cyuxSz/Argos-equipo/5_expo/README.md

# 5 · ExpoIngenierías y entregables

Encargados: todo el equipo. Plan del frente: [PLAN.md, Frente 5](../PLAN.md#frente-5--expoingenierías-entregables-y-coordinación).

Fuente: convocatoria de la 28.ª edición y página oficial https://expoingenierias-mty.github.io/pagina-inicio/ (resumen propio; ante cualquier duda manda la convocatoria).

## Fechas

| Fecha | Qué |
|---|---|
| lun 9 nov | Aviso de proyectos preseleccionados (por correo) |
| mar 10 nov | Arranque del equipo |
| mar 17 nov | Grabación del video |
| jue 19 nov | Video, reporte y perfil listos; meta: subirlos esa noche |
| **vie 20 nov, 23:59** | Límite para subir **video**, **reporte técnico** y **perfil del proyecto** |
| **mar 24 nov** | Subir la **foto de cada integrante**; aviso de seleccionados y stand |
| mié 25 – lun 30 nov | Muestra y concurso virtual |
| mar 1 dic, 12:00–17:00 | Concurso presencial en Arena Borregos; premiación a las 19:00 en Aulas 6 |

Categoría: **Desarrollo de prototipo físico** `[POR CONFIRMAR con el registro]`. El jurado pregunta qué se desarrolló, qué tan creativo es, si el prototipo funciona de forma robusta y consistente, qué técnicas de ingeniería se aplicaron y qué impacto tiene.

## Checklist del video (Anexo 4)

- [ ] MP4, entre **3 y 5 minutos**, nombre del archivo de **30 caracteres o menos**.
- [ ] Explicación con voz del equipo (no generado todo con IA); mostrar el proyecto **y** explicarlo.
- [ ] Presentación: nombre del proyecto, integrantes, profesor(es) tutor(es), nivel (profesional) y materia.
- [ ] Problema o necesidad.
- [ ] Qué es el proyecto, qué resuelve y cómo.
- [ ] Por qué es innovador.
- [ ] Alcance.
- [ ] Técnicas y herramientas de ingeniería, con diagramas o gráficas.
- [ ] Resultados más relevantes y conclusión.
- [ ] Impacto en la industria o la sociedad.
- [ ] Descripción del prototipo: características físicas, técnicas y de diseño.
- [ ] Demostración de que funciona igual siempre, de preferencia sobre fondo blanco.
- [ ] Imágenes o fragmentos de las pruebas.

## Checklist del reporte técnico (Anexo 5)

PDF, nombre de 30 caracteres o menos. Puede ser el reporte de la materia. Rubros recomendados: resumen, introducción, contexto, delimitación, planteamiento del problema, justificación, marco teórico, objetivos (general y específicos), hipótesis, metodología, técnicas y herramientas, infraestructura, recursos, resultados, conclusiones, bibliografía (APA 7) y anexos.

## Checklist del perfil (Anexo 6)

- [ ] **3 imágenes del proyecto** (la 1, de preferencia un GIF animado). Sin video y sin PDF.
- [ ] **Ninguna foto de integrantes** en estas imágenes (es motivo de descalificación).
- [ ] Imagen de fondo para la muestra virtual (PNG o JPG).
- [ ] Logo del equipo (opcional).

Material disponible: renders en `2_carcasas_3d/renders/`, diagramas en `diagramas/`, protoboard y esquemáticos en `1_electronica/`, modelo del cuarto en `2_carcasas_3d/modelo_cuarto/`.

## Fotos de integrantes

- [ ] Una por integrante, antes del 24 de nov (van aparte del perfil).

## Stand (1 dic)

Demo que no dependa del WiFi del lugar: laptop con el servidor, router propio, las 3 cajas y algo para provocar alertas (aire caliente o hielo para el DHT22, un imán para el MC-38, un golpe suave al anaquel de prueba). Si el hardware no está listo, demo con el simulador y el dashboard.

## Archivos

- [guion.md](guion.md): plantilla del guion del video.
- [preguntas_pendientes.md](preguntas_pendientes.md): preguntas para profesores y encargados del invernadero.
