cyuxSz/Argos-equipo/5_expo/guion.md

# Guion del video (plantilla, 4:30 min)

Llenar cada bloque con quién habla, qué se dice y qué se ve. Tiempos aproximados; total entre 3 y 5 min.

| # | Tiempo | Bloque | Qué se ve | Quién | Texto (borrador) |
|---|---|---|---|---|---|
| 1 | 0:00–0:20 | Presentación | Logo, nombre, integrantes, tutor(es), materia | | |
| 2 | 0:20–0:50 | Problema | Fotos del cuarto de incubación, frascos, temporizador mecánico | | |
| 3 | 0:50–1:20 | Solución | Diagrama de arquitectura | | |
| 4 | 1:20–1:40 | Innovación y alcance | | | |
| 5 | 1:40–2:40 | Técnicas de ingeniería | Esquemáticos, protoboard, CAD, BD, MQTT | | |
| 6 | 2:40–3:40 | Prototipo y demostración | Cajas (reales o renders), simulador, dashboard, alerta en el celular, fondo blanco | | |
| 7 | 3:40–4:10 | Resultados | Pruebas: tablas, capturas, gráficas | | |
| 8 | 4:10–4:30 | Impacto y cierre | | | |

Tomas que hay que grabar o capturar:

- [ ] Dashboard con datos en vivo (simulador o nodos reales).
- [ ] Alerta llegando al celular (WhatsApp o Telegram).
- [ ] Monitor serie o MQTT Explorer mostrando mensajes.
- [ ] Giro del modelo 3D en el visor.
- [ ] Cajas reales funcionando sobre fondo blanco (si llega el hardware).
