cyuxSz/Argos-equipo/1_electronica/esquematicos/nodo_luz_rele.png

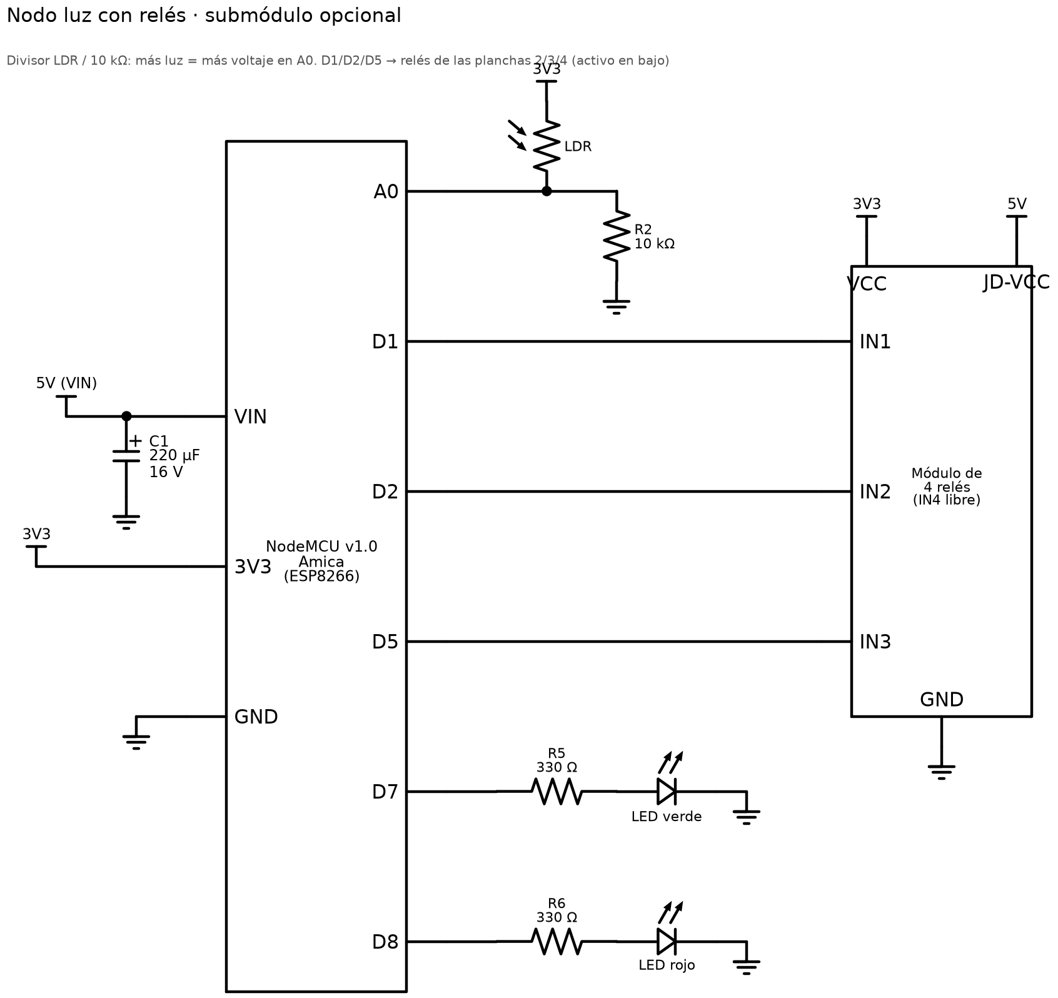
1_electronica/esquematicos/nodo_luz_rele.png
