cyuxSz/Argos-equipo/1_electronica/fritzing/nodo_acel_breadboard.png

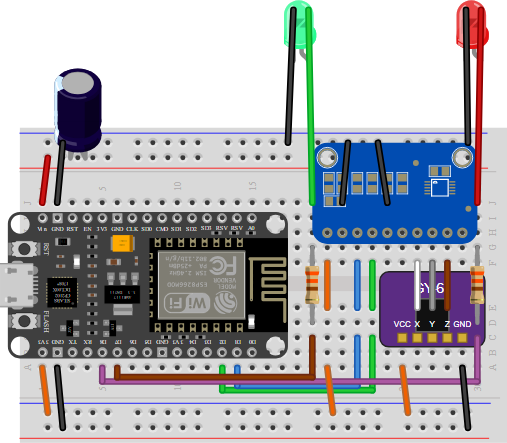
1_electronica/fritzing/nodo_acel_breadboard.png
