cyuxSz/Argos-equipo/1_electronica/fritzing/nodo_acel_schematic.png

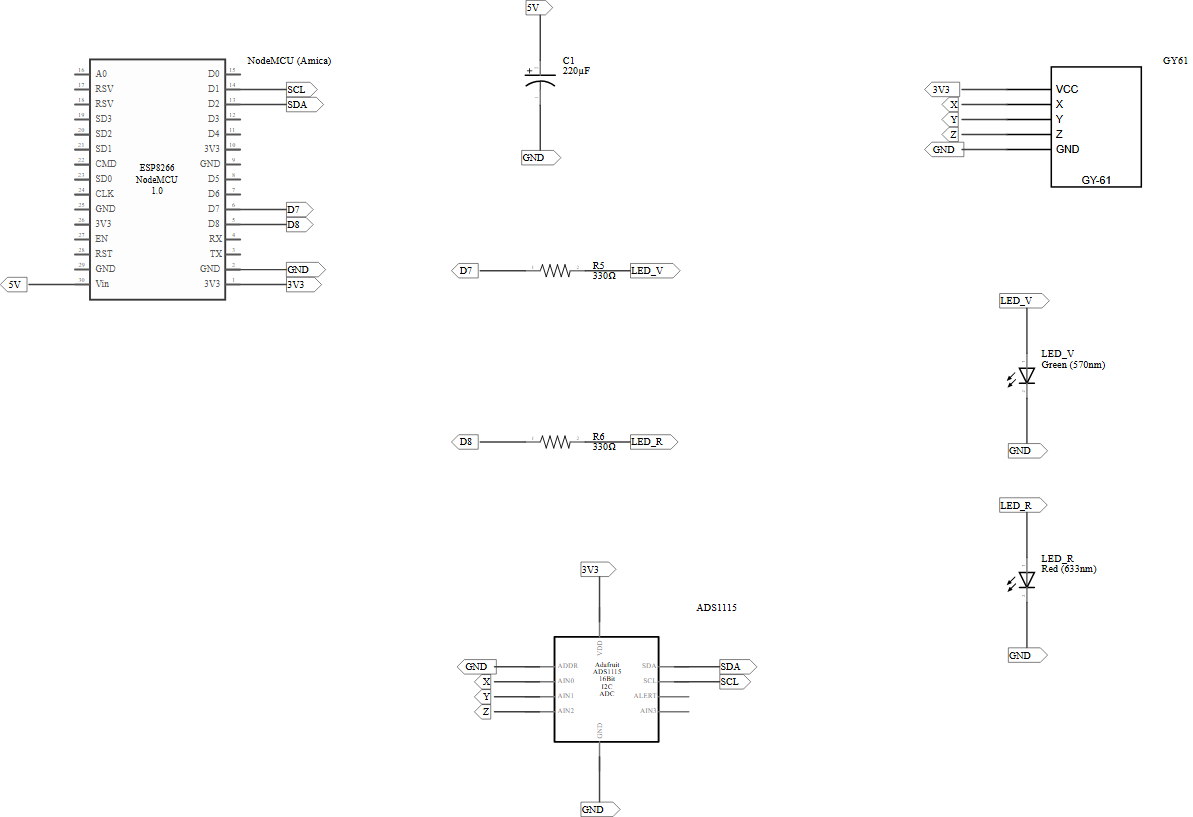
1_electronica/fritzing/nodo_acel_schematic.png
