cyuxSz/Argos-equipo/1_electronica/fritzing/nodo_dht_breadboard.png

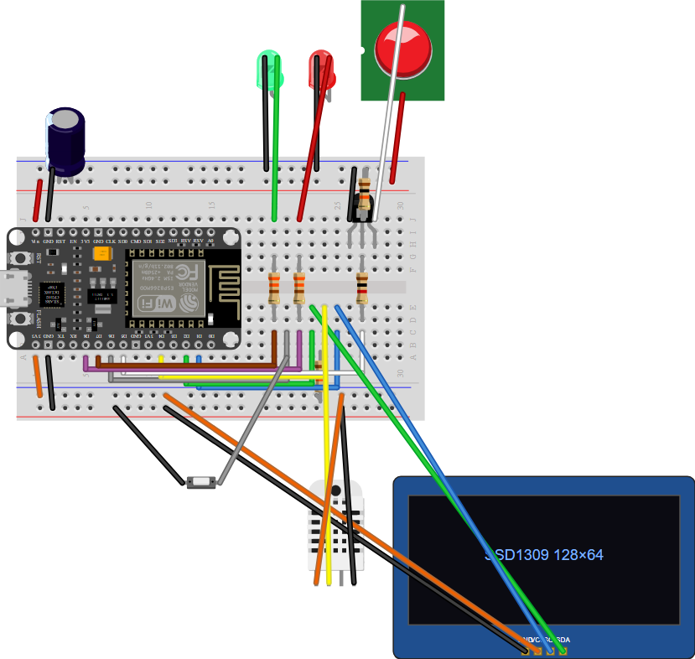
1_electronica/fritzing/nodo_dht_breadboard.png
