cyuxSz/Argos-equipo/1_electronica/fritzing/nodo_dht_schematic.png

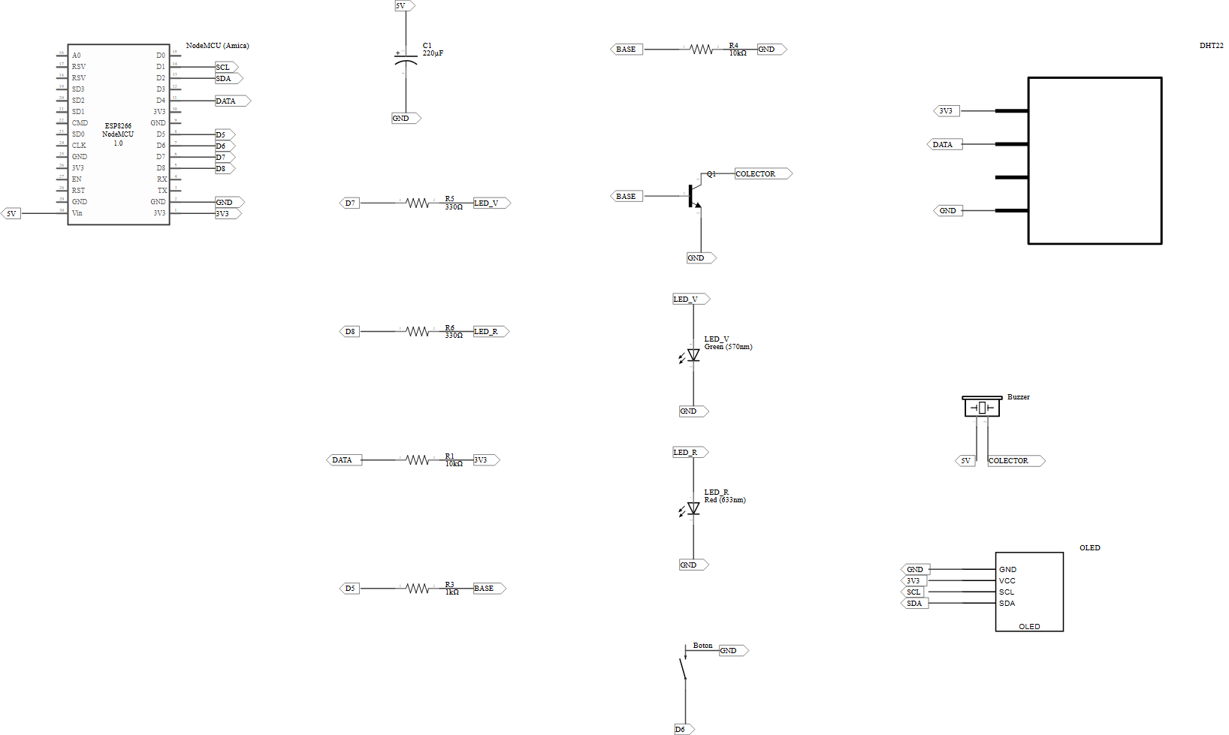
1_electronica/fritzing/nodo_dht_schematic.png
