cyuxSz/Argos-equipo/1_electronica/fritzing/nodo_luz_breadboard.png

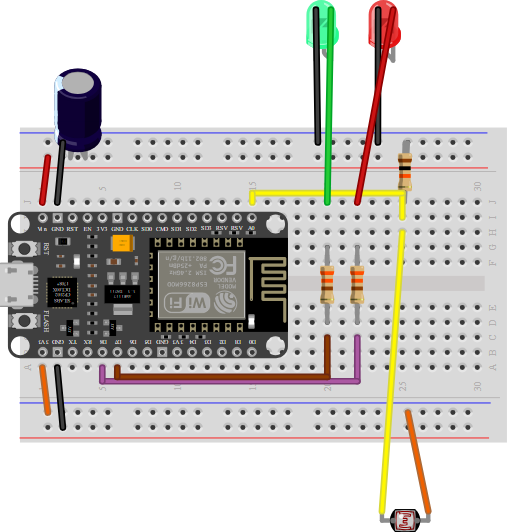
1_electronica/fritzing/nodo_luz_breadboard.png
