cyuxSz/Argos-equipo/1_electronica/fritzing/nodo_luz_schematic.png

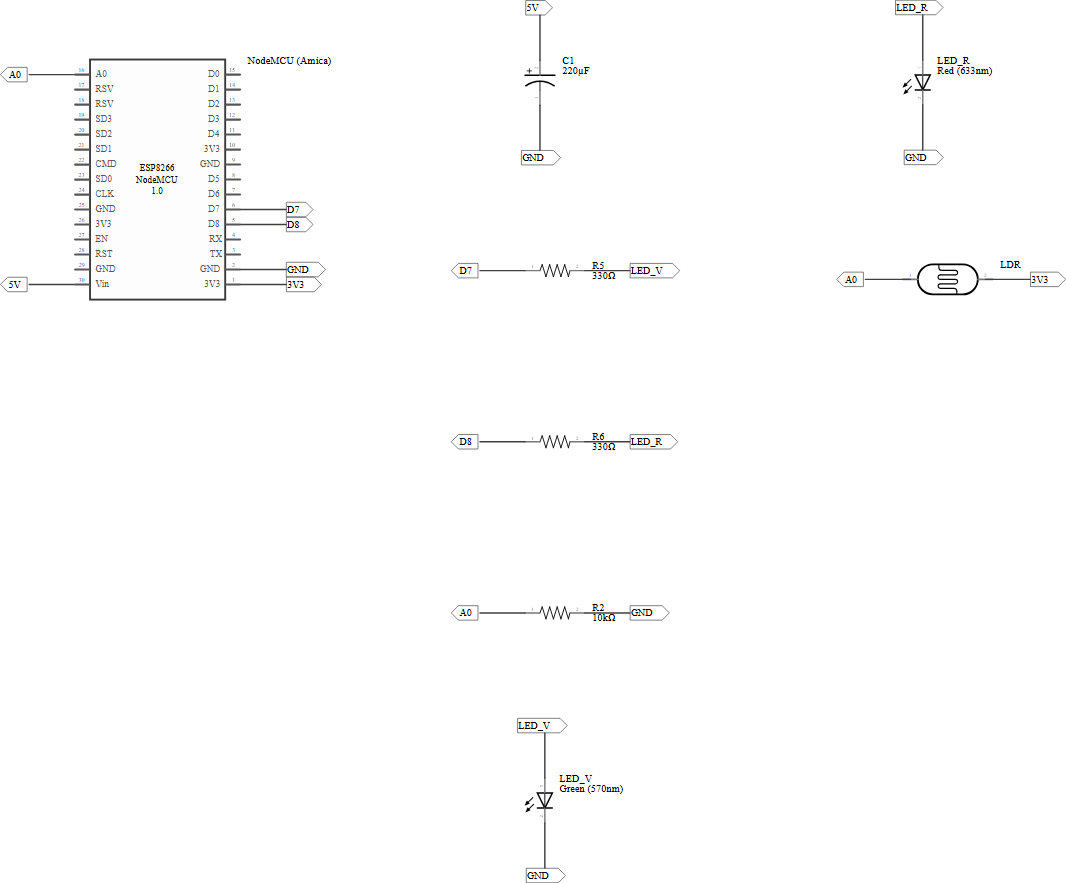
1_electronica/fritzing/nodo_luz_schematic.png
