cyuxSz/Argos-equipo/1_electronica/fritzing/nodo_pir_breadboard.png

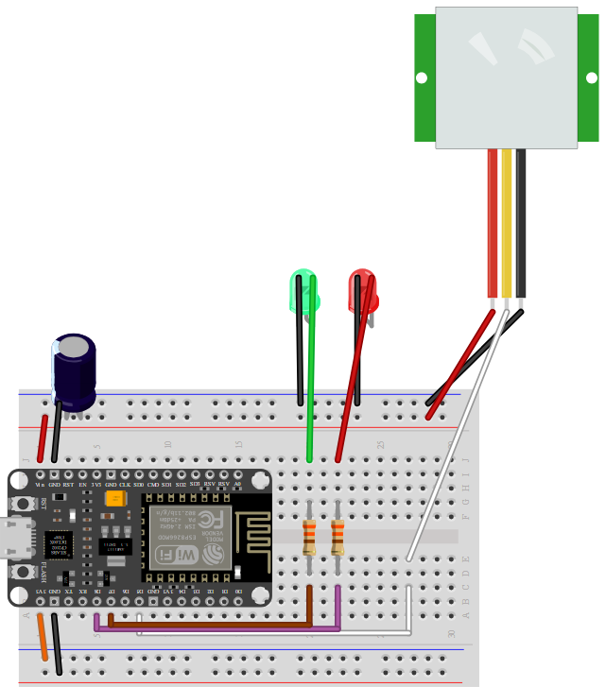
1_electronica/fritzing/nodo_pir_breadboard.png
