cyuxSz/Argos-equipo/1_electronica/fritzing/nodo_pir_schematic.png

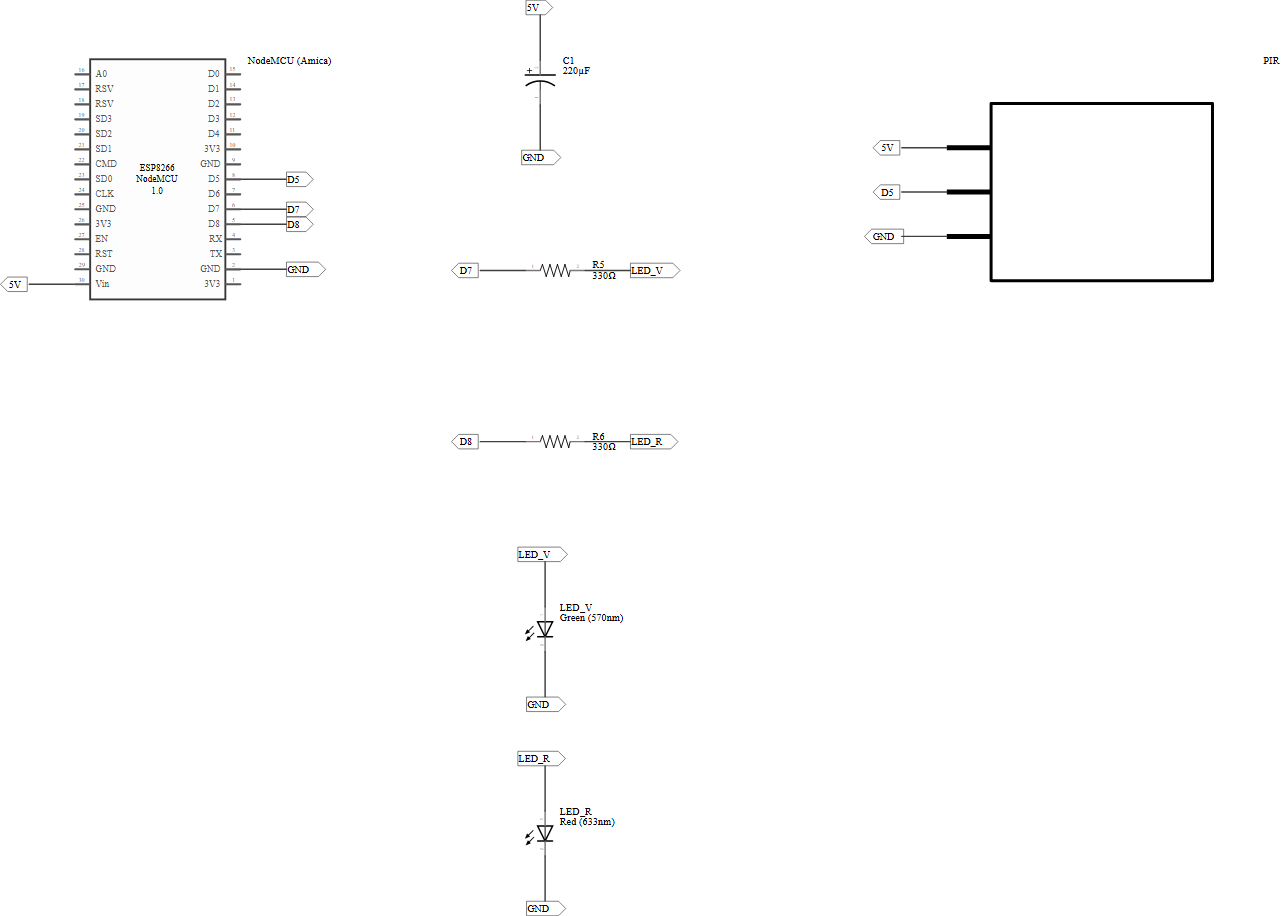
1_electronica/fritzing/nodo_pir_schematic.png
