cyuxSz/Argos-equipo/1_electronica/fritzing/nodo_puerta_schematic.png

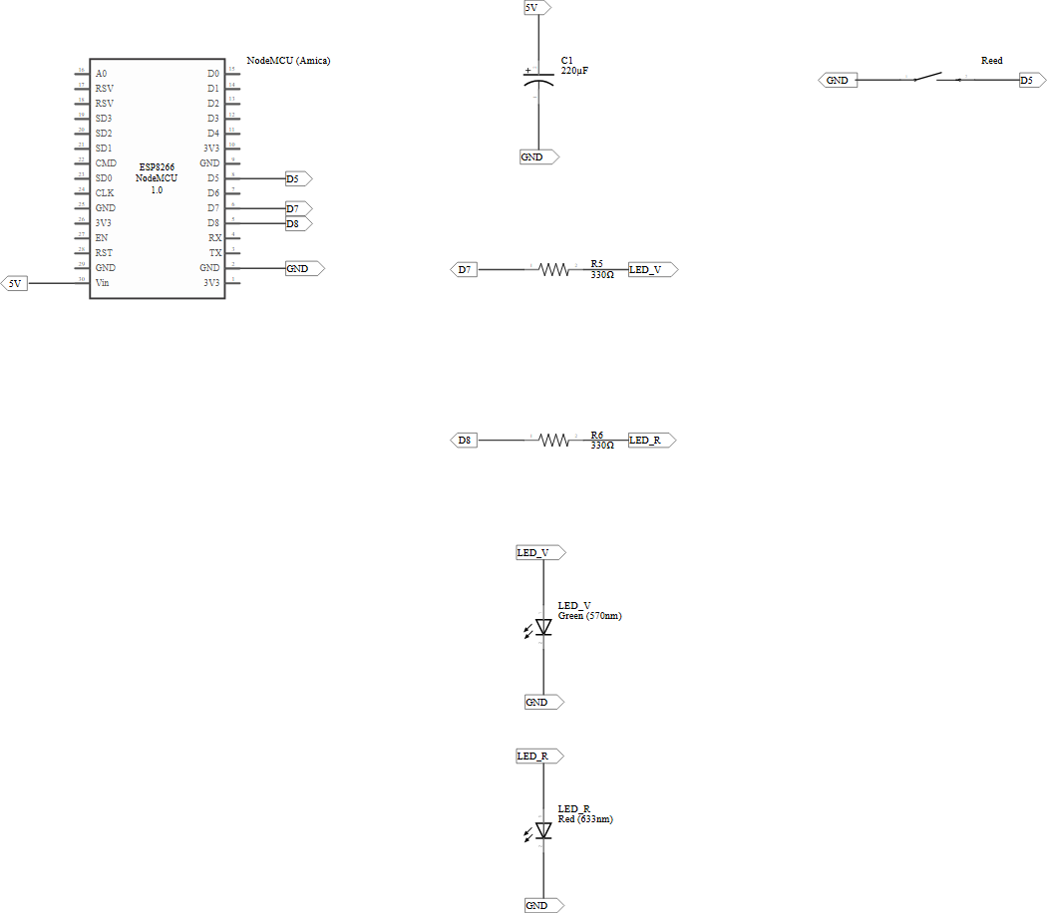
1_electronica/fritzing/nodo_puerta_schematic.png
