cyuxSz/Argos-equipo/1_electronica/protoboard/estacion_anaquel_rele_protoboard.png

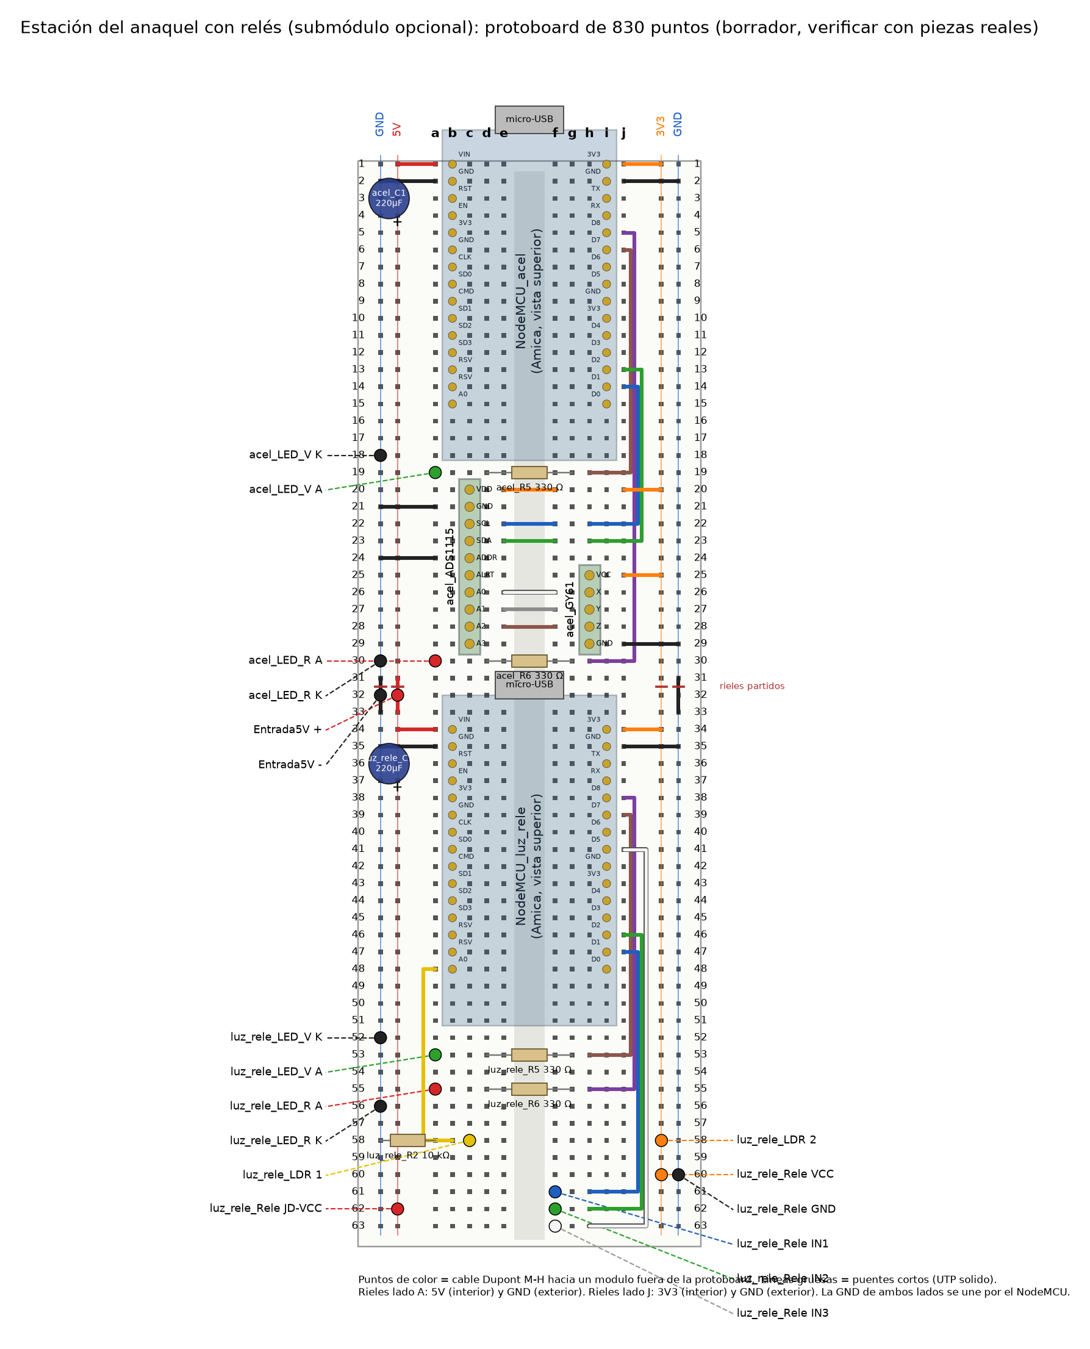
1_electronica/protoboard/estacion_anaquel_rele_protoboard.png
