cyuxSz/Argos-equipo/1_electronica/protoboard/nodo_acel_protoboard.png

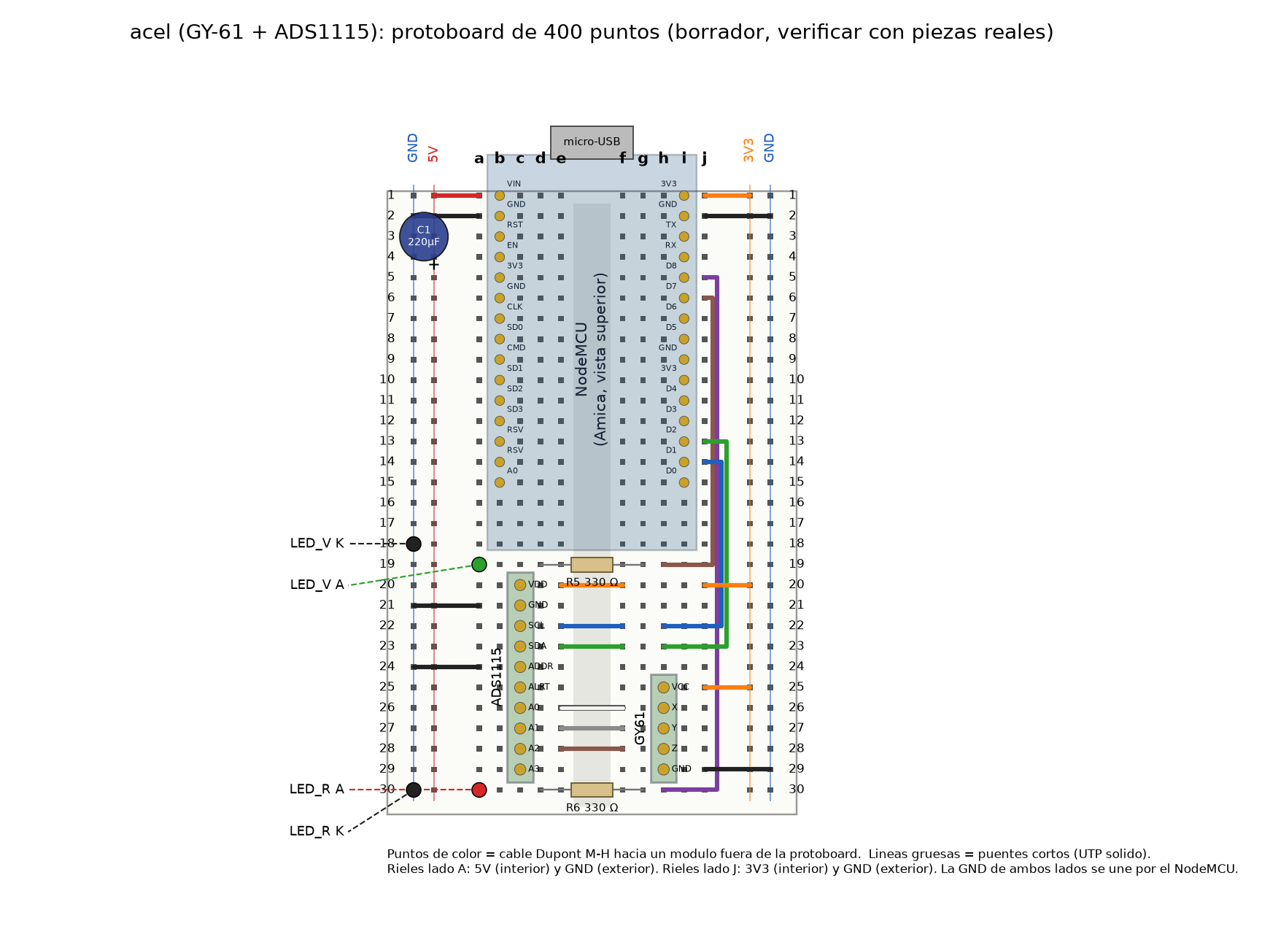
1_electronica/protoboard/nodo_acel_protoboard.png
