cyuxSz/Argos-equipo/1_electronica/protoboard/nodo_dht_sin_oled_protoboard.png

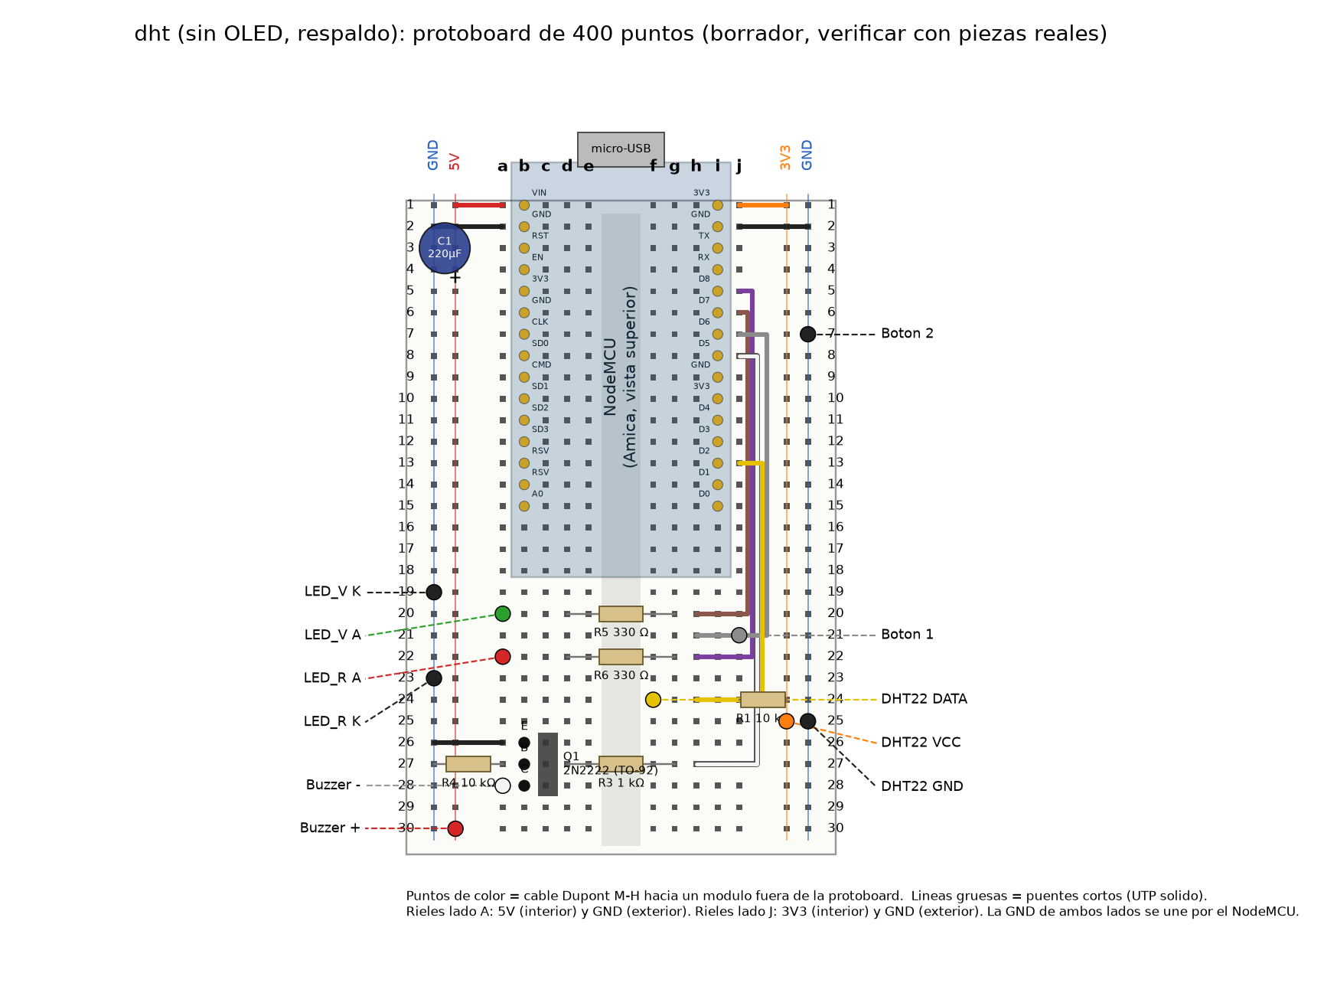
1_electronica/protoboard/nodo_dht_sin_oled_protoboard.png
