cyuxSz/Argos-equipo/1_electronica/protoboard/nodo_luz_rele_protoboard.png

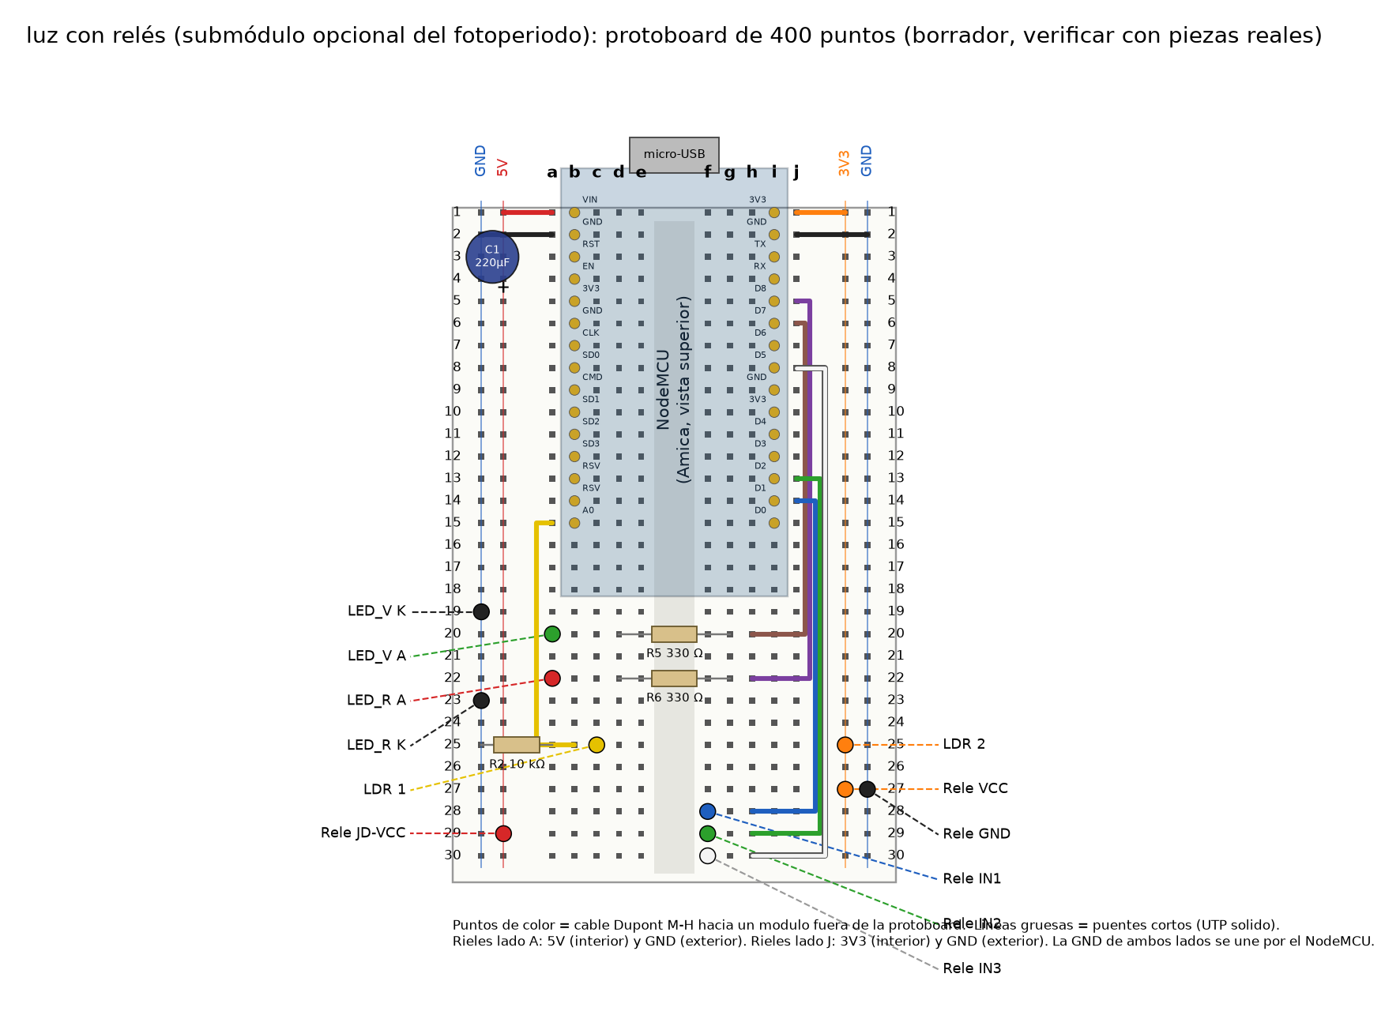
1_electronica/protoboard/nodo_luz_rele_protoboard.png
