cyuxSz/Argos-equipo/1_electronica/protoboard/nodo_pir_protoboard.png

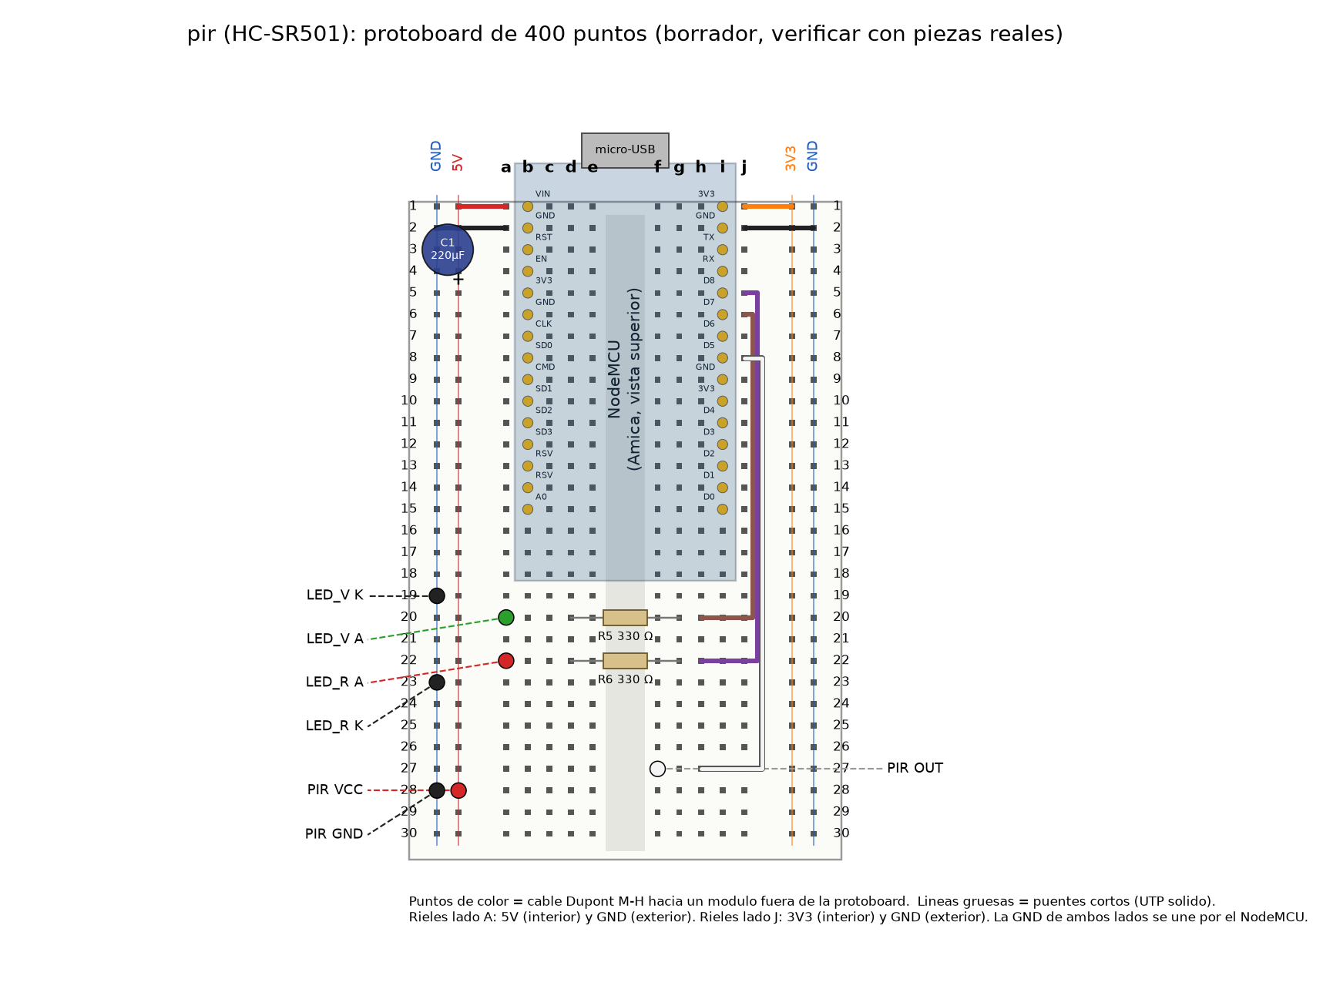
1_electronica/protoboard/nodo_pir_protoboard.png
