cyuxSz/Argos-equipo/2_carcasas_3d/renders/accesorios_conexion.png

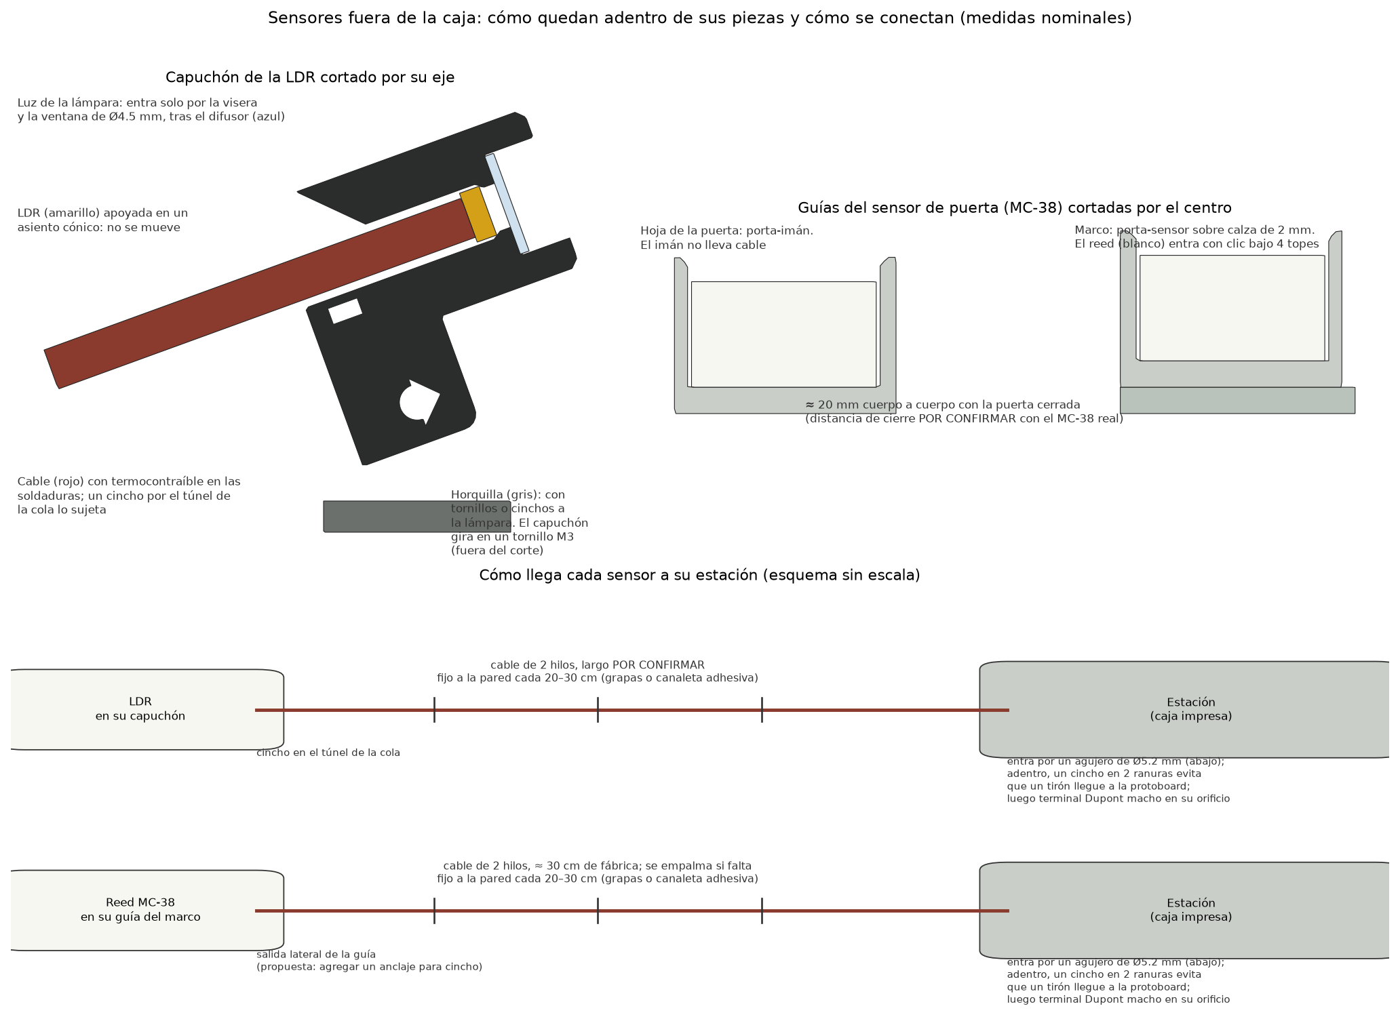
2_carcasas_3d/renders/accesorios_conexion.png
