cyuxSz/Argos-equipo/2_carcasas_3d/renders/caja_potencia_interior.png

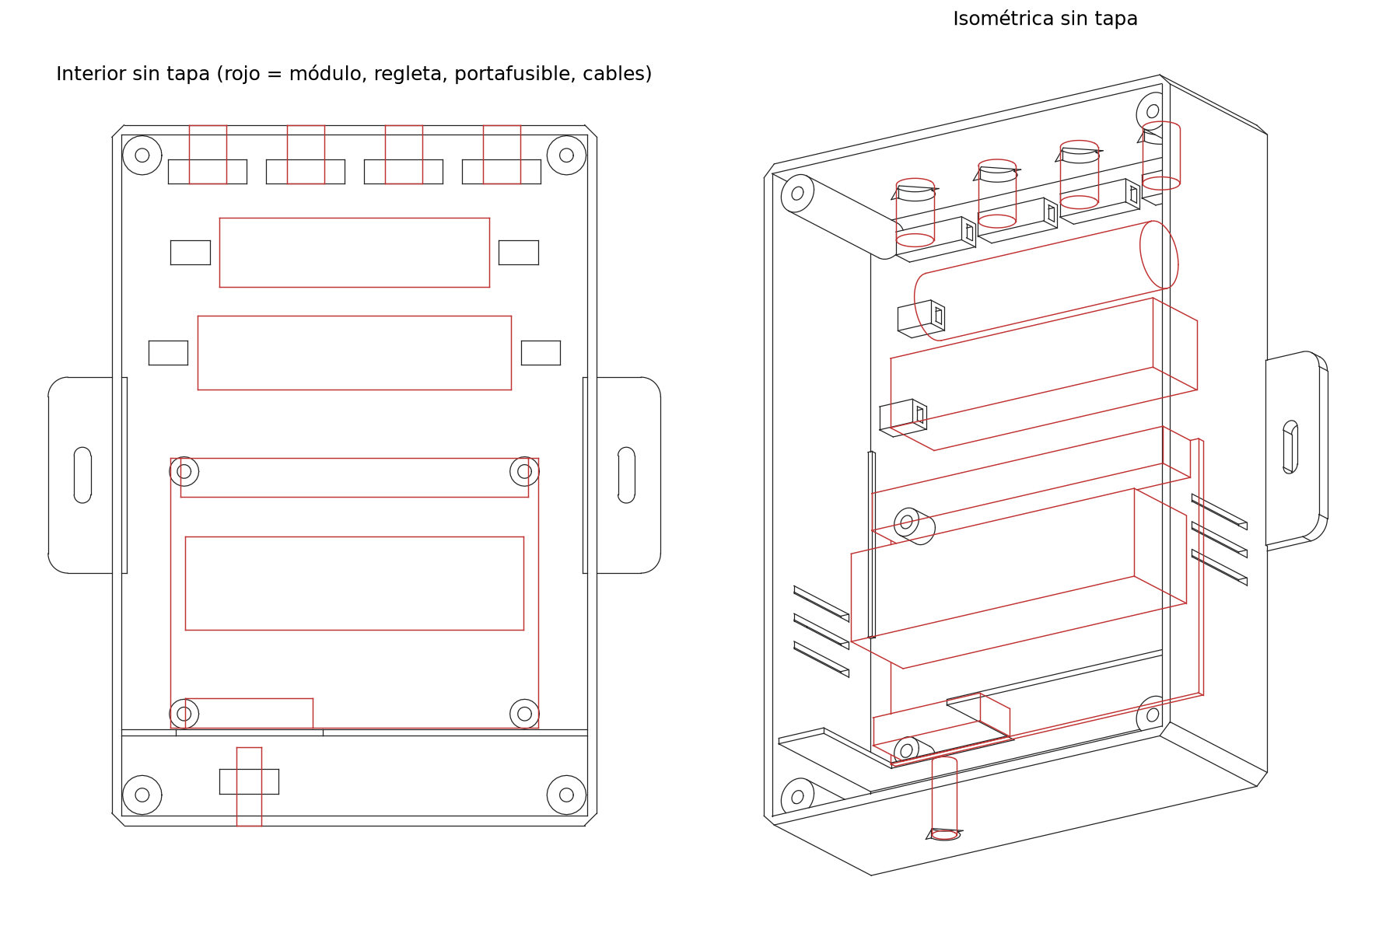
2_carcasas_3d/renders/caja_potencia_interior.png
