cyuxSz/Argos-equipo/2_carcasas_3d/renders/capuchon_ldr_corte.png

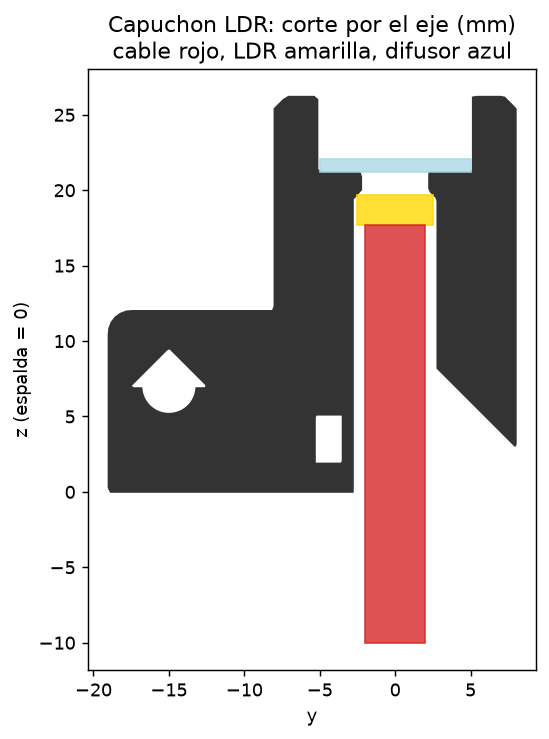
2_carcasas_3d/renders/capuchon_ldr_corte.png
