cyuxSz/Argos-equipo/2_carcasas_3d/renders/cuarto_desde_puerta.png

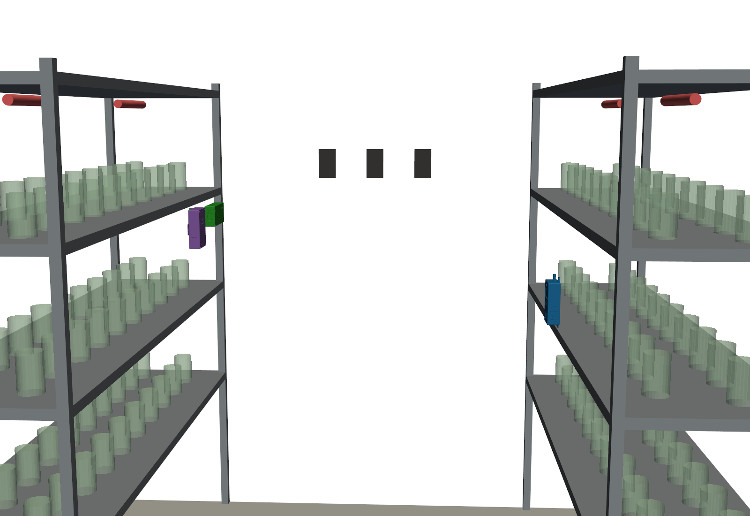
2_carcasas_3d/renders/cuarto_desde_puerta.png
