cyuxSz/Argos-equipo/2_carcasas_3d/renders/cuarto_zoom_anaquel.png

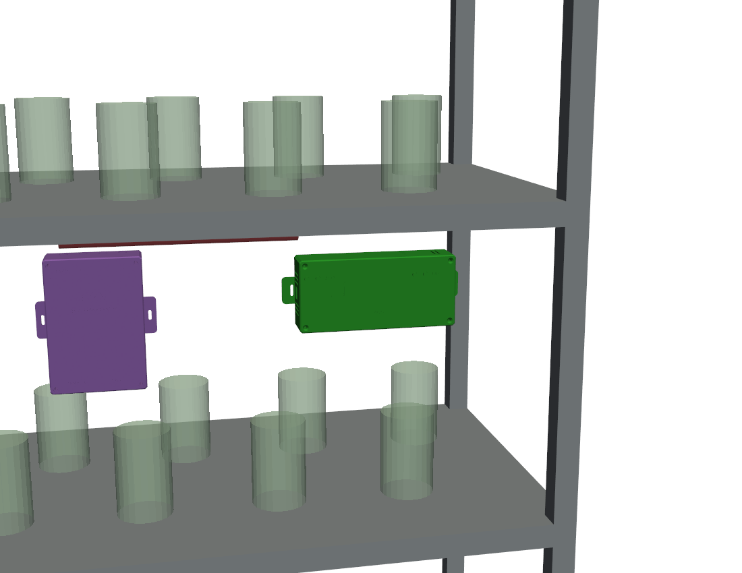
2_carcasas_3d/renders/cuarto_zoom_anaquel.png
