cyuxSz/Argos-equipo/2_carcasas_3d/renders/cuarto_zoom_dht.png

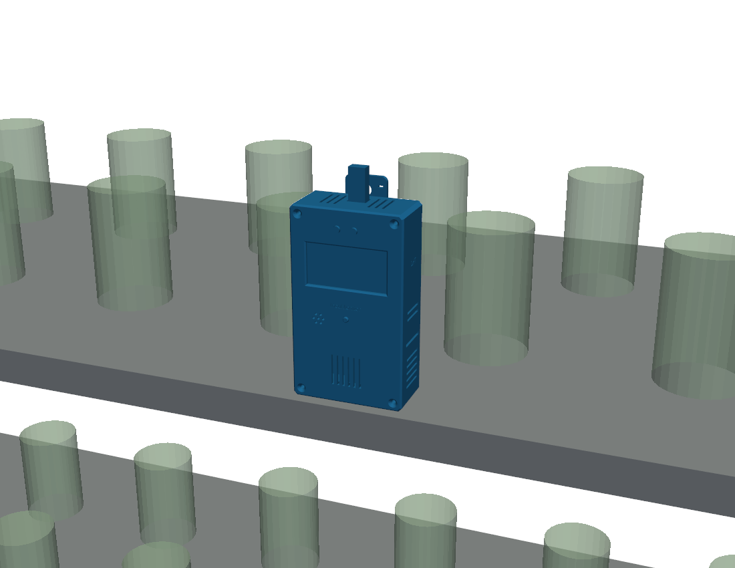
2_carcasas_3d/renders/cuarto_zoom_dht.png
