cyuxSz/Argos-equipo/2_carcasas_3d/renders/modular/modular_dht_detalle_clip.png

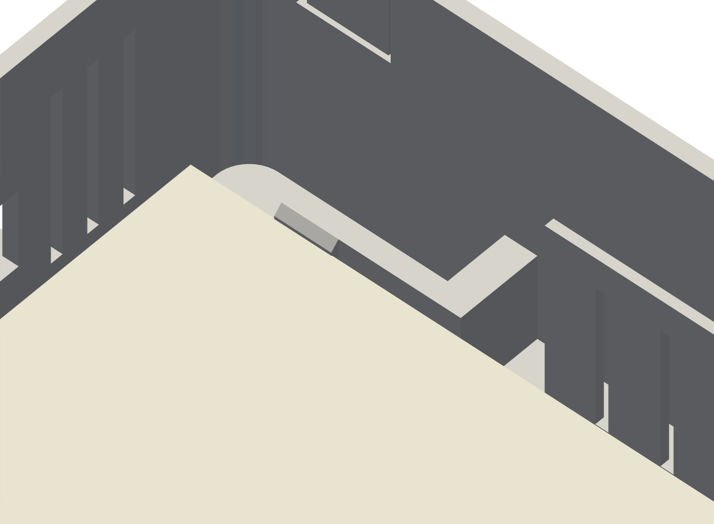
2_carcasas_3d/renders/modular/modular_dht_detalle_clip.png
