cyuxSz/Argos-equipo/2_carcasas_3d/renders/modular/nodo_anaquel_rele_vistas.png

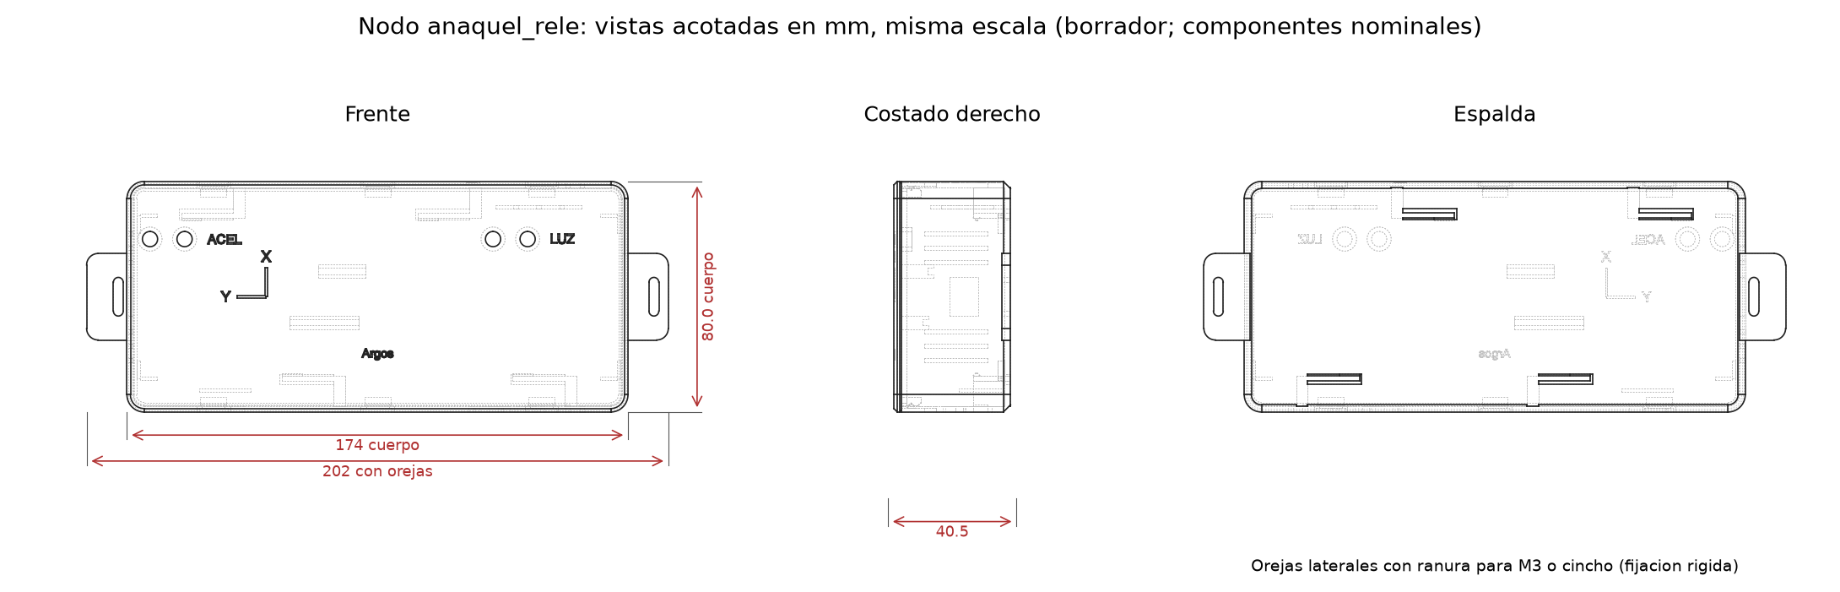
2_carcasas_3d/renders/modular/nodo_anaquel_rele_vistas.png
