cyuxSz/Argos-equipo/2_carcasas_3d/renders/modular/nodo_dht_vistas.png

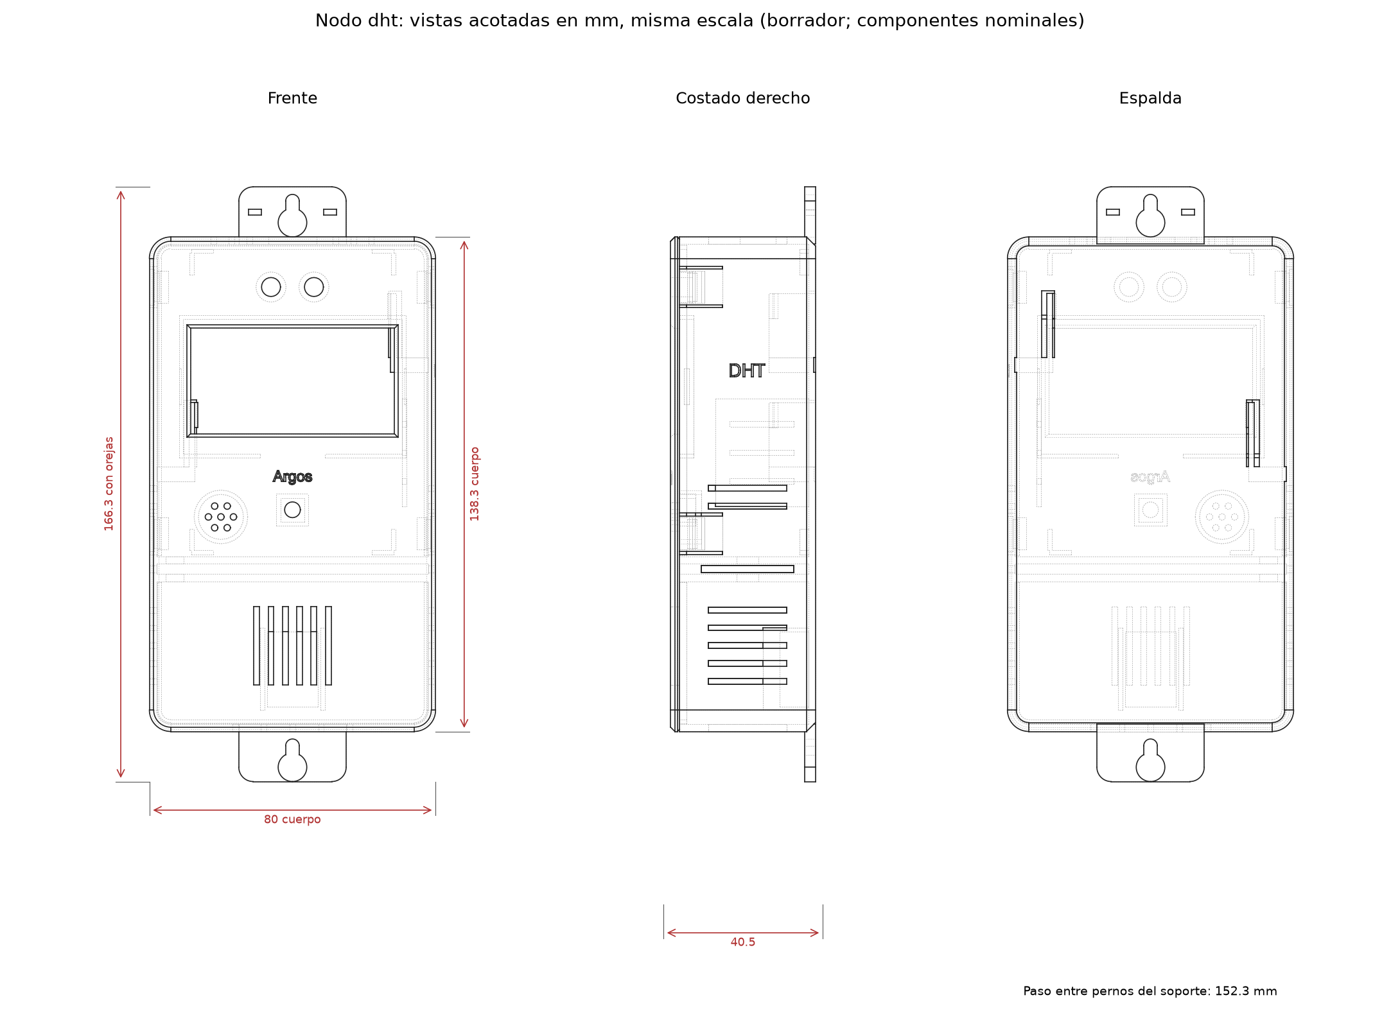
2_carcasas_3d/renders/modular/nodo_dht_vistas.png
