cyuxSz/Argos-equipo/2_carcasas_3d/renders/niveles_anaquel.png

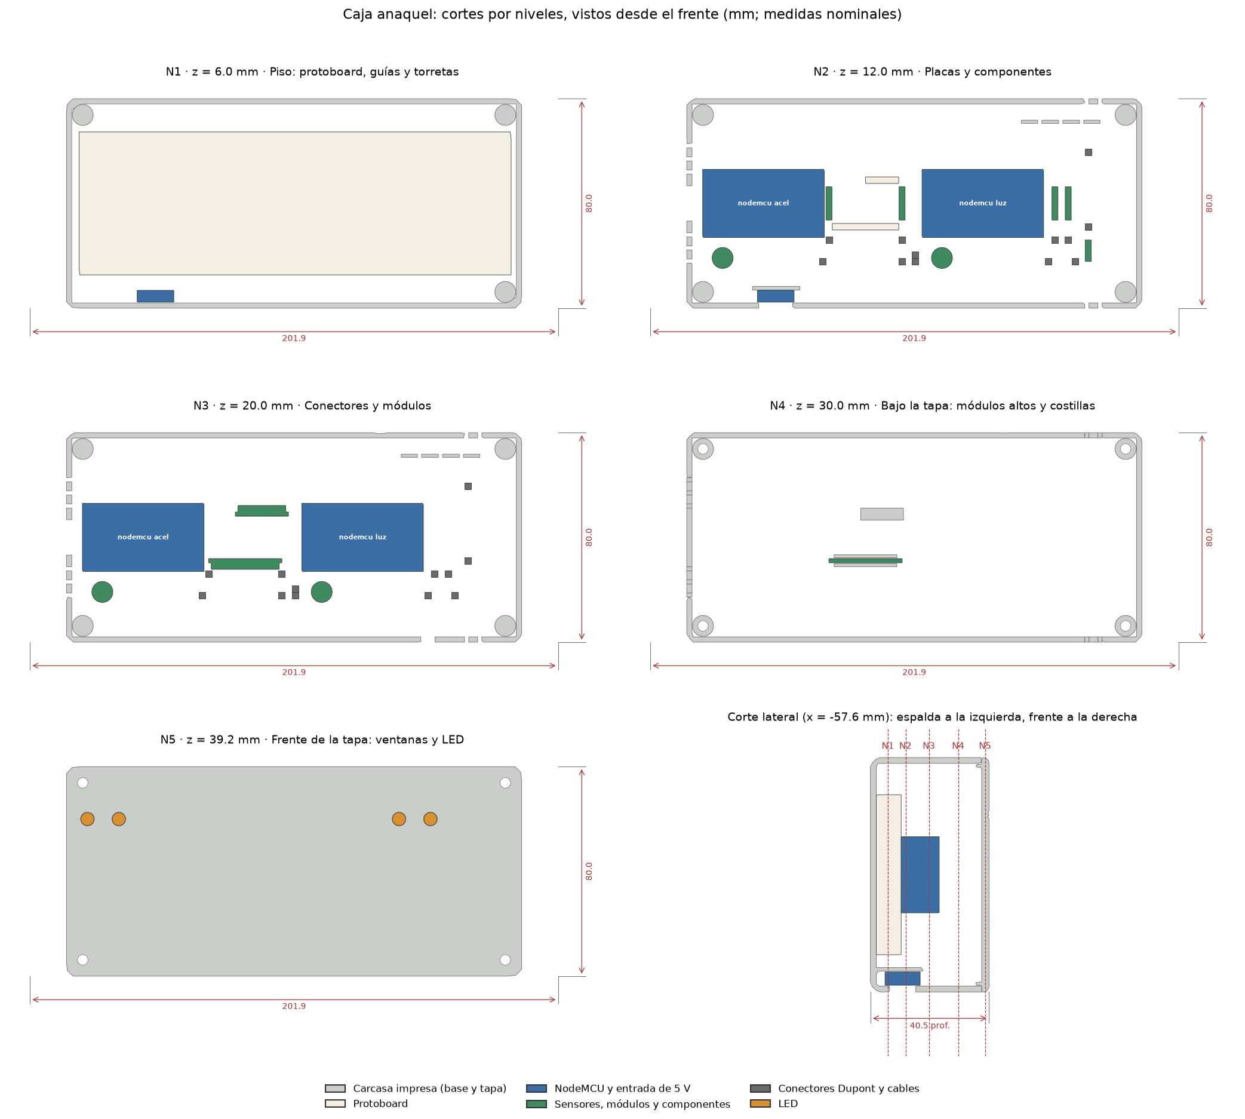
2_carcasas_3d/renders/niveles_anaquel.png
