cyuxSz/Argos-equipo/2_carcasas_3d/renders/niveles_dht.png

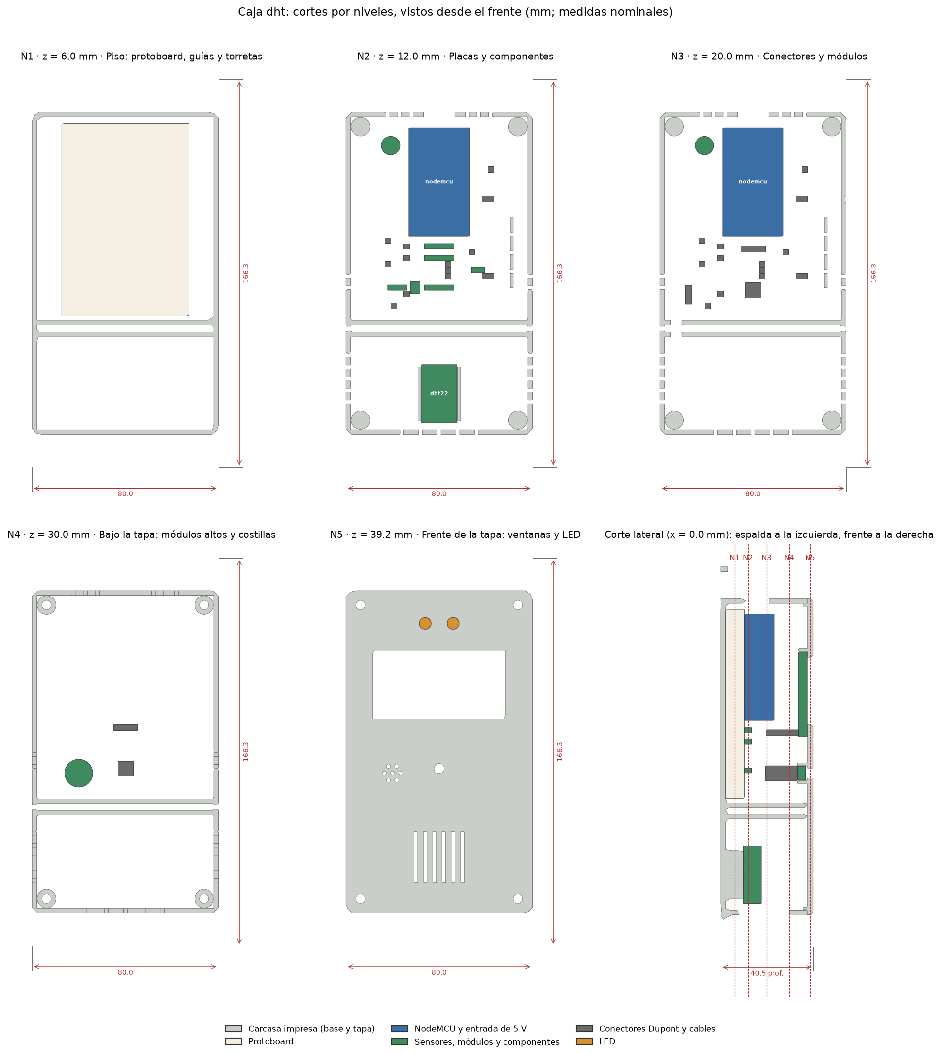
2_carcasas_3d/renders/niveles_dht.png
