cyuxSz/Argos-equipo/2_carcasas_3d/renders/nodo_dht_vistas.png

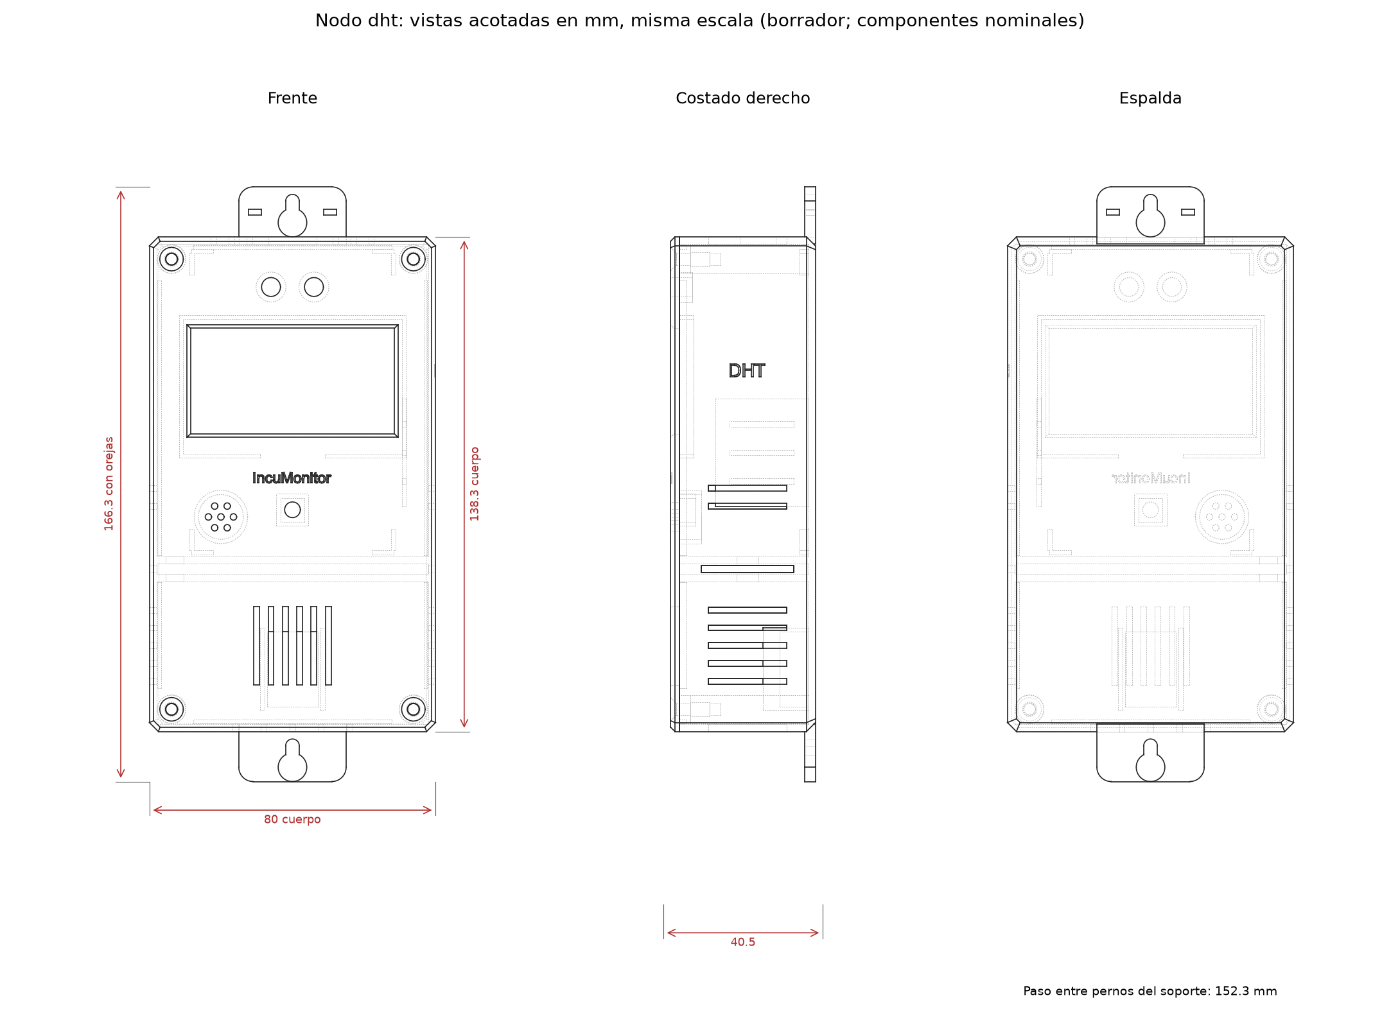
2_carcasas_3d/renders/nodo_dht_vistas.png
