cyuxSz/Argos-equipo/2_carcasas_3d/renders/nodo_entrada_vistas.png

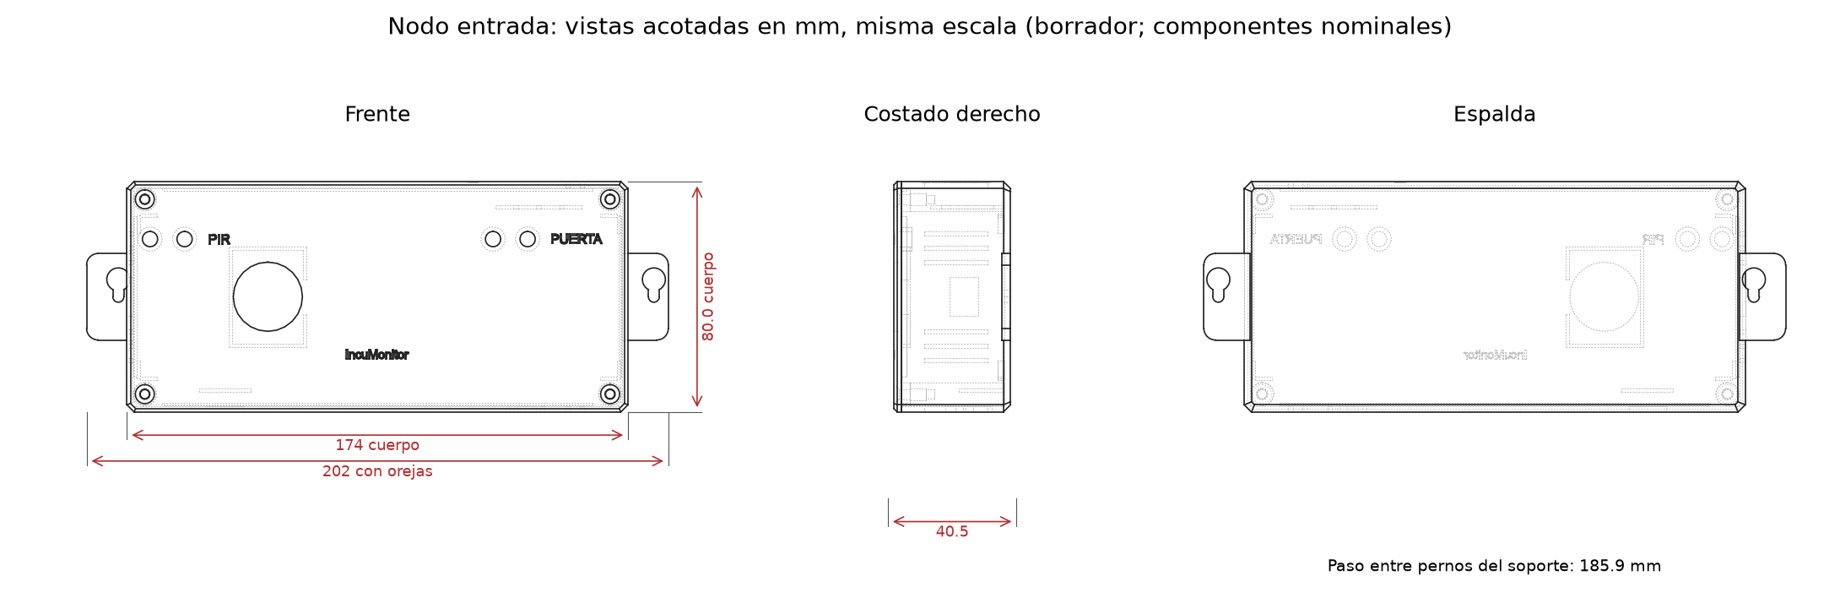
2_carcasas_3d/renders/nodo_entrada_vistas.png
