cyuxSz/Argos-equipo/2_carcasas_3d/renders/nodo_potencia_vistas.png

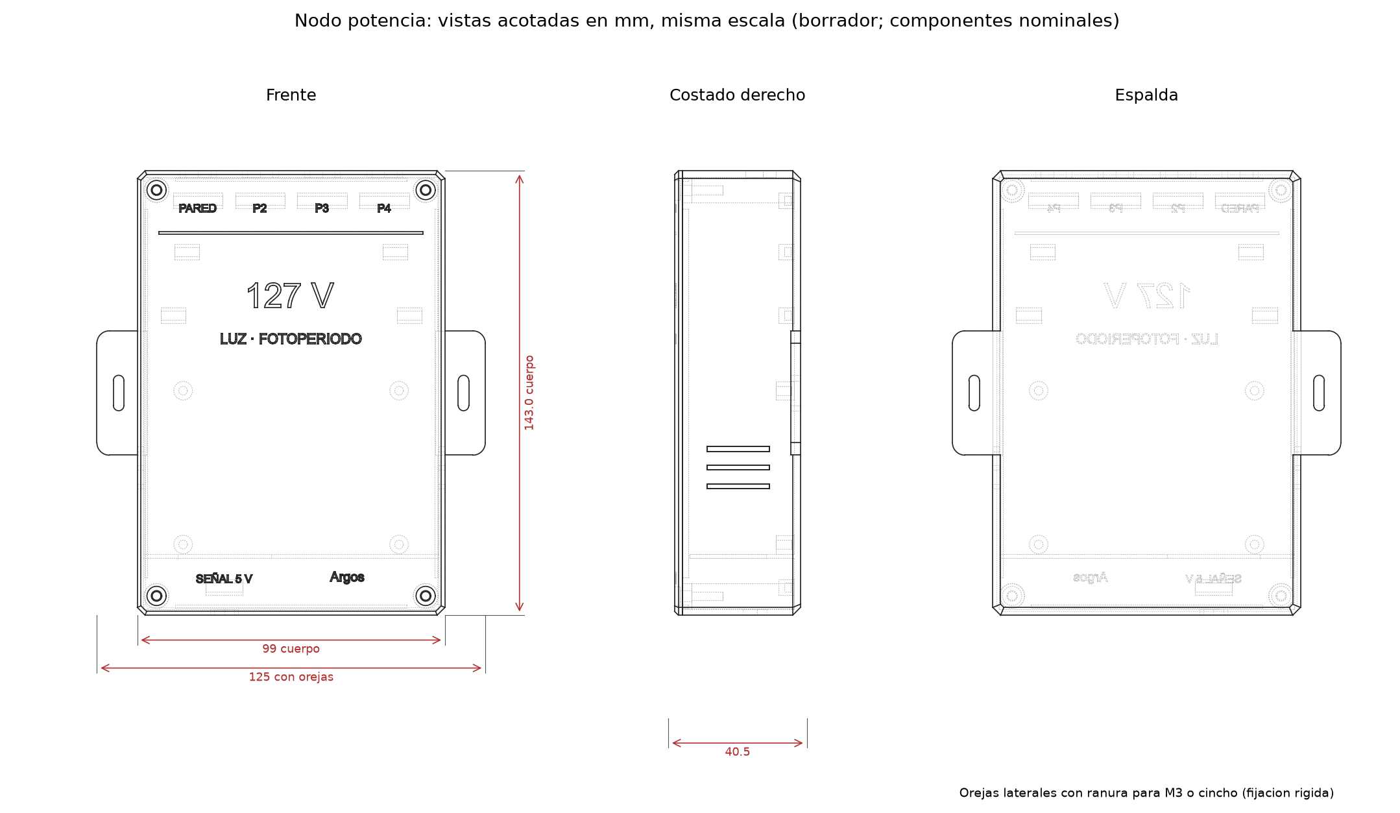
2_carcasas_3d/renders/nodo_potencia_vistas.png
