cyuxSz/Argos-equipo/2_carcasas_3d/renders/soporte_ldr_iso.png

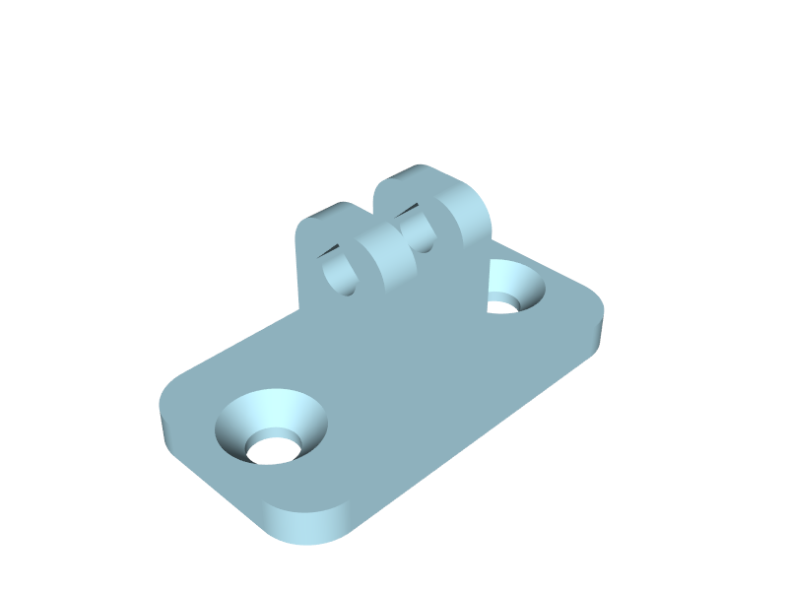
2_carcasas_3d/renders/soporte_ldr_iso.png
