cyuxSz/Argos-equipo/2_carcasas_3d/imprimir/3mf/nodo_anaquel_difusor_ldr.3mf

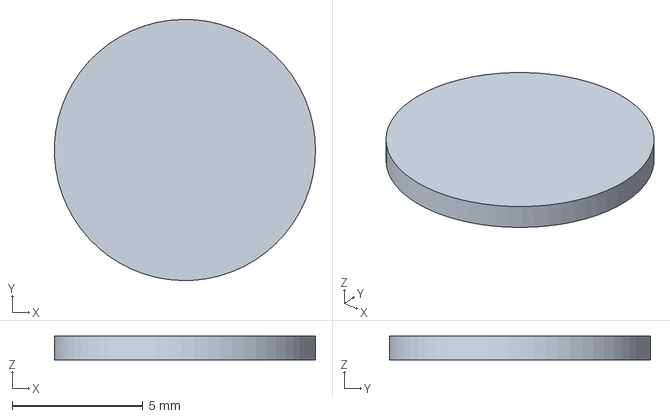
[picture p66: CAD file, 2026-11-09]
2_carcasas_3d/imprimir/3mf/nodo_anaquel_difusor_ldr.3mf
9.99 x 10.00 x 0.9 mm
