cyuxSz/Argos-equipo/2_carcasas_3d/imprimir/modular_stl/nodo_anaquel_base.stl

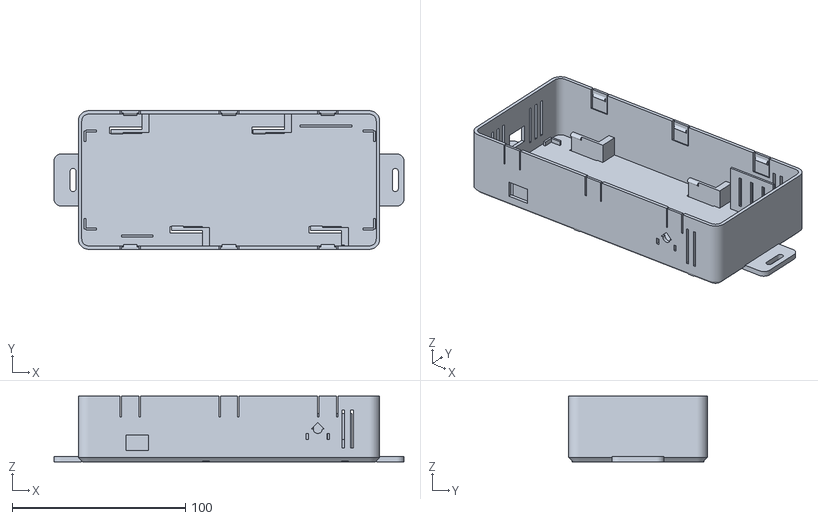
[picture p67: CAD file, 2026-11-10]
2_carcasas_3d/imprimir/modular_stl/nodo_anaquel_base.stl
201.9 x 80.0 x 38.0
