cyuxSz/Argos-equipo/2_carcasas_3d/imprimir/pruebas_ajuste/prueba_clips_tira.stl

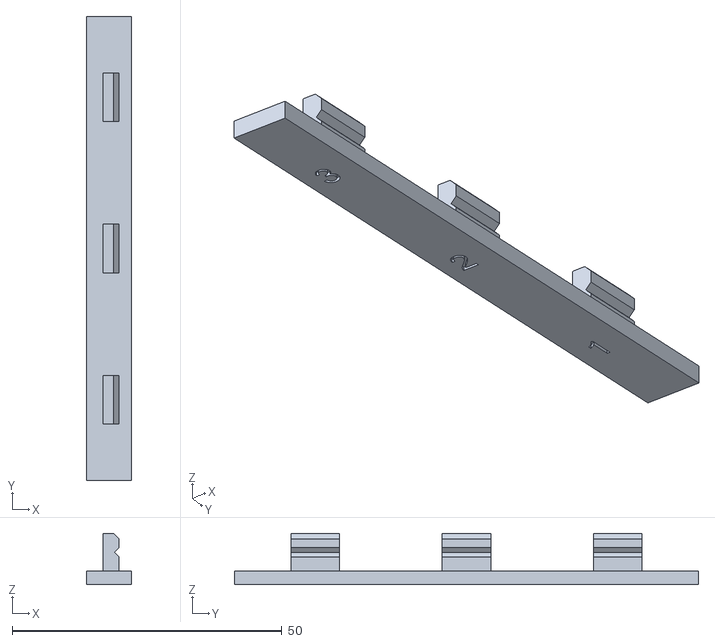
[picture p68: CAD file, 2026-11-10]
2_carcasas_3d/imprimir/pruebas_ajuste/prueba_clips_tira.stl
8.30 x 86.0 x 9.50
