cyuxSz/Argos-equipo/2_carcasas_3d/imprimir/stl/nodo_potencia_tapa.stl

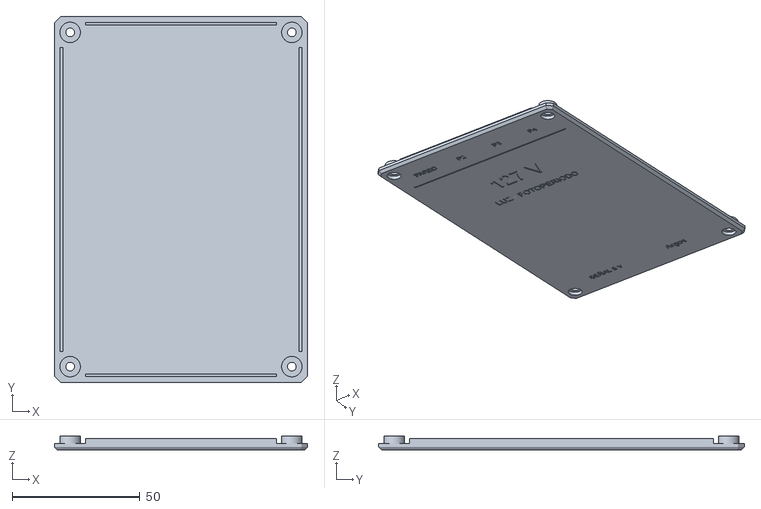
[picture p69: CAD file, 2026-11-09]
2_carcasas_3d/imprimir/stl/nodo_potencia_tapa.stl
99.0 x 143.0 x 5.50
