cyuxSz/Argos-equipo/2_carcasas_3d/visor/modelos/anaquel_led_r.stl

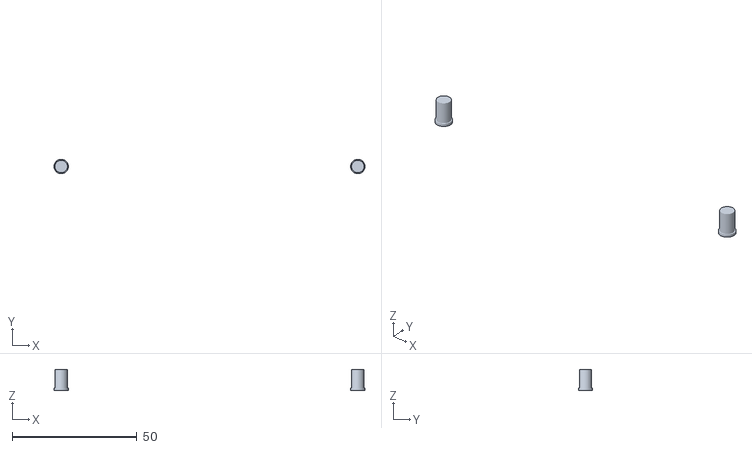
[picture p70: CAD file, 2026-11-09]
2_carcasas_3d/visor/modelos/anaquel_led_r.stl
124.9 x 5.80 x 8.60
