cyuxSz/Argos-equipo/2_carcasas_3d/imprimir/3mf/nodo_entrada_soporte_pared.3mf

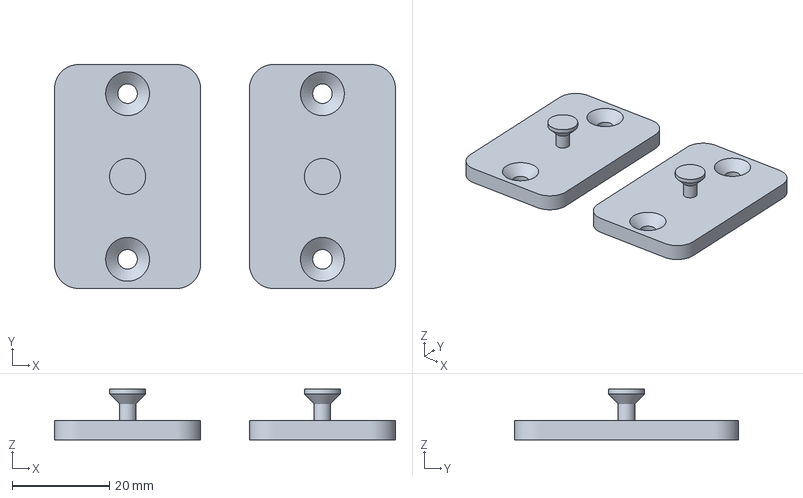
[picture p71: CAD file, 2026-11-09]
2_carcasas_3d/imprimir/3mf/nodo_entrada_soporte_pared.3mf
70.0 x 46.0 x 10.4 mm
