cyuxSz/Argos-equipo/2_carcasas_3d/imprimir/pruebas_ajuste/prueba_clips_base.stl

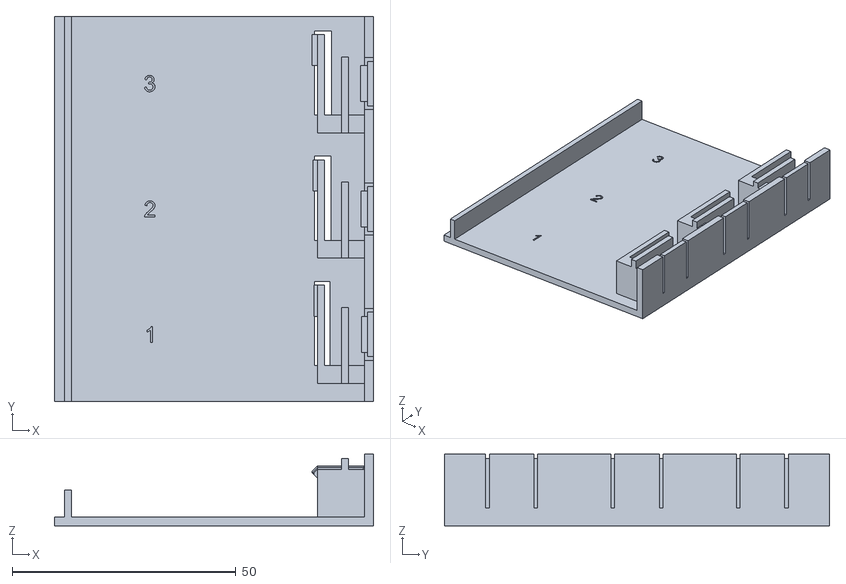
[picture p72: CAD file, 2026-11-10]
2_carcasas_3d/imprimir/pruebas_ajuste/prueba_clips_base.stl
71.3 x 86.0 x 16.0
