cyuxSz/Argos-equipo/2_carcasas_3d/imprimir/stl/nodo_potencia_base.stl

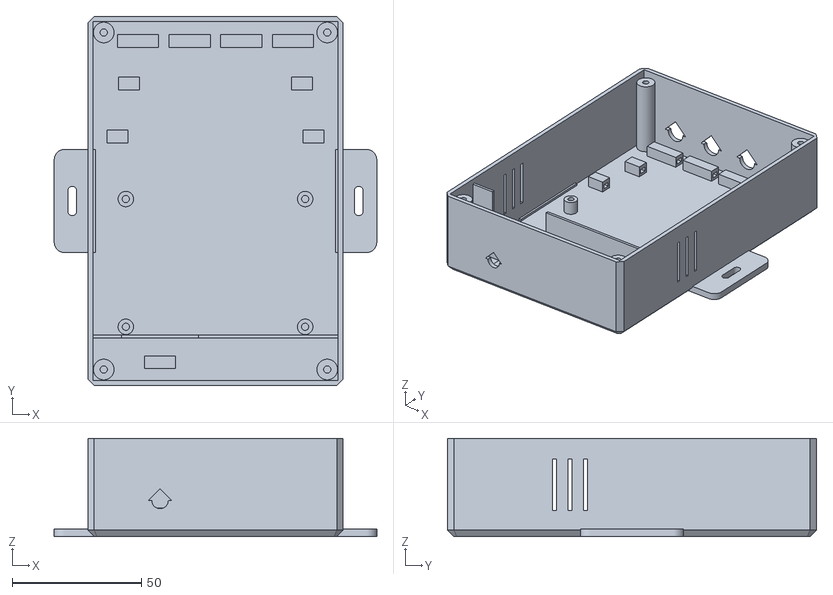
[picture p73: CAD file, 2026-11-09]
2_carcasas_3d/imprimir/stl/nodo_potencia_base.stl
125.0 x 143.0 x 38.0
