cyuxSz/Argos-equipo/2_carcasas_3d/visor/modelos/entrada_modulos.stl

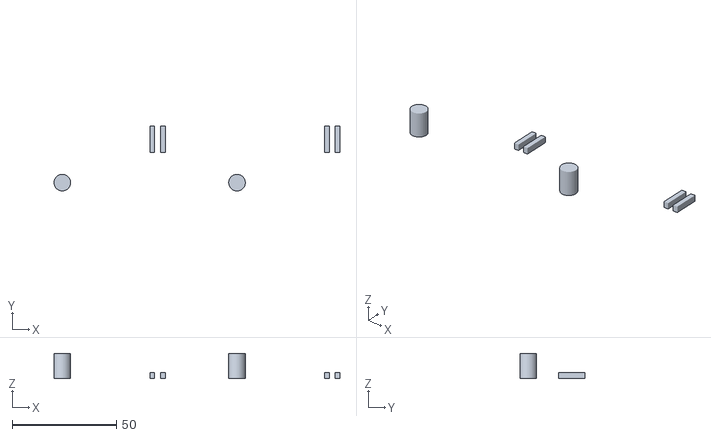
[picture p74: CAD file, 2026-11-09]
2_carcasas_3d/visor/modelos/entrada_modulos.stl
137.2 x 31.2 x 12.0
