cyuxSz/Argos-equipo/2_carcasas_3d/imprimir/3mf/nodo_dht_soporte_anaquel.3mf

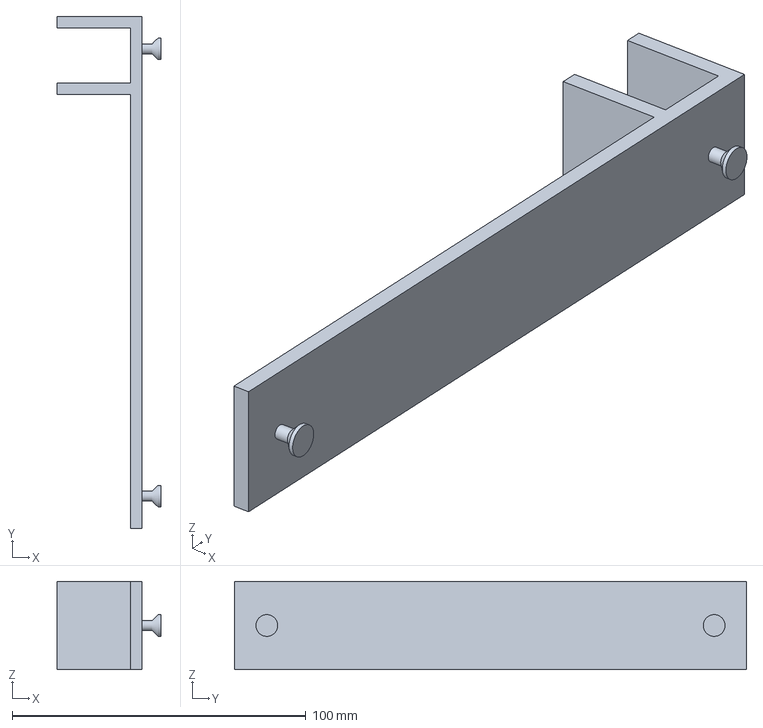
[picture p75: CAD file, 2026-11-09]
2_carcasas_3d/imprimir/3mf/nodo_dht_soporte_anaquel.3mf
35.4 x 174.3 x 30.0 mm
