cyuxSz/Argos-equipo/2_carcasas_3d/imprimir/modular_stl/nodo_anaquel_tapa.stl

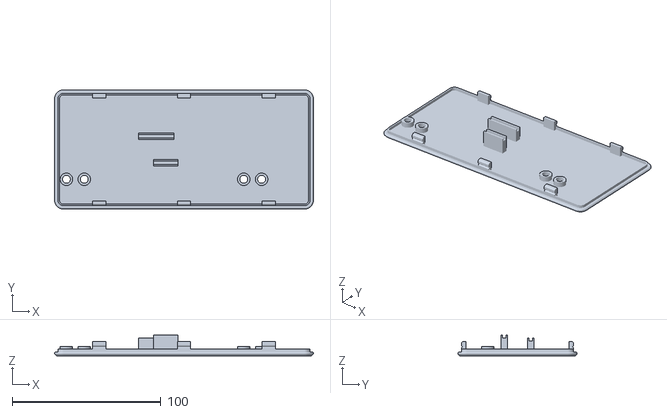
[picture p76: CAD file, 2026-11-10]
2_carcasas_3d/imprimir/modular_stl/nodo_anaquel_tapa.stl
173.9 x 80.0 x 13.8
