cyuxSz/Argos-equipo/2_carcasas_3d/imprimir/pruebas_ajuste/prueba_tapa_oled_led_boton.stl

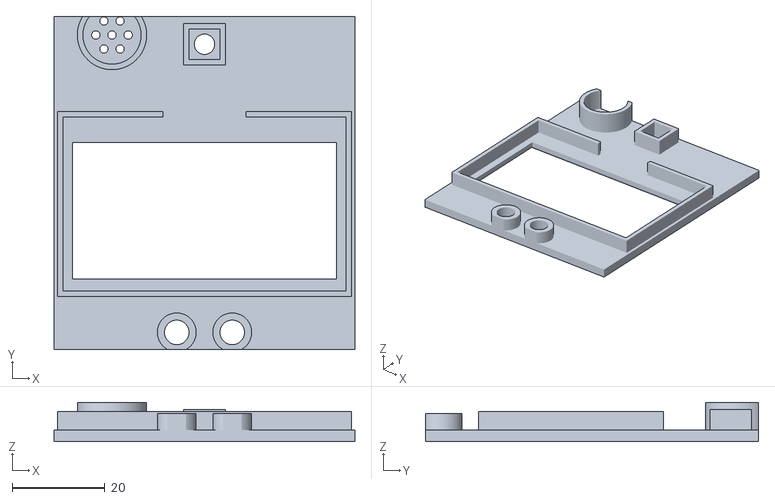
[picture p77: CAD file, 2026-11-09]
2_carcasas_3d/imprimir/pruebas_ajuste/prueba_tapa_oled_led_boton.stl
65.0 x 72.0 x 8.50
