cyuxSz/Argos-equipo/2_carcasas_3d/imprimir/3mf/nodo_anaquel_base.3mf

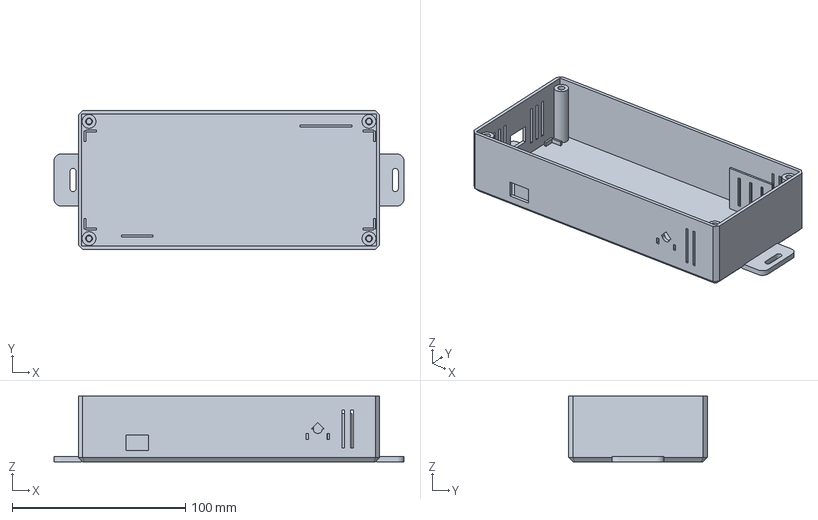
[picture p78: CAD file, 2026-11-09]
2_carcasas_3d/imprimir/3mf/nodo_anaquel_base.3mf
201.9 x 80.0 x 38.0 mm
