cyuxSz/Argos-equipo/2_carcasas_3d/imprimir/pruebas_ajuste/prueba_peine_holguras.stl

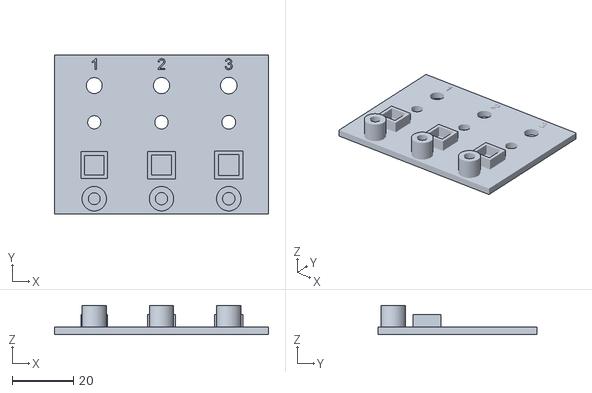
[picture p79: CAD file, 2026-11-09]
2_carcasas_3d/imprimir/pruebas_ajuste/prueba_peine_holguras.stl
70.0 x 52.0 x 9.50
