cyuxSz/Argos-equipo/2_carcasas_3d/visor/modelos/dht_led_v.stl

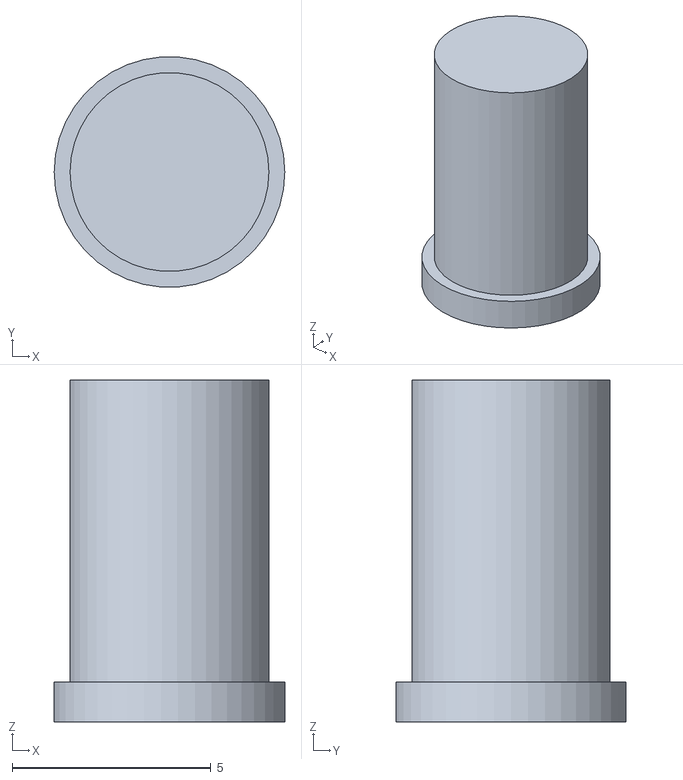
[picture p80: CAD file, 2026-11-09]
2_carcasas_3d/visor/modelos/dht_led_v.stl
5.80 x 5.78 x 8.60
