cyuxSz/Argos-equipo/2_carcasas_3d/imprimir/3mf/nodo_dht_embolo_boton.3mf

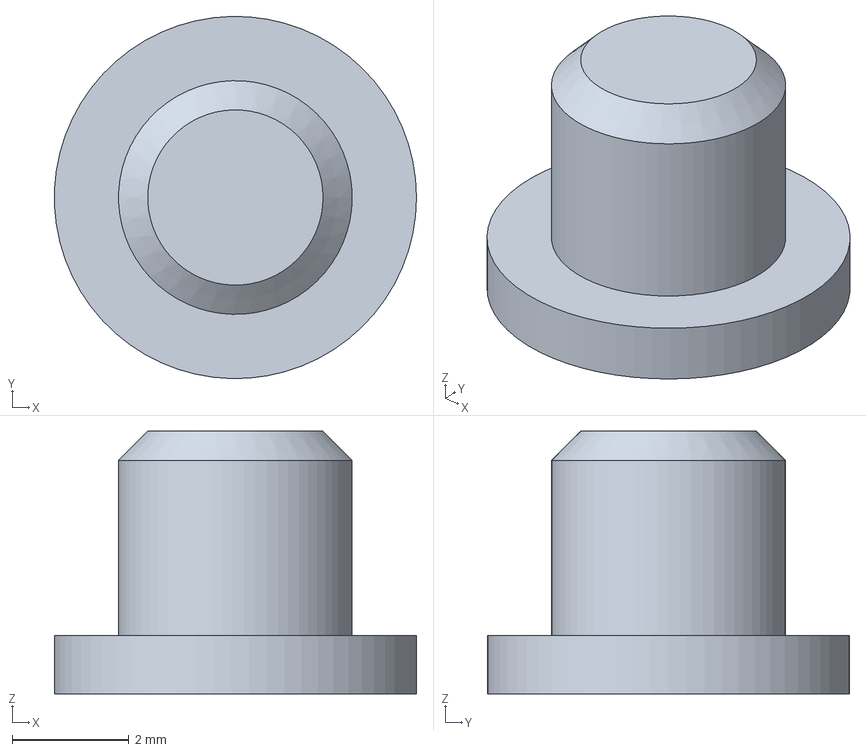
[picture p81: CAD file, 2026-11-09]
2_carcasas_3d/imprimir/3mf/nodo_dht_embolo_boton.3mf
6.20 x 6.20 x 4.50 mm
