cyuxSz/Argos-equipo/2_carcasas_3d/imprimir/modular_stl/nodo_entrada_tapa.stl

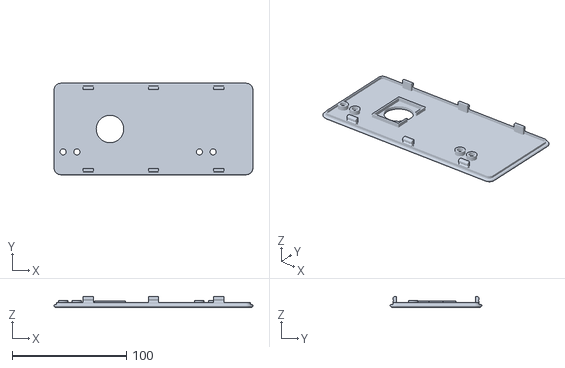
[picture p82: CAD file, 2026-11-10]
2_carcasas_3d/imprimir/modular_stl/nodo_entrada_tapa.stl
173.9 x 80.0 x 9.50
