cyuxSz/Argos-equipo/2_carcasas_3d/imprimir/pruebas_ajuste/prueba_bahia_protoboard.stl

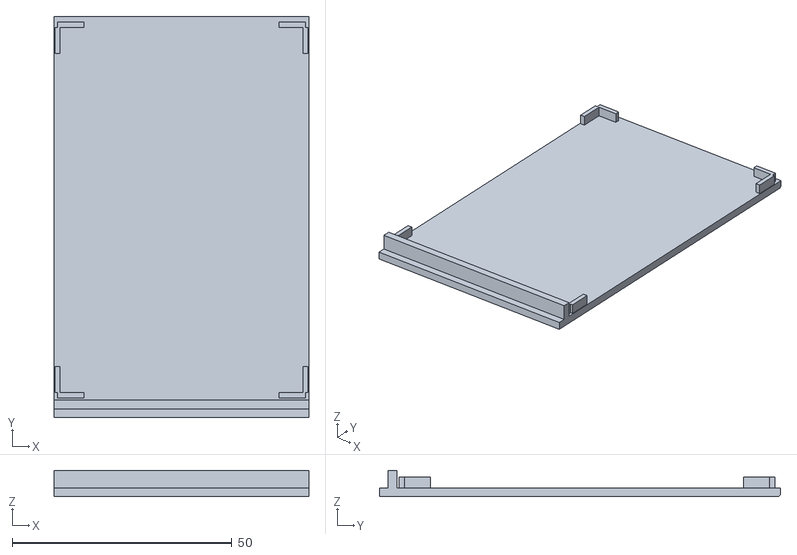
[picture p83: CAD file, 2026-11-09]
2_carcasas_3d/imprimir/pruebas_ajuste/prueba_bahia_protoboard.stl
58.0 x 91.3 x 6.00
