cyuxSz/Argos-equipo/2_carcasas_3d/visor/modelos/acc_mc38_calza.stl

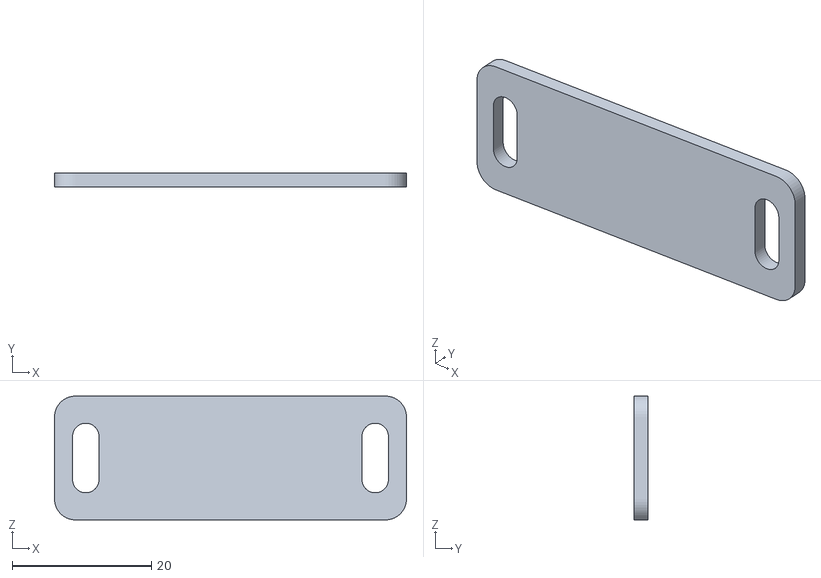
[picture p84: CAD file, 2026-11-09]
2_carcasas_3d/visor/modelos/acc_mc38_calza.stl
50.6 x 2.00 x 17.8
