cyuxSz/Argos-equipo/2_carcasas_3d/imprimir/3mf/nodo_entrada_porta_iman.3mf

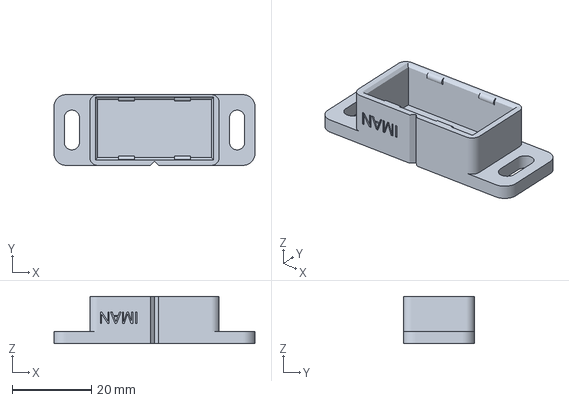
[picture p85: CAD file, 2026-11-09]
2_carcasas_3d/imprimir/3mf/nodo_entrada_porta_iman.3mf
50.6 x 17.8 x 11.8 mm
