cyuxSz/Argos-equipo/2_carcasas_3d/imprimir/modular_stl/nodo_dht_tapa.stl

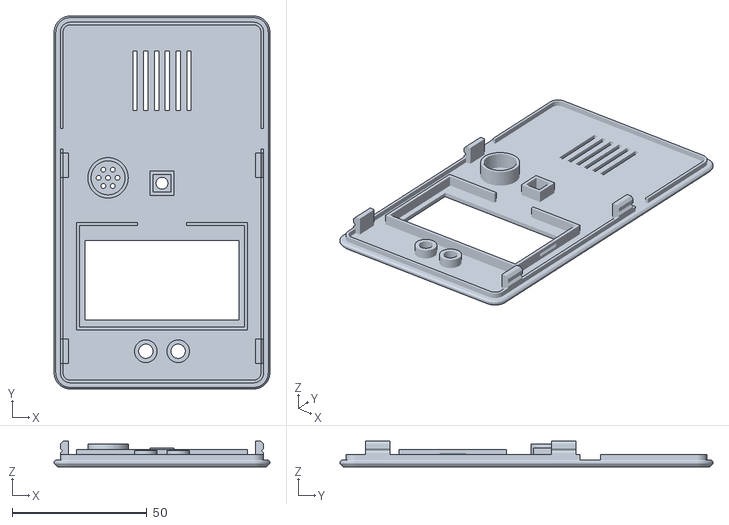
[picture p86: CAD file, 2026-11-10]
2_carcasas_3d/imprimir/modular_stl/nodo_dht_tapa.stl
80.0 x 138.3 x 9.50
