cyuxSz/Argos-equipo/2_carcasas_3d/imprimir/pruebas_ajuste/prueba_camara_dht22.stl

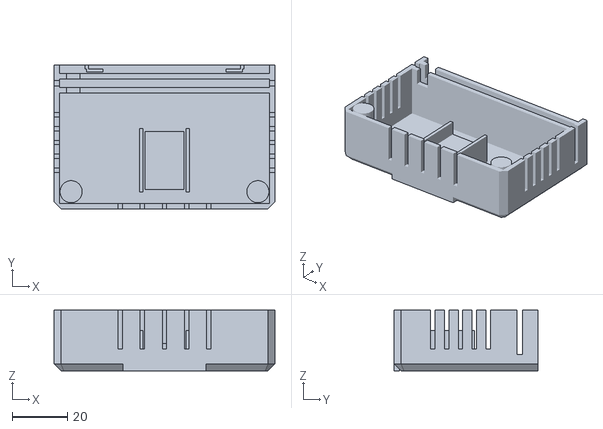
[picture p87: CAD file, 2026-11-09]
2_carcasas_3d/imprimir/pruebas_ajuste/prueba_camara_dht22.stl
80.0 x 52.0 x 22.0
