cyuxSz/Argos-equipo/2_carcasas_3d/visor/modelos/entrada_cables.stl

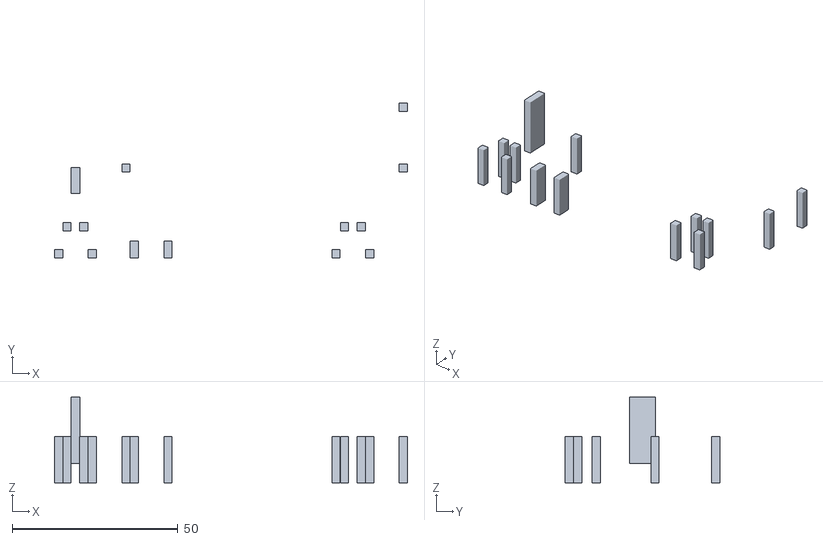
[picture p88: CAD file, 2026-11-09]
2_carcasas_3d/visor/modelos/entrada_cables.stl
106.6 x 46.7 x 25.9
