cyuxSz/Argos-equipo/2_carcasas_3d/imprimir/3mf/nodo_dht_soporte_pared.3mf

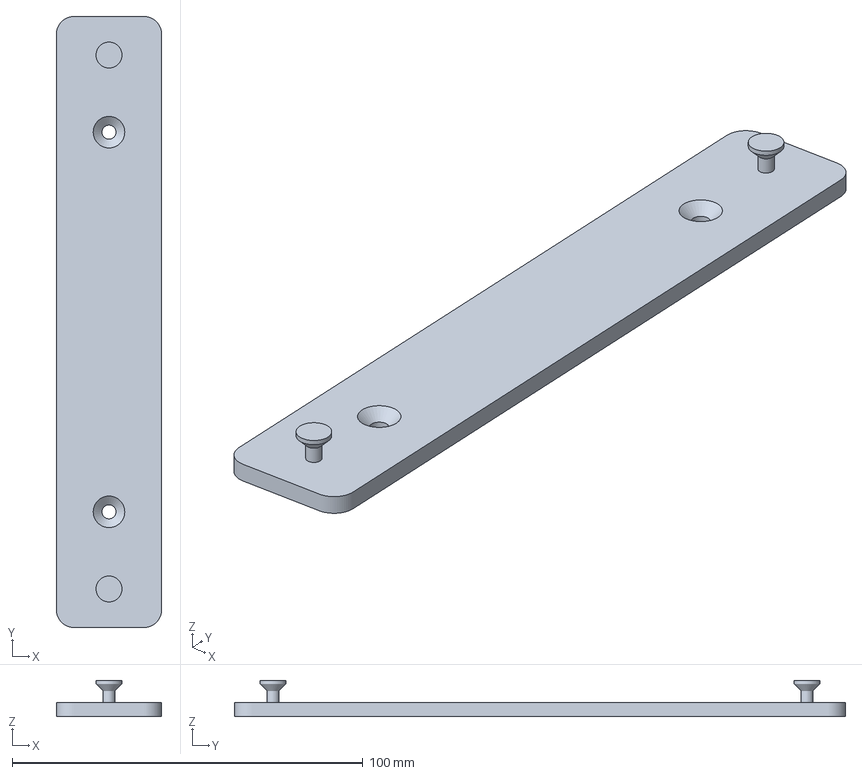
[picture p89: CAD file, 2026-11-09]
2_carcasas_3d/imprimir/3mf/nodo_dht_soporte_pared.3mf
30.0 x 174.3 x 10.4 mm
