cyuxSz/Argos-equipo/2_carcasas_3d/imprimir/modular_stl/nodo_dht_base.stl

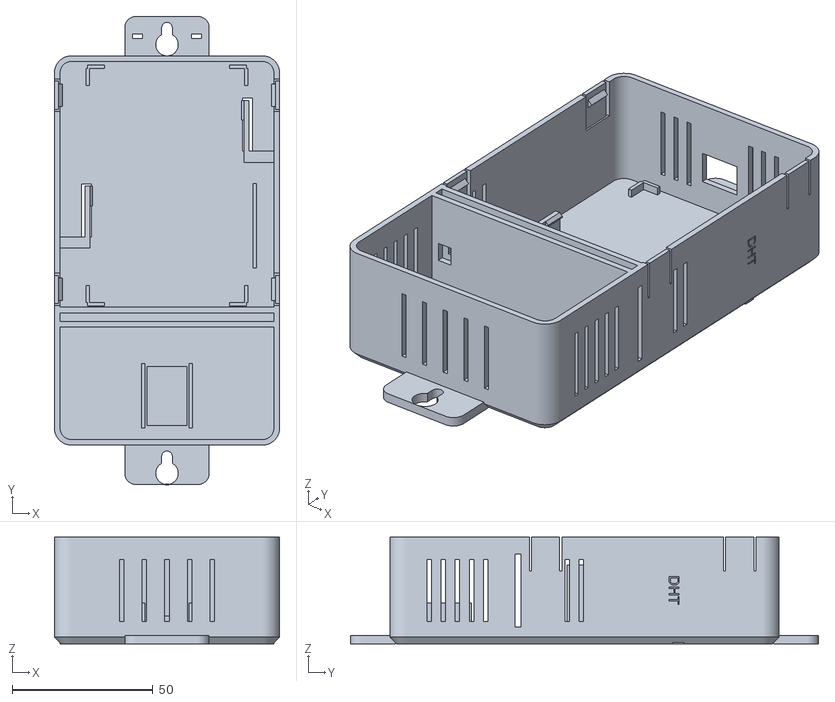
[picture p90: CAD file, 2026-11-10]
2_carcasas_3d/imprimir/modular_stl/nodo_dht_base.stl
80.0 x 166.3 x 38.0
