cyuxSz/Argos-equipo/2_carcasas_3d/visor/modelos/anaquel_modulos.stl

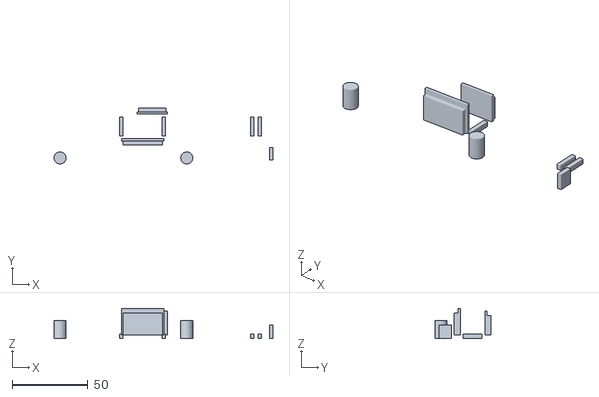
[picture p91: CAD file, 2026-11-09]
2_carcasas_3d/visor/modelos/anaquel_modulos.stl
144.8 x 37.0 x 20.0
