cyuxSz/Argos-equipo/2_carcasas_3d/imprimir/3mf/nodo_dht_tapa.3mf

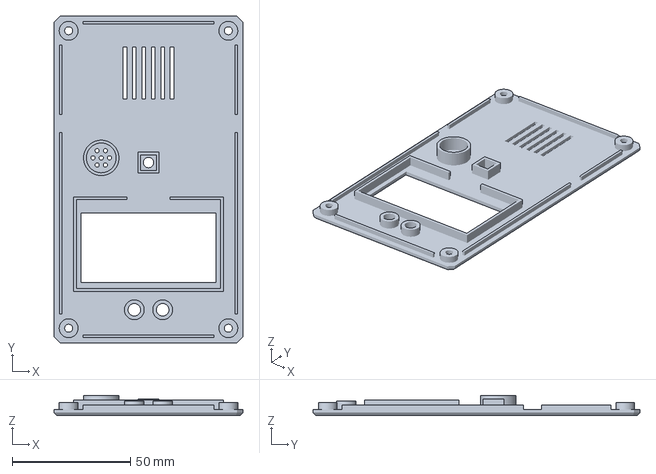
[picture p92: CAD file, 2026-11-09]
2_carcasas_3d/imprimir/3mf/nodo_dht_tapa.3mf
80.0 x 138.3 x 8.50 mm
