cyuxSz/Argos-equipo/2_carcasas_3d/imprimir/modular_stl/nodo_dht_grapa_oled.stl

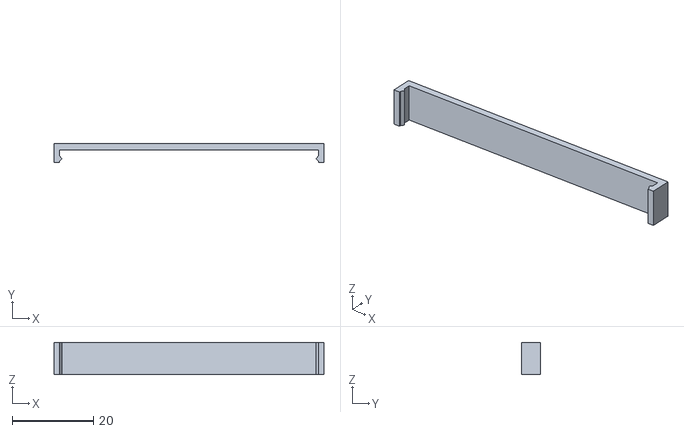
[picture p93: CAD file, 2026-11-10]
2_carcasas_3d/imprimir/modular_stl/nodo_dht_grapa_oled.stl
66.6 x 4.80 x 8.00
