cyuxSz/Argos-equipo/2_carcasas_3d/imprimir/3mf/nodo_entrada_calza_4mm.3mf

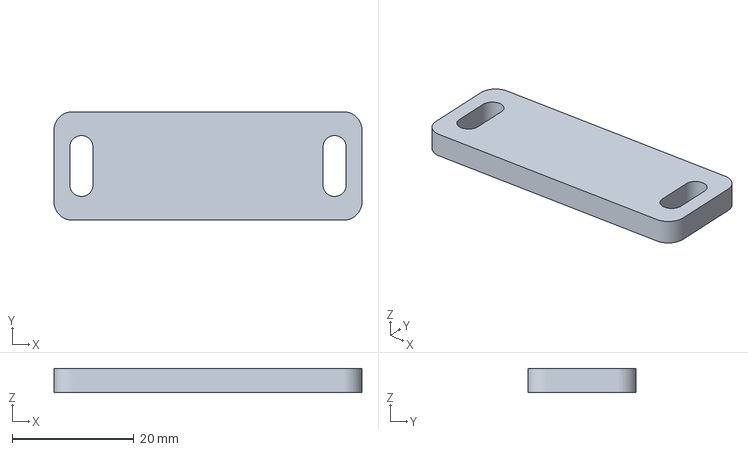
[picture p94: CAD file, 2026-11-09]
2_carcasas_3d/imprimir/3mf/nodo_entrada_calza_4mm.3mf
50.6 x 17.8 x 4.00 mm
