cyuxSz/Argos-equipo/2_carcasas_3d/visor/modelos/dht_protoboard.stl

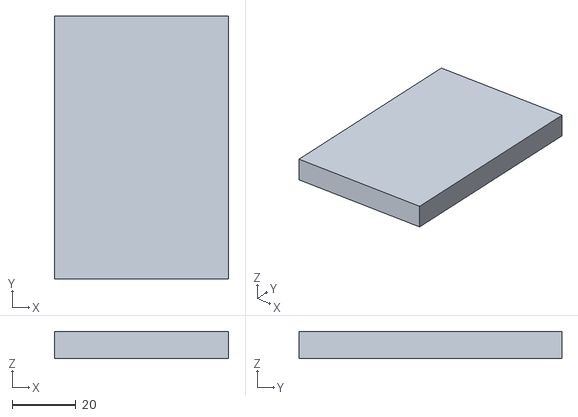
[picture p95: CAD file, 2026-11-09]
2_carcasas_3d/visor/modelos/dht_protoboard.stl
54.6 x 82.5 x 8.50
