cyuxSz/Argos-equipo/2_carcasas_3d/visor/modelos/acc_ldr_soporte.stl

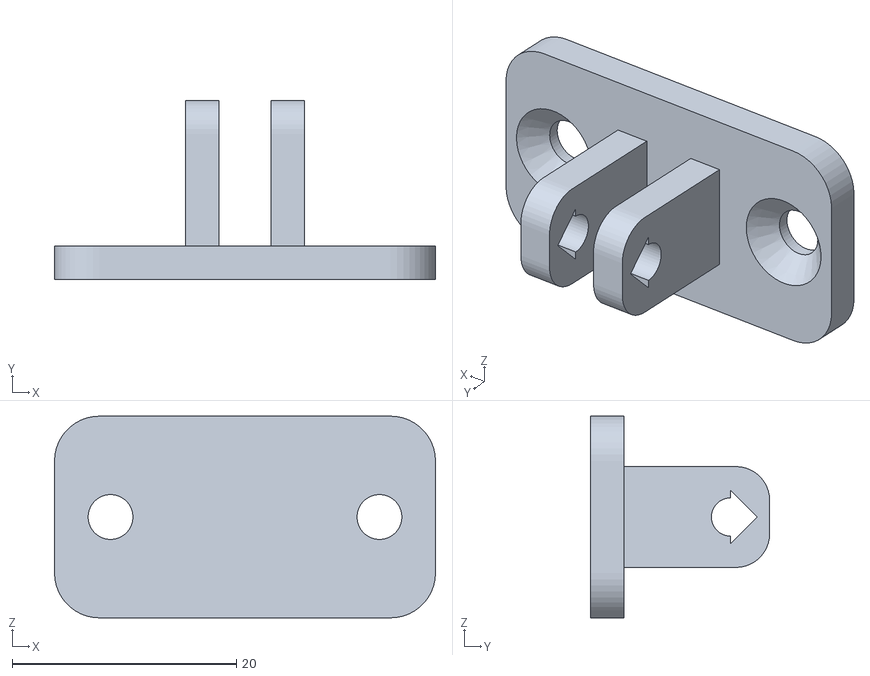
[picture p96: CAD file, 2026-11-09]
2_carcasas_3d/visor/modelos/acc_ldr_soporte.stl
34.0 x 16.0 x 18.0
