cyuxSz/Argos-equipo/2_carcasas_3d/imprimir/3mf/nodo_entrada_tapa.3mf

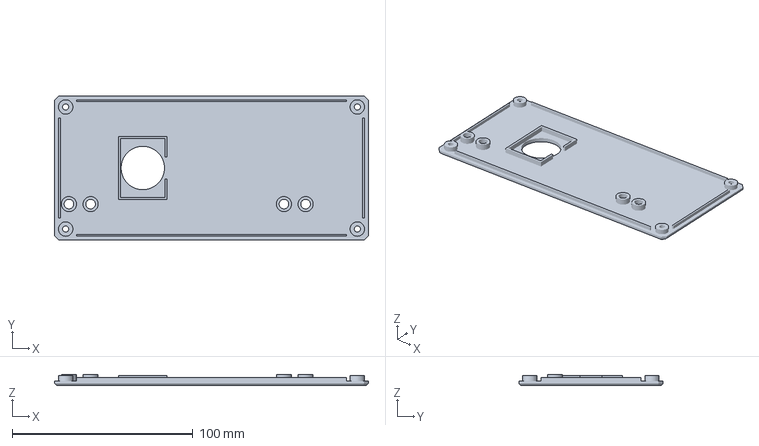
[picture p97: CAD file, 2026-11-09]
2_carcasas_3d/imprimir/3mf/nodo_entrada_tapa.3mf
173.9 x 80.0 x 6.10 mm
