cyuxSz/Argos-equipo/2_carcasas_3d/imprimir/3mf/nodo_anaquel_capuchon_ldr.3mf

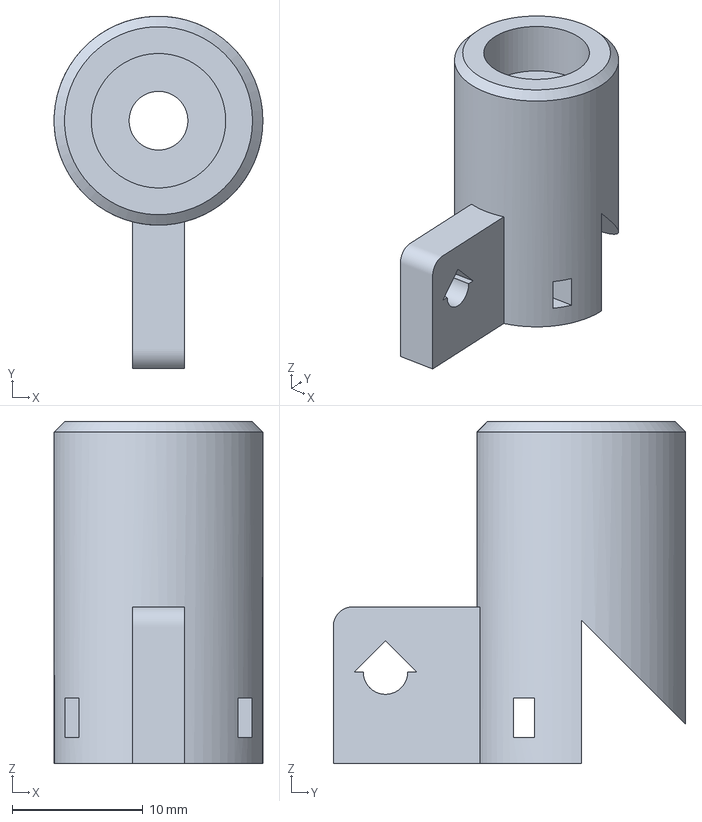
[picture p98: CAD file, 2026-11-09]
2_carcasas_3d/imprimir/3mf/nodo_anaquel_capuchon_ldr.3mf
16.0 x 27.0 x 26.2 mm
