cyuxSz/Argos-equipo/2_carcasas_3d/visor/modelos/entrada_modulos_t.stl

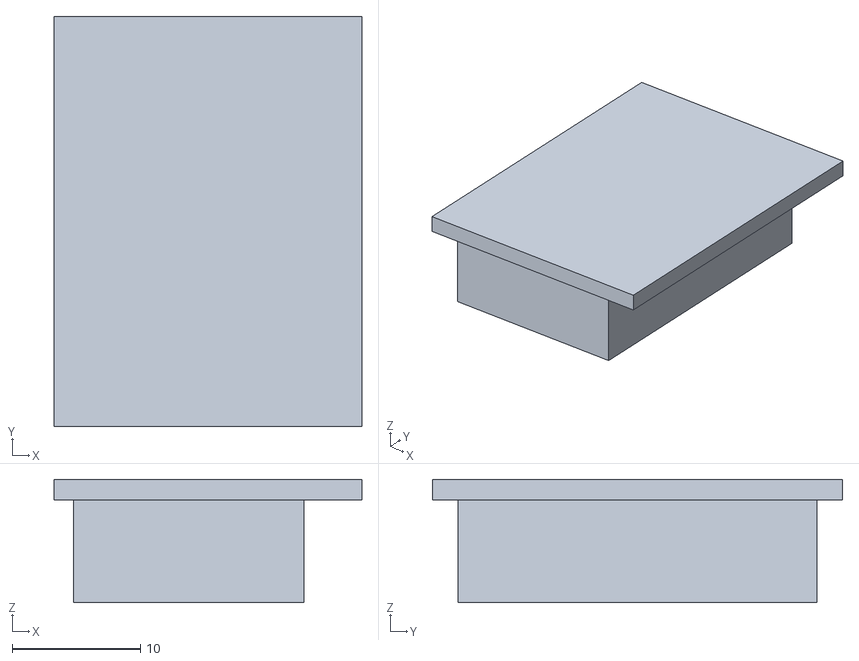
[picture p99: CAD file, 2026-11-09]
2_carcasas_3d/visor/modelos/entrada_modulos_t.stl
24.0 x 32.0 x 9.60
