cyuxSz/Argos-equipo/2_carcasas_3d/visor/modelos/anaquel_protoboard.stl

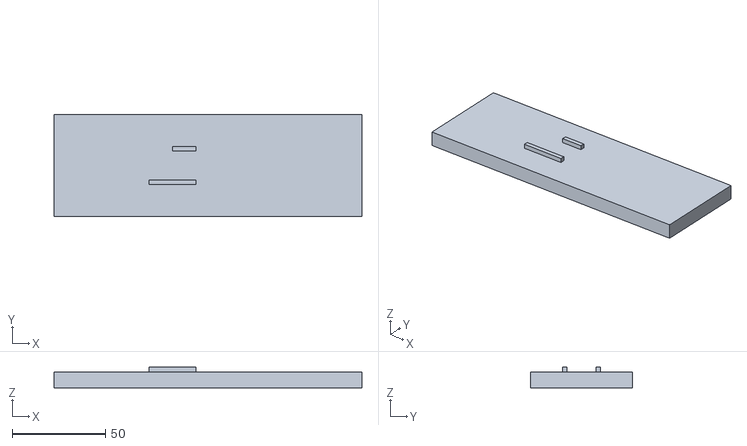
[picture p100: CAD file, 2026-11-09]
2_carcasas_3d/visor/modelos/anaquel_protoboard.stl
165.1 x 54.6 x 11.0
