cyuxSz/Argos-equipo/2_carcasas_3d/visor/modelos/anaquel_placa.stl

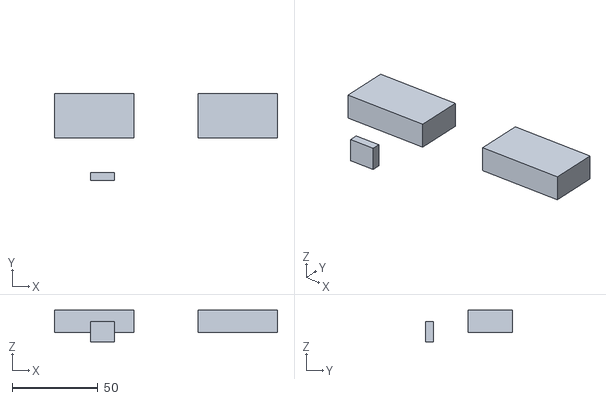
[picture p101: CAD file, 2026-11-09]
2_carcasas_3d/visor/modelos/anaquel_placa.stl
130.3 x 50.7 x 18.5
