cyuxSz/Argos-equipo/2_carcasas_3d/visor/modelos/dht_base.stl

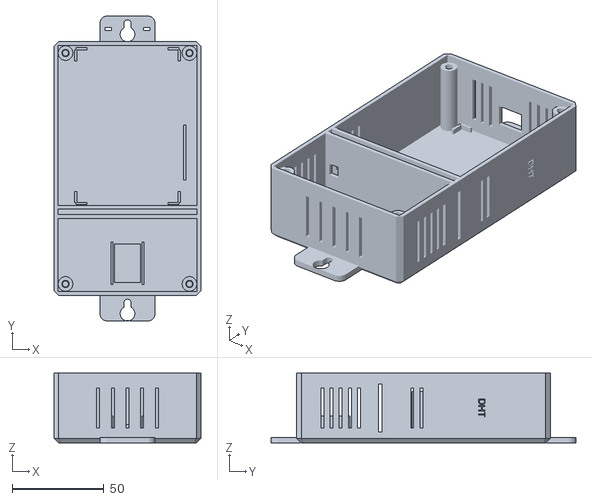
[picture p102: CAD file, 2026-11-09]
2_carcasas_3d/visor/modelos/dht_base.stl
80.0 x 166.3 x 38.0
