cyuxSz/Argos-equipo/2_carcasas_3d/visor/modelos/dht_modulos_t.stl

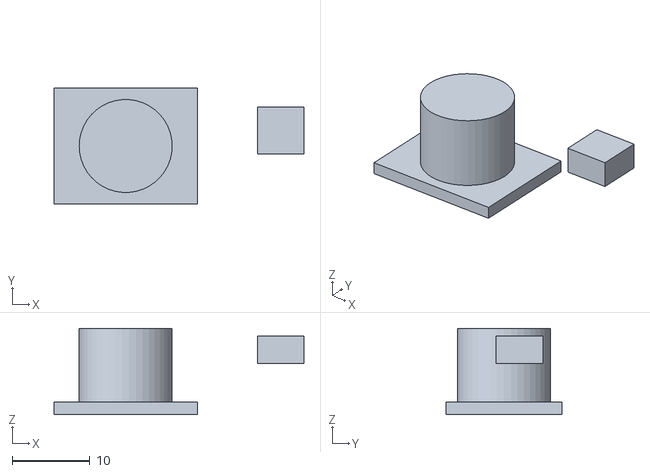
[picture p103: CAD file, 2026-11-09]
2_carcasas_3d/visor/modelos/dht_modulos_t.stl
32.2 x 15.0 x 11.1
