cyuxSz/Argos-equipo/2_carcasas_3d/visor/modelos/acc_ldr_cable.stl

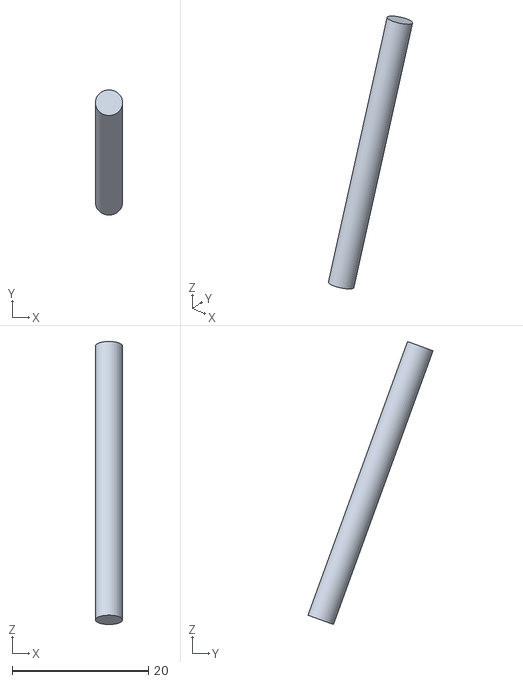
[picture p104: CAD file, 2026-11-09]
2_carcasas_3d/visor/modelos/acc_ldr_cable.stl
4.00 x 18.4 x 41.5
