cyuxSz/Argos-equipo/2_carcasas_3d/visor/modelos/dht_placa.stl

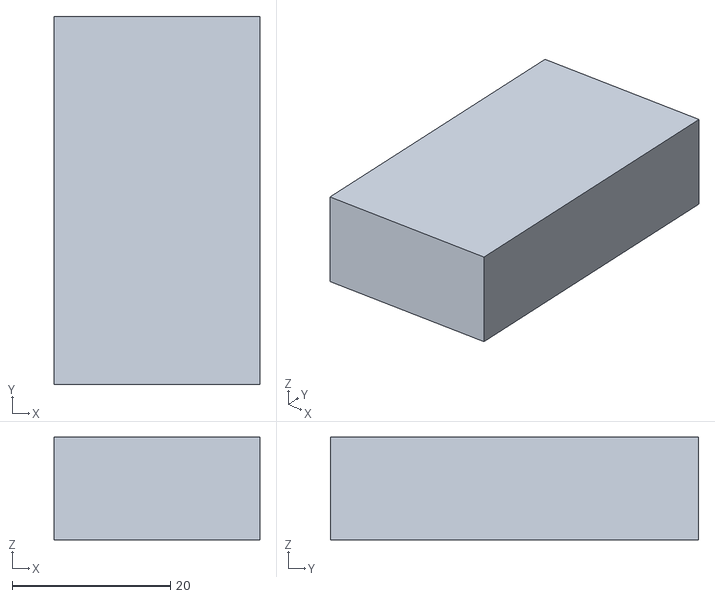
[picture p105: CAD file, 2026-11-09]
2_carcasas_3d/visor/modelos/dht_placa.stl
26.0 x 46.5 x 13.0
