cyuxSz/Argos-equipo/2_carcasas_3d/visor/modelos/dht_modulos.stl

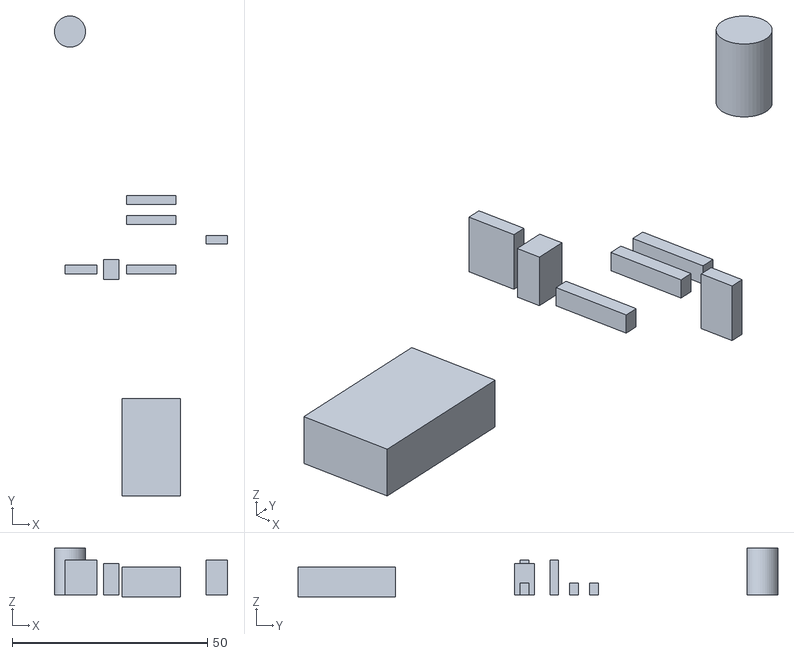
[picture p106: CAD file, 2026-11-09]
2_carcasas_3d/visor/modelos/dht_modulos.stl
44.4 x 123.0 x 12.5
