cyuxSz/Argos-equipo/2_carcasas_3d/visor/modelos/dht_cables.stl

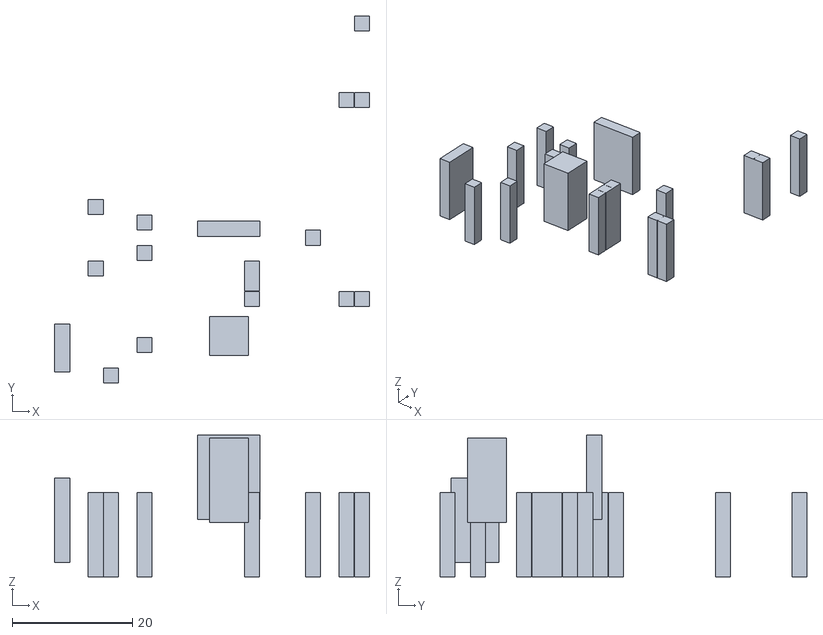
[picture p107: CAD file, 2026-11-09]
2_carcasas_3d/visor/modelos/dht_cables.stl
52.3 x 60.9 x 23.5
