cyuxSz/Argos-equipo/2_carcasas_3d/visor/modelos/entrada_domo.stl

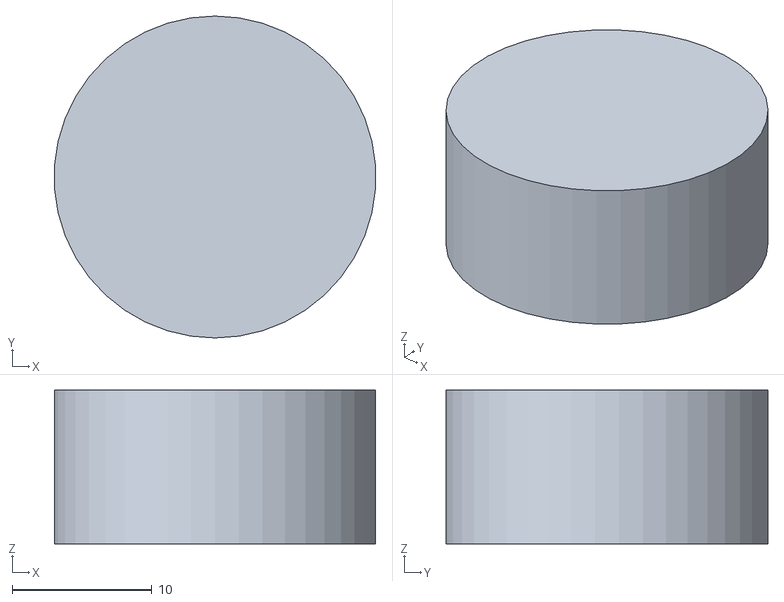
[picture p108: CAD file, 2026-11-09]
2_carcasas_3d/visor/modelos/entrada_domo.stl
22.9 x 23.0 x 11.0
