cyuxSz/Argos-equipo/2_carcasas_3d/visor/modelos/acc_ldr_ldr.stl

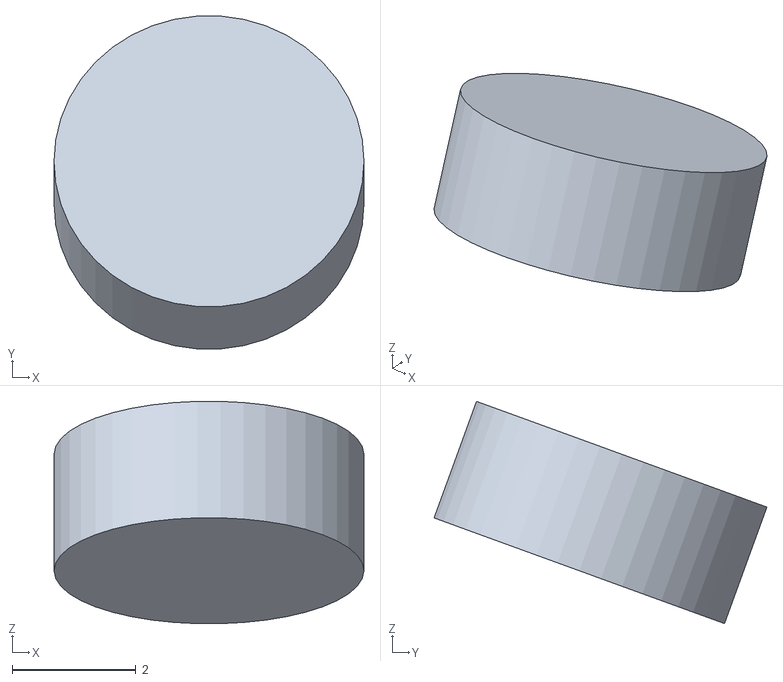
[picture p109: CAD file, 2026-11-09]
2_carcasas_3d/visor/modelos/acc_ldr_ldr.stl
5.00 x 5.37 x 3.58
