cyuxSz/Argos-equipo/2_carcasas_3d/visor/modelos/acc_mc38_cuerpo_iman.stl

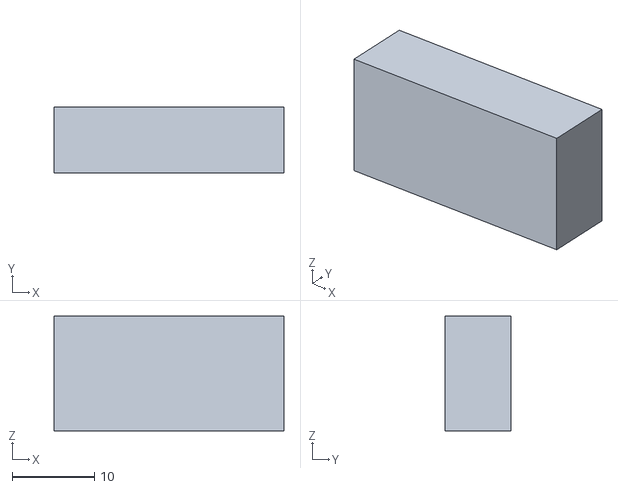
[picture p110: CAD file, 2026-11-09]
2_carcasas_3d/visor/modelos/acc_mc38_cuerpo_iman.stl
28.0 x 8.00 x 14.0
