cyuxSz/Argos-equipo/2_carcasas_3d/visor/modelos/acc_ldr_difusor.stl

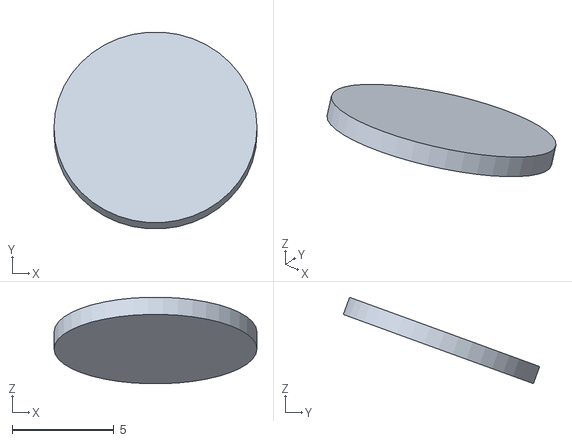
[picture p111: CAD file, 2026-11-09]
2_carcasas_3d/visor/modelos/acc_ldr_difusor.stl
10.0 x 9.68 x 4.26
