cyuxSz/Argos-equipo/2_carcasas_3d/visor/modelos/entrada_protoboard.stl

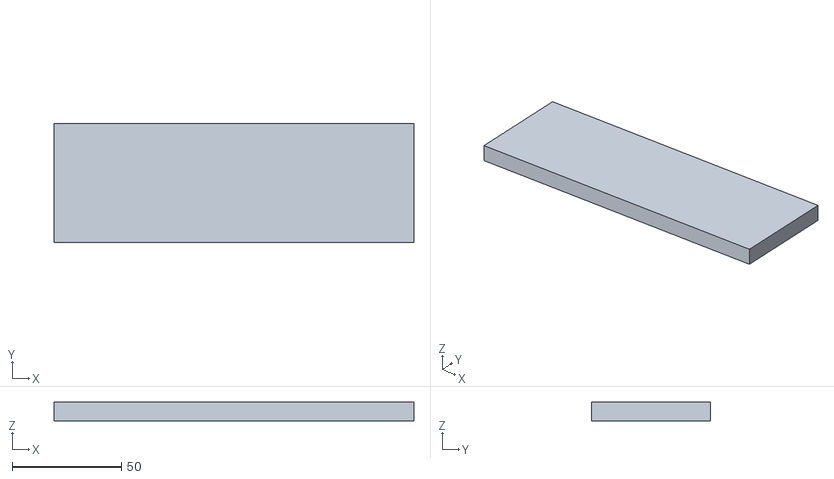
[picture p112: CAD file, 2026-11-09]
2_carcasas_3d/visor/modelos/entrada_protoboard.stl
165.1 x 54.6 x 8.50
