cyuxSz/Argos-equipo/2_carcasas_3d/visor/modelos/anaquel_cables.stl

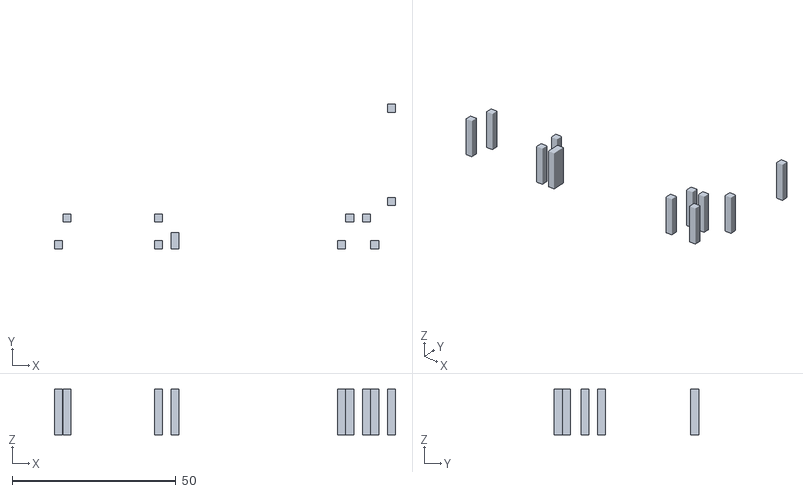
[picture p113: CAD file, 2026-11-09]
2_carcasas_3d/visor/modelos/anaquel_cables.stl
104.1 x 44.2 x 14.0
