cyuxSz/Argos-equipo/2_carcasas_3d/visor/modelos/acc_ldr_capuchon.stl

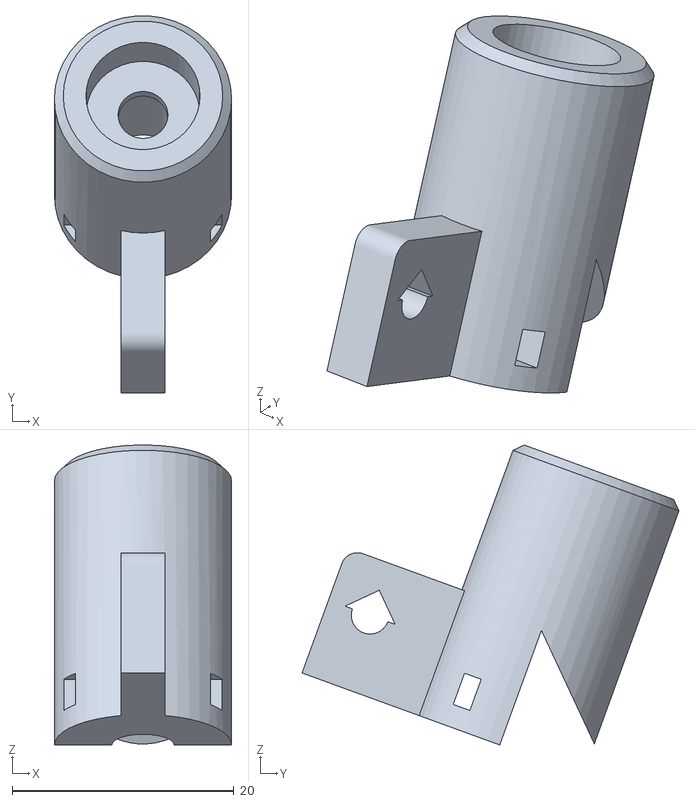
[picture p114: CAD file, 2026-11-09]
2_carcasas_3d/visor/modelos/acc_ldr_capuchon.stl
16.0 x 34.0 x 27.1
