cyuxSz/Argos-equipo/2_carcasas_3d/visor/modelos/dht_pantalla.stl

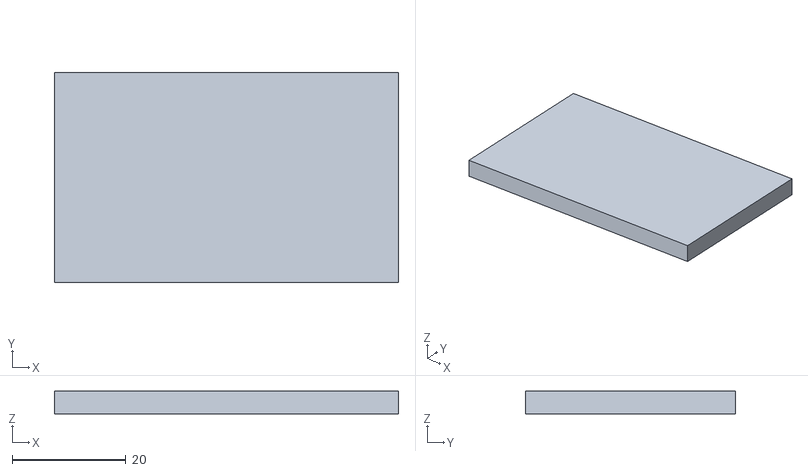
[picture p115: CAD file, 2026-11-09]
2_carcasas_3d/visor/modelos/dht_pantalla.stl
60.5 x 37.0 x 4.00
