cyuxSz/Argos-equipo/(list of files, cad)

Other CAD files:
2_carcasas_3d/imprimir/modular_stl/nodo_entrada_base.stl
2_carcasas_3d/visor/modelos/anaquel_led_v.stl
2_carcasas_3d/visor/modelos/acc_mc38_porta_sensor.stl
2_carcasas_3d/imprimir/3mf/nodo_entrada_calza_2mm.3mf
2_carcasas_3d/imprimir/modular_stl/nodo_anaquel_rele_base.stl
2_carcasas_3d/imprimir/modular_stl/nodo_entrada_porta_iman.stl
2_carcasas_3d/imprimir/3mf/nodo_entrada_base.3mf
2_carcasas_3d/imprimir/modular_stl/nodo_anaquel_difusor_ldr.stl
2_carcasas_3d/imprimir/modular_stl/nodo_entrada_calza_2mm.stl
2_carcasas_3d/visor/modelos/dht_tapa.stl
2_carcasas_3d/imprimir/modular_stl/nodo_anaquel_soporte_ldr.stl
2_carcasas_3d/imprimir/3mf/nodo_entrada_porta_sensor.3mf
2_carcasas_3d/imprimir/modular_stl/nodo_dht_soporte_anaquel.stl
2_carcasas_3d/imprimir/3mf/nodo_anaquel_soporte_ldr.3mf
2_carcasas_3d/imprimir/modular_stl/nodo_anaquel_capuchon_ldr.stl
2_carcasas_3d/imprimir/3mf/nodo_anaquel_tapa.3mf
2_carcasas_3d/imprimir/modular_stl/nodo_dht_soporte_pared.stl
2_carcasas_3d/imprimir/modular_stl/nodo_entrada_porta_sensor.stl
2_carcasas_3d/imprimir/modular_stl/nodo_entrada_soporte_pared.stl
2_carcasas_3d/visor/modelos/dht_led_r.stl
2_carcasas_3d/imprimir/modular_stl/nodo_dht_embolo_boton.stl
2_carcasas_3d/visor/modelos/entrada_base.stl
2_carcasas_3d/imprimir/modular_stl/nodo_entrada_calza_4mm.stl
2_carcasas_3d/visor/modelos/entrada_tapa.stl
2_carcasas_3d/visor/modelos/entrada_led_v.stl
2_carcasas_3d/visor/modelos/acc_mc38_cuerpo_sensor.stl
2_carcasas_3d/visor/modelos/anaquel_tapa.stl
2_carcasas_3d/visor/modelos/anaquel_base.stl
2_carcasas_3d/visor/modelos/acc_mc38_porta_iman.stl
