cyuxSz/Argos-equipo/2_carcasas_3d/renders/prueba_peine_holguras.png

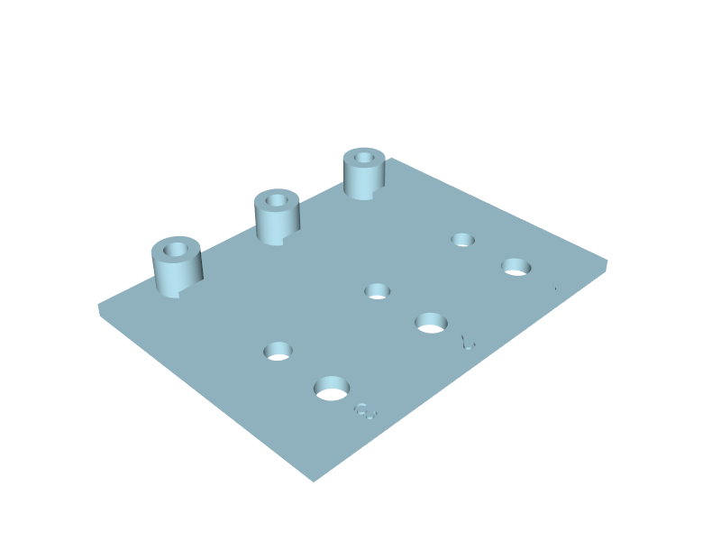
2_carcasas_3d/renders/prueba_peine_holguras.png
