cyuxSz/Argos-equipo/1_electronica/kicad/pdf_svg/arbol_alimentacion.pdf

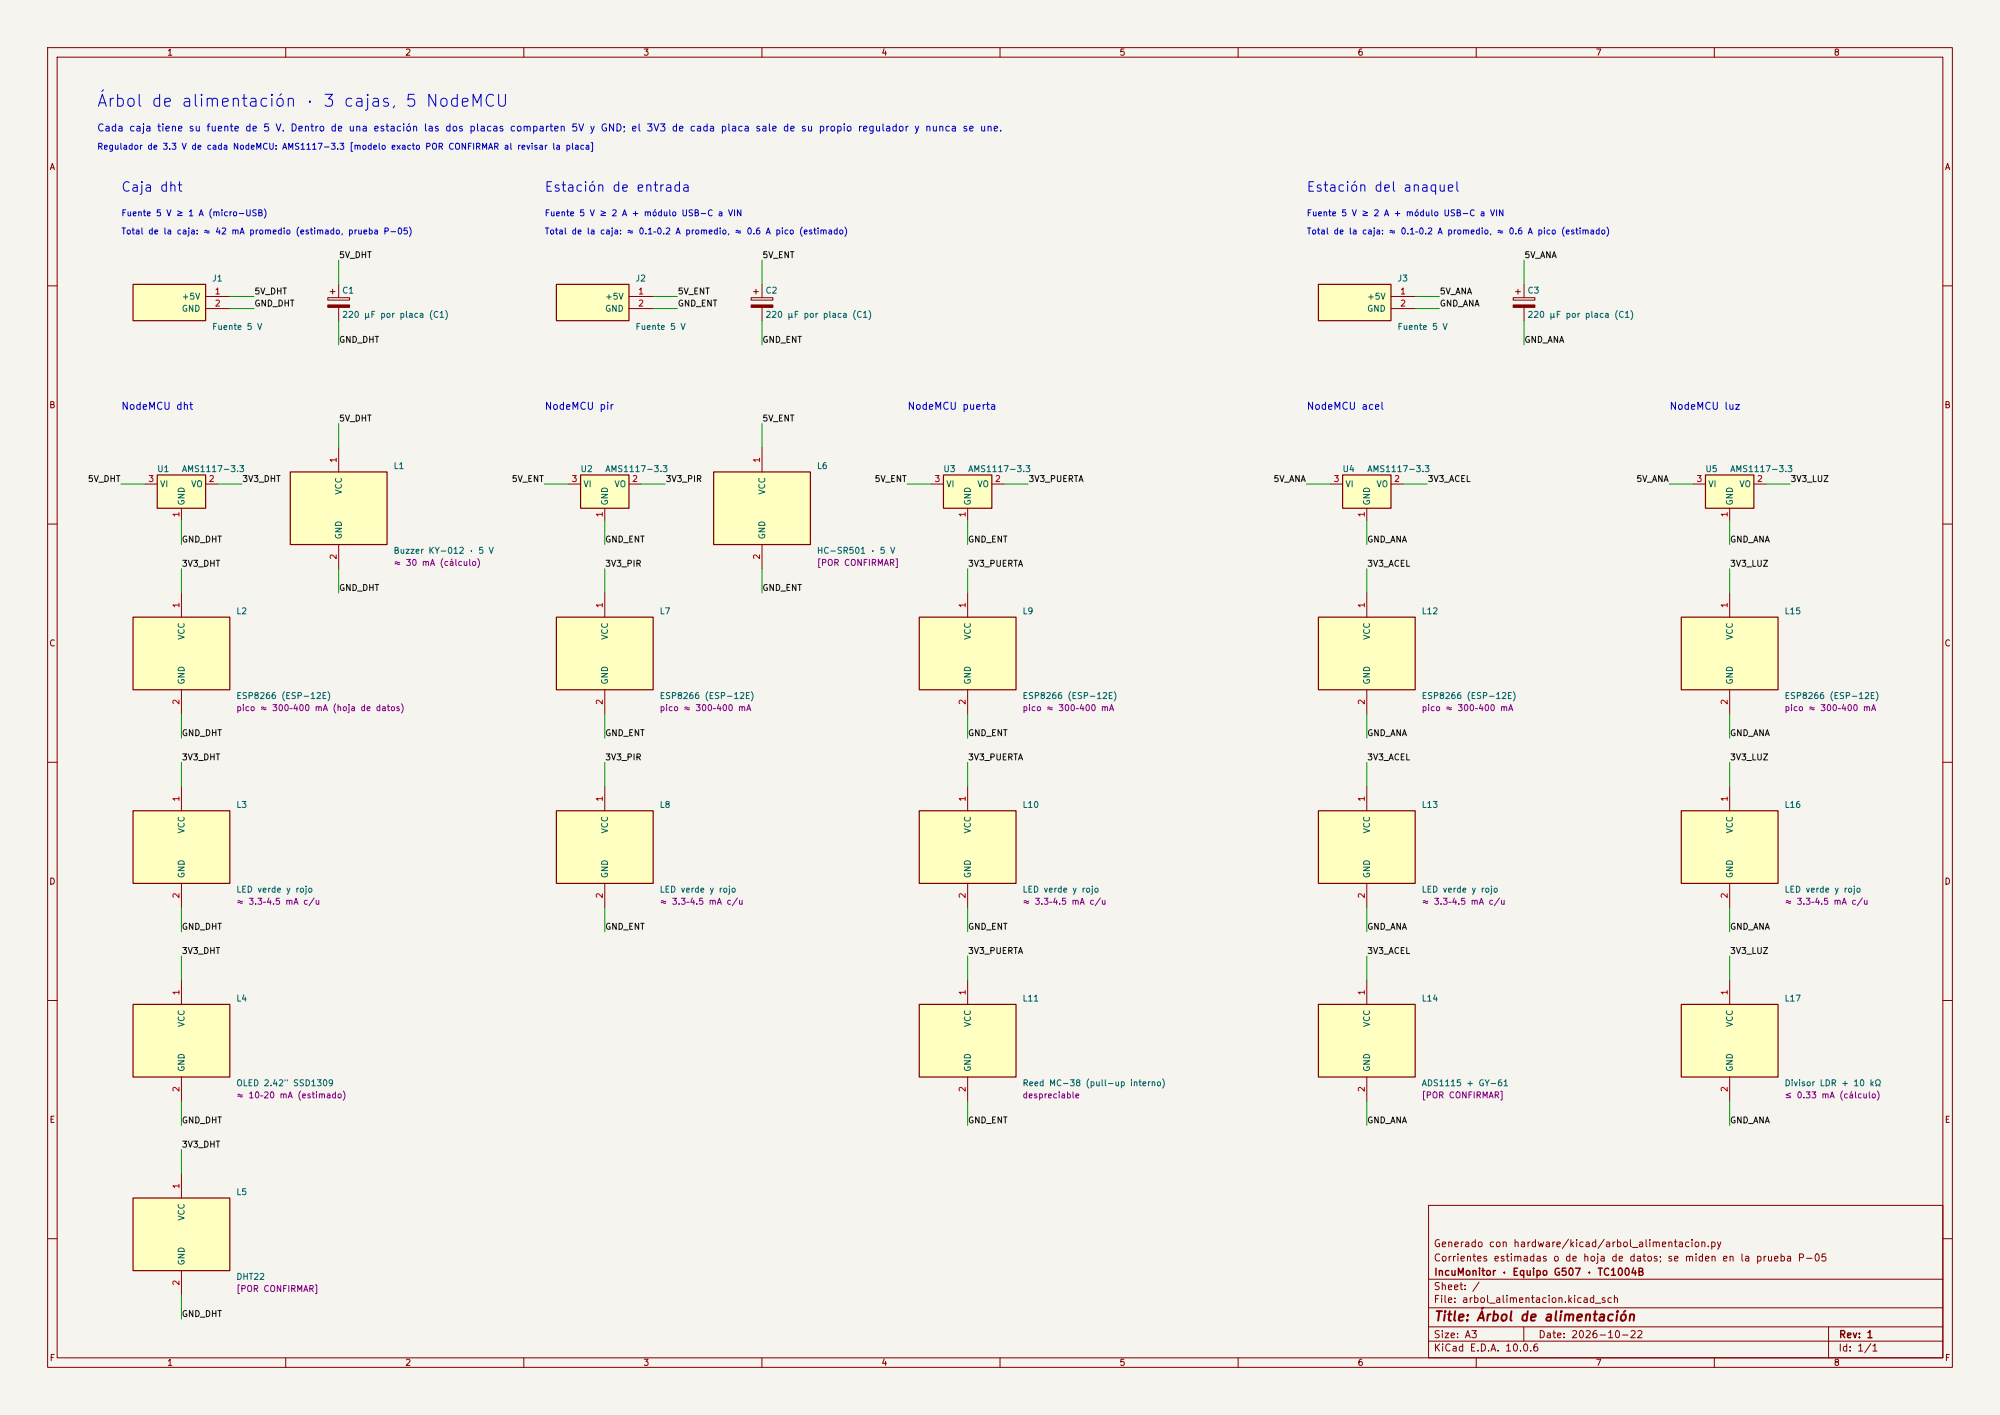
[picture p117: page 1]

Árbol de alimentación · 3 cajas, 5 NodeMCU

Regulador de 3.3 V de cada NodeMCU: AMS1117-3.3 [modelo exacto POR CONFIRMAR al revisar la placa] Fuente 5 V ≥ 2 A + módulo USB-C a VIN Cada caja tiene su fuente de 5 V. Dentro de una estación las dos placas comparten 5V y GND; el 3V3 de cada placa sale de su propio regulador y nunca se une. NodeMCU puerta

Estación del anaquel Fuente 5 V ≥ 2 A + módulo USB-C a VIN

Total de la caja: ≈ 0.1–0.2 A promedio, ≈ 0.6 A pico (estimado) Fuente 5 V ≥ 1 A (micro-USB)

NodeMCU dht Total de la caja: ≈ 42 mA promedio (estimado, prueba P-05)

Total de la caja: ≈ 0.1–0.2 A promedio, ≈ 0.6 A pico (estimado)

LED verde y rojo ≈ 3.3–4.5 mA c/u VCC

pico ≈ 300–400 mA (hoja de datos) VCC

L17 Divisor LDR + 10 kΩ ≤ 0.33 mA (cálculo) VCC

LED verde y rojo ≈ 3.3–4.5 mA c/u

1 GND
Generado con hardware/kicad/arbol_alimentacion.py VCC

L11 Reed MC-38 (pull-up interno)

Corrientes estimadas o de hoja de datos; se miden en la prueba P-05
IncuMonitor · Equipo G507 · TC1004B
Sheet: /
File: arbol_alimentacion.kicad_sch
Title: Árbol de alimentación

Size: A3 | Rev: 1 | F Date: 2026-10-22
KiCad E.D.A. 10.0.6 | Id: 1/1
