cyuxSz/Argos-equipo/1_electronica/kicad/pdf_svg/caja_potencia.pdf

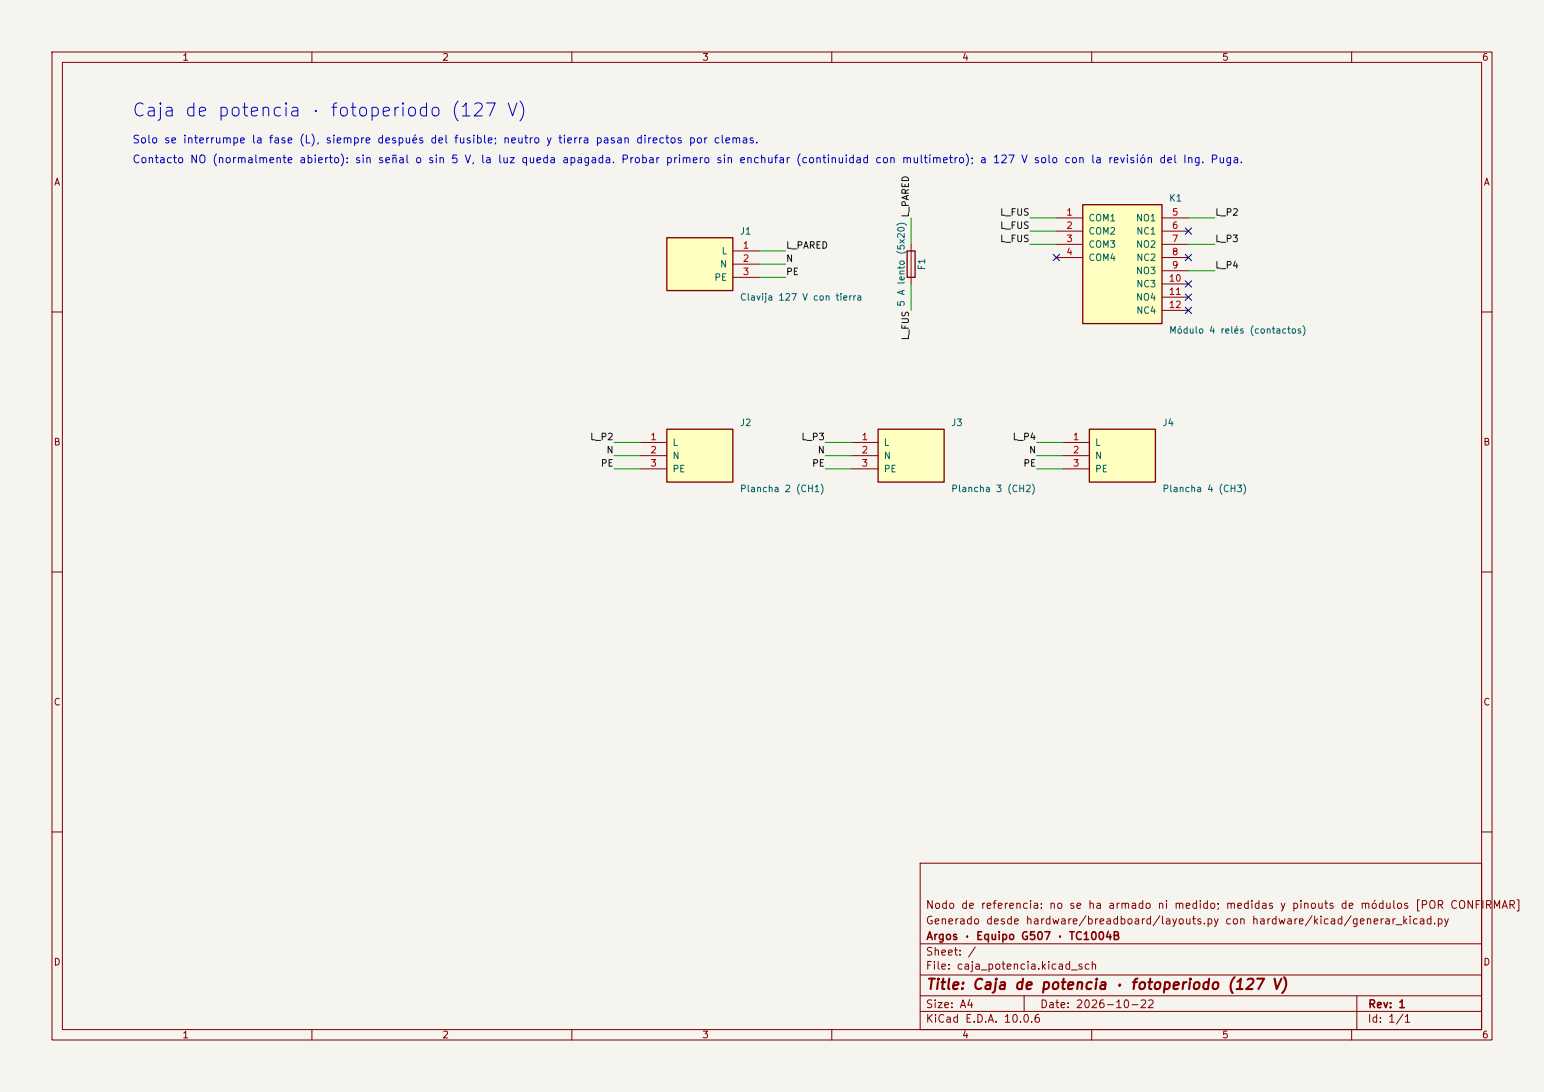
[picture p118: page 1]

Caja de potencia · fotoperiodo (127 V)

Solo se interrumpe la fase (L), siempre después del fusible; neutro y tierra pasan directos por clemas.
Contacto NO (normalmente abierto): sin señal o sin 5 V, la luz queda apagada. Probar primero sin enchufar (continuidad con multímetro); a 127 V solo con la revisión del Ing. Puga.

Generado desde hardware/breadboard/layouts.py con hardware/kicad/generar_kicad.py
Argos · Equipo G507 · TC1004B
Sheet: /
File: caja_potencia.kicad_sch
Title: Caja de potencia · fotoperiodo (127 V)

Size: A4 | Rev: 1
KiCad E.D.A. 10.0.6 | Id: 1/1
