cyuxSz/Argos-equipo/1_electronica/kicad/pdf_svg/nodo_acel.pdf

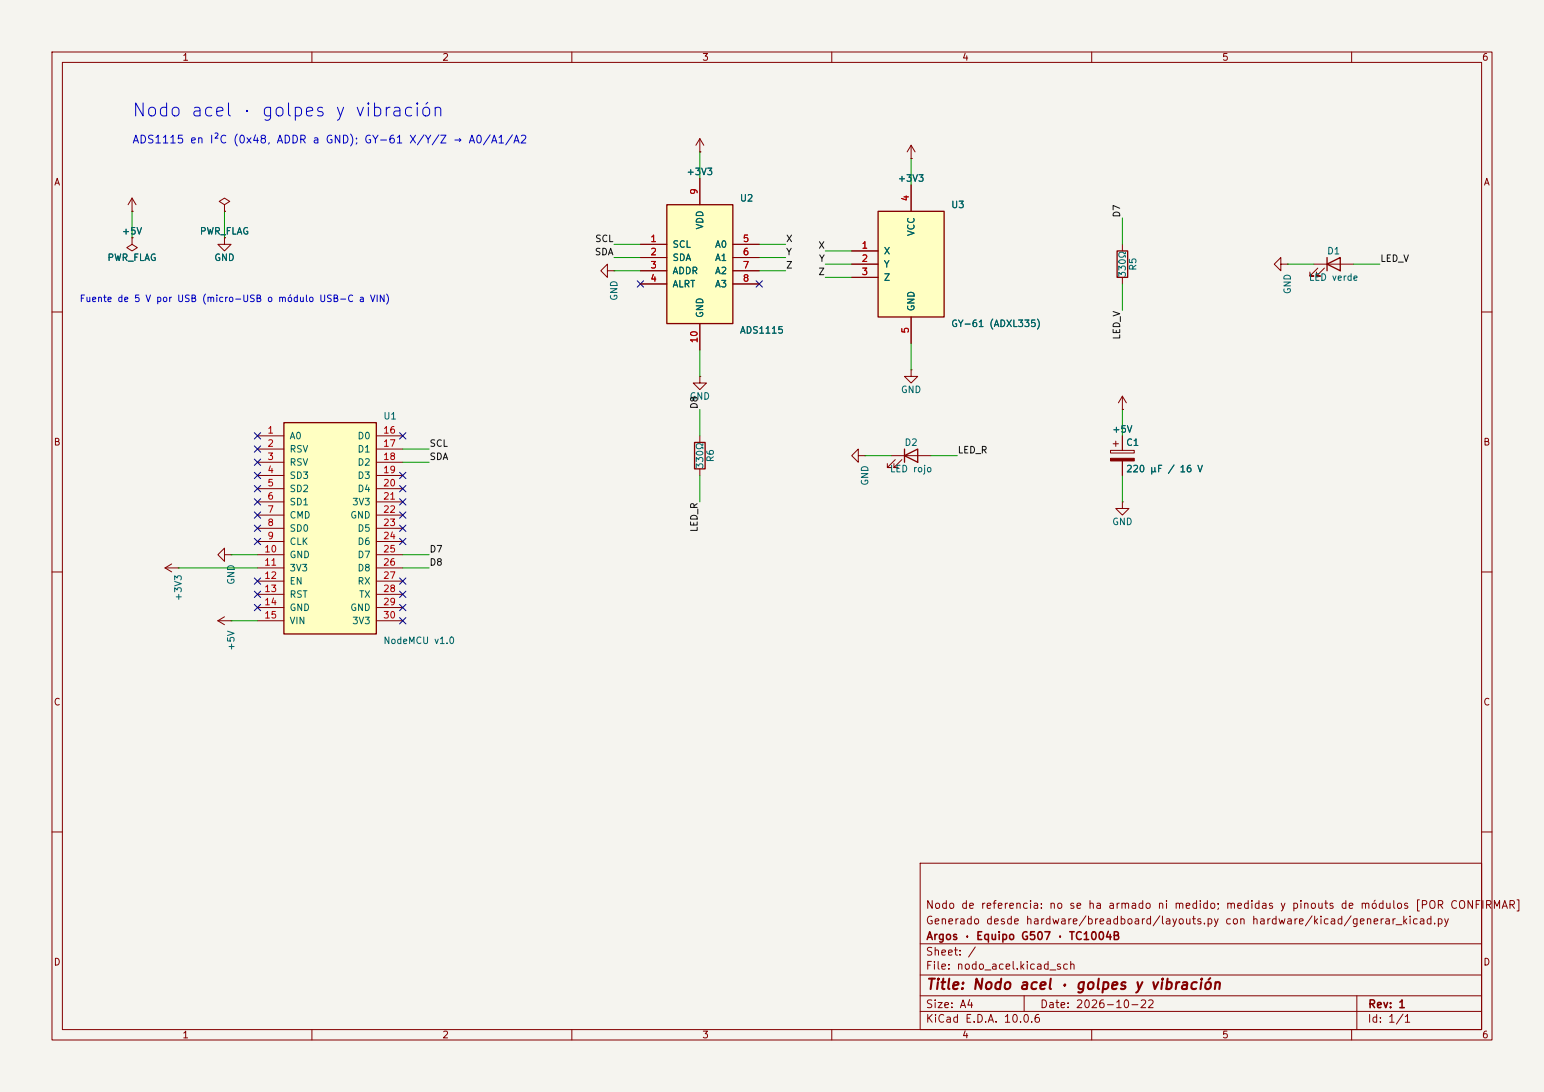
[picture p119: page 1]

Y SCL SCL Nodo acel · golpes y vibración

ADS1115 en I²C (0x48, ADDR a GND); GY-61 X/Y/Z → A0/A1/A2

Nodo de referencia: no se ha armado ni medido; medidas y pinouts de módulos [POR CONFIRMAR] +5V

Generado desde hardware/breadboard/layouts.py con hardware/kicad/generar_kicad.py
Argos · Equipo G507 · TC1004B
Sheet: /
File: nodo_acel.kicad_sch
Title: Nodo acel · golpes y vibración

Size: A4 | Rev: 1
KiCad E.D.A. 10.0.6 | Id: 1/1
