cyuxSz/Argos-equipo/1_electronica/kicad/pdf_svg/nodo_dht.pdf

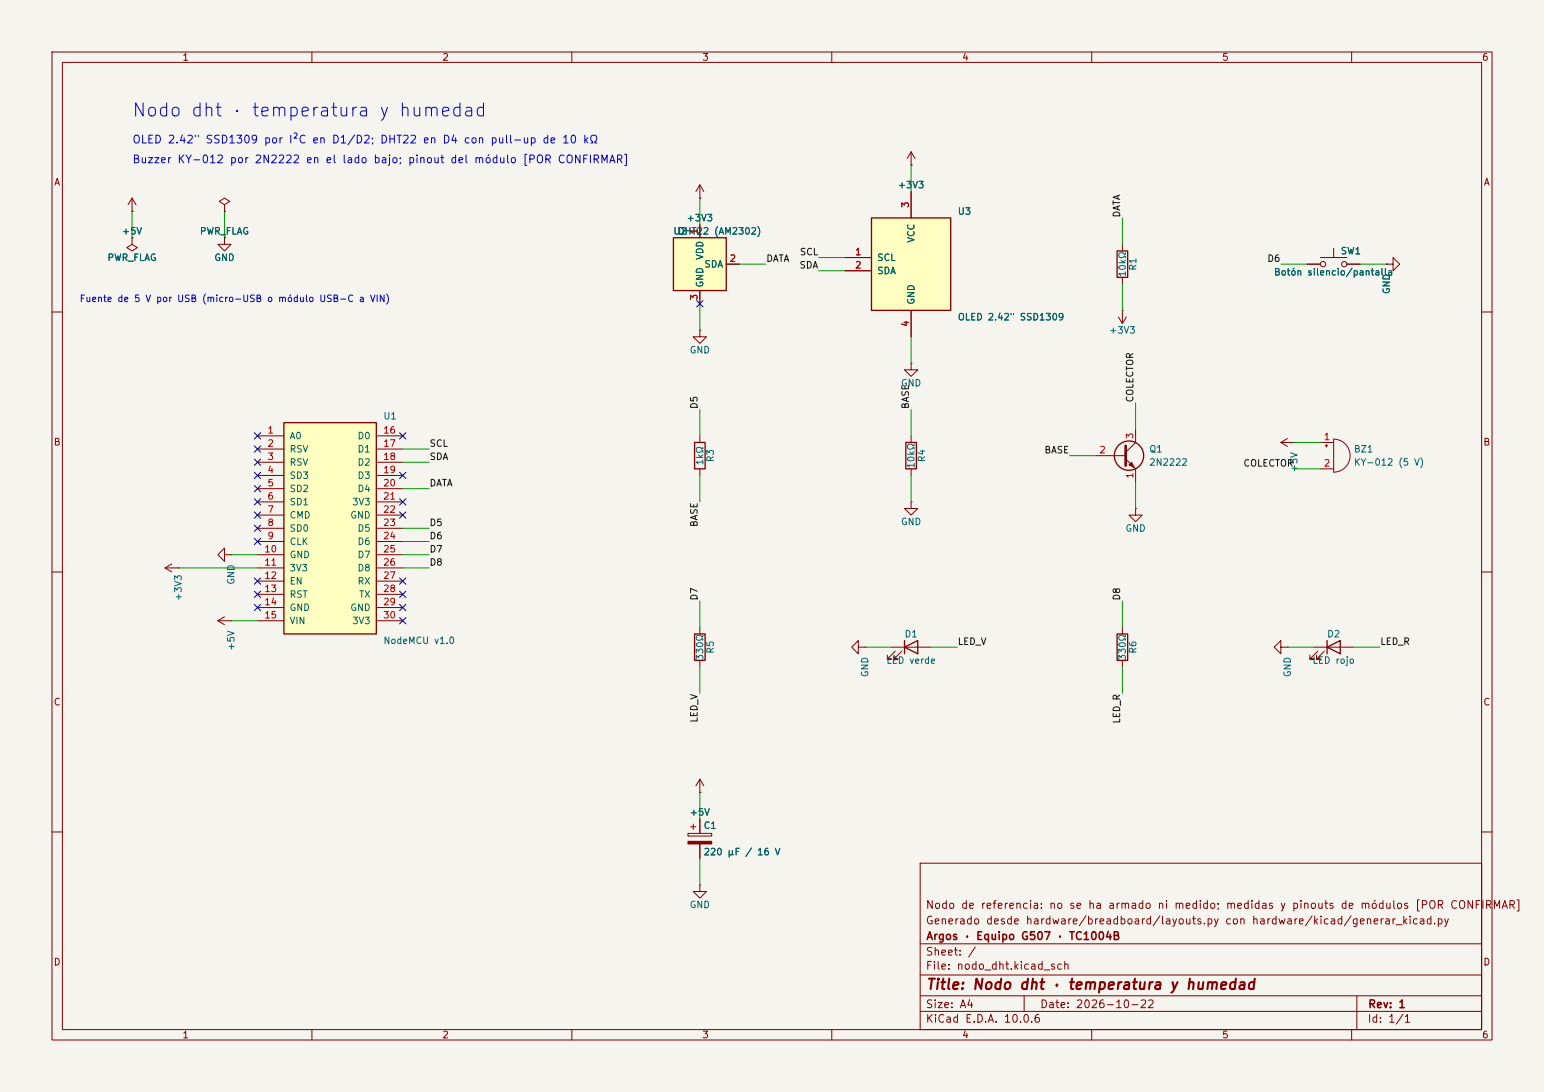
[picture p120: page 1]

Nodo dht · temperatura y humedad

OLED 2.42" SSD1309 por I²C en D1/D2; DHT22 en D4 con pull-up de 10 kΩ
SDA SCL DATA D5D6 Buzzer KY-012 por 2N2222 en el lado bajo; pinout del módulo [POR CONFIRMAR]

Nodo de referencia: no se ha armado ni medido; medidas y pinouts de módulos [POR CONFIRMAR] GND

Fuente de 5 V por USB (micro-USB o módulo USB-C a VIN)

Generado desde hardware/breadboard/layouts.py con hardware/kicad/generar_kicad.py
Argos · Equipo G507 · TC1004B
Sheet: /
File: nodo_dht.kicad_sch
Title: Nodo dht · temperatura y humedad

Size: A4 | Rev: 1
KiCad E.D.A. 10.0.6 | Id: 1/1
