cyuxSz/Argos-equipo/1_electronica/kicad/pdf_svg/nodo_luz.pdf

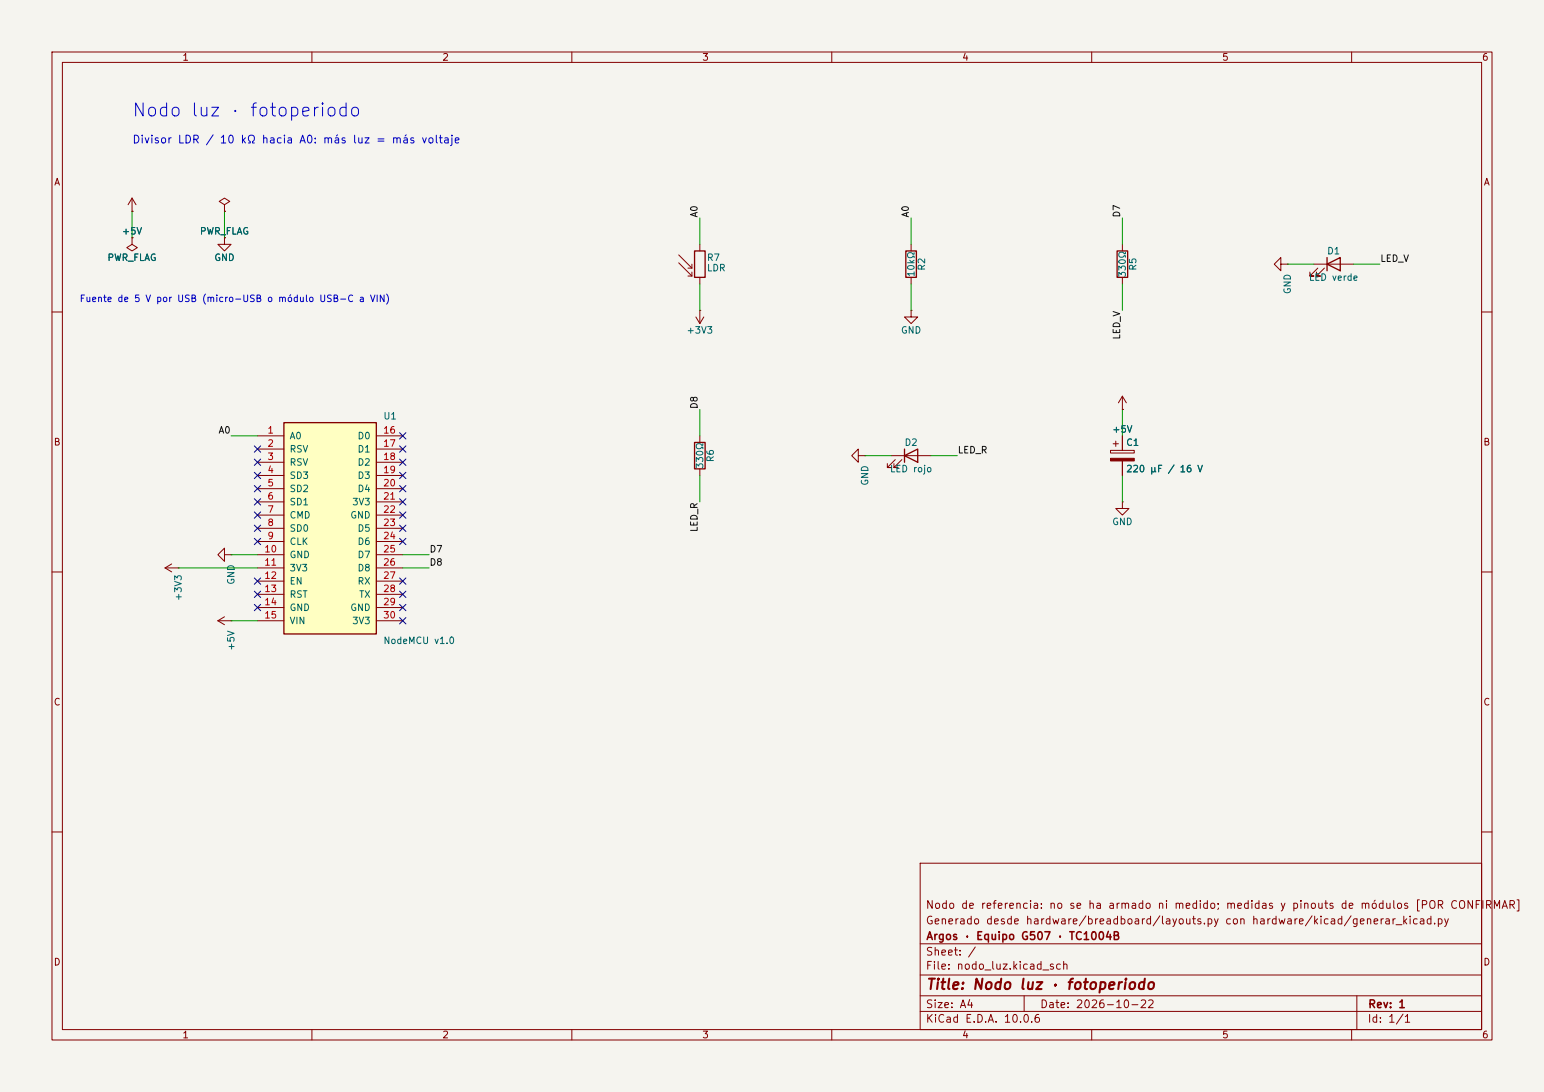
[picture p121: page 1]

Divisor LDR / 10 kΩ hacia A0: más luz = más voltaje

Generado desde hardware/breadboard/layouts.py con hardware/kicad/generar_kicad.py
Argos · Equipo G507 · TC1004B
Sheet: /
File: nodo_luz.kicad_sch
Title: Nodo luz · fotoperiodo

Size: A4 | Rev: 1
KiCad E.D.A. 10.0.6 | Id: 1/1
