cyuxSz/Argos-equipo/1_electronica/kicad/pdf_svg/nodo_luz_rele.pdf

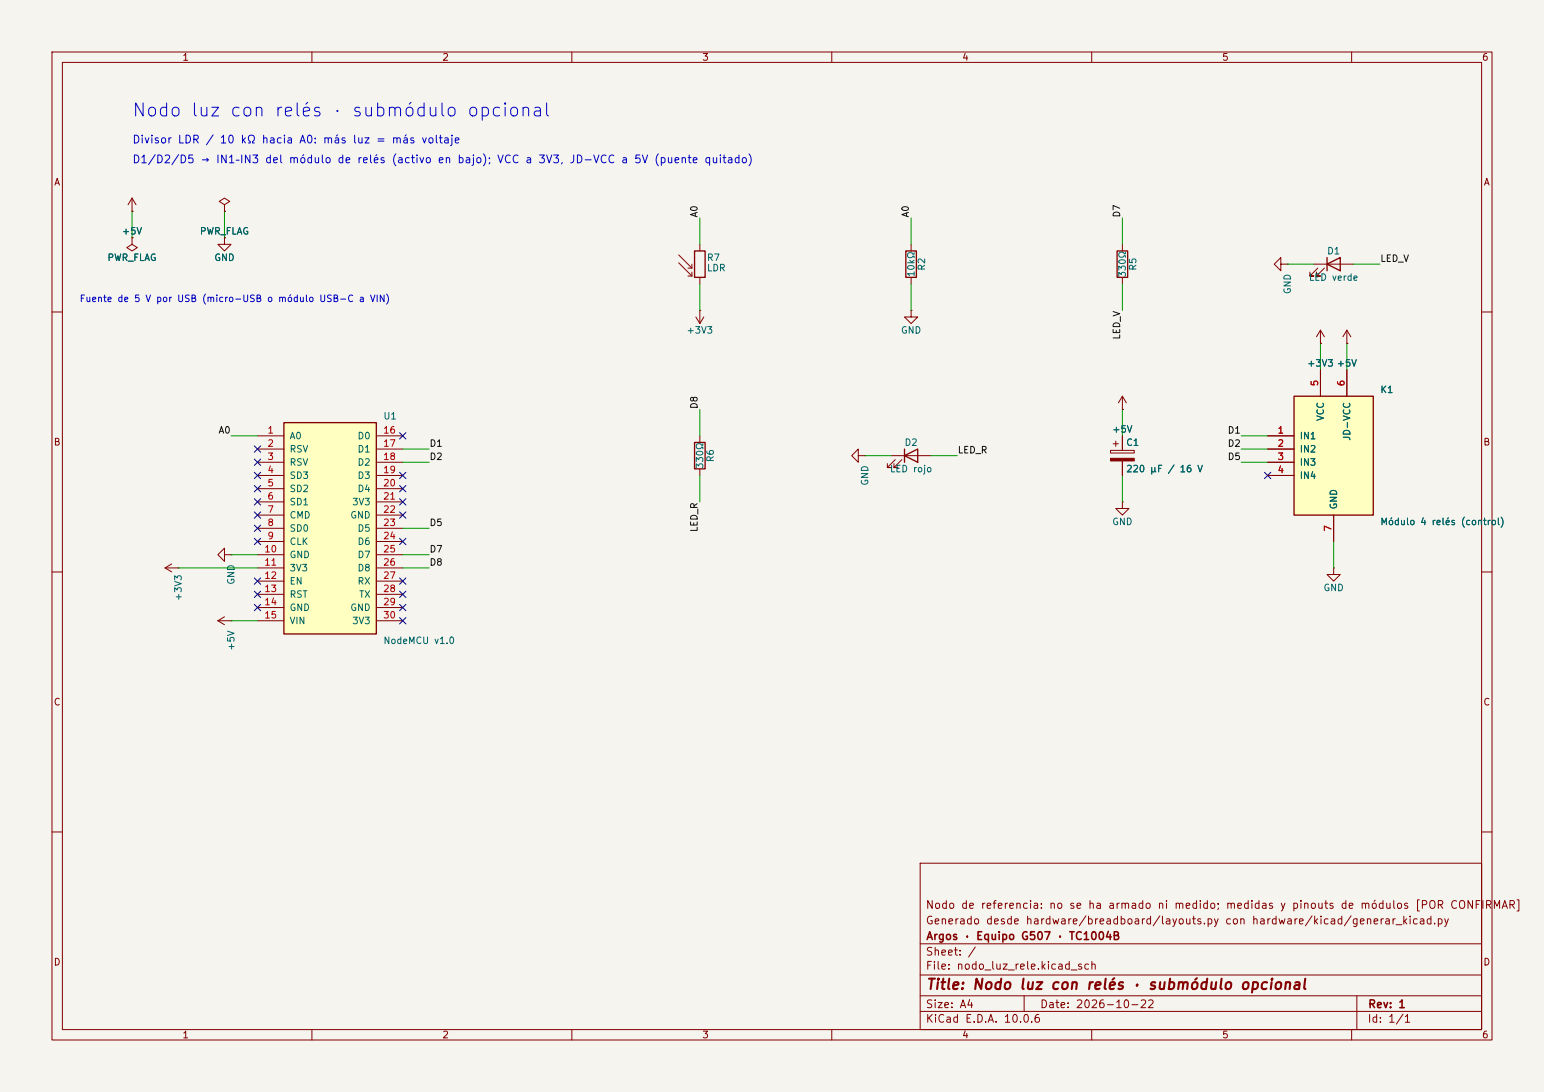
[picture p122: page 1]

Nodo luz con relés · submódulo opcional

Divisor LDR / 10 kΩ hacia A0: más luz = más voltaje
D1/D2/D5 → IN1–IN3 del módulo de relés (activo en bajo); VCC a 3V3, JD-VCC a 5V (puente quitado)

Fuente de 5 V por USB (micro-USB o módulo USB-C a VIN)

Generado desde hardware/breadboard/layouts.py con hardware/kicad/generar_kicad.py
Argos · Equipo G507 · TC1004B
Sheet: /
File: nodo_luz_rele.kicad_sch
Title: Nodo luz con relés · submódulo opcional

Size: A4 | Rev: 1
KiCad E.D.A. 10.0.6 | Id: 1/1
