cyuxSz/Argos-equipo/1_electronica/kicad/pdf_svg/nodo_pir.pdf

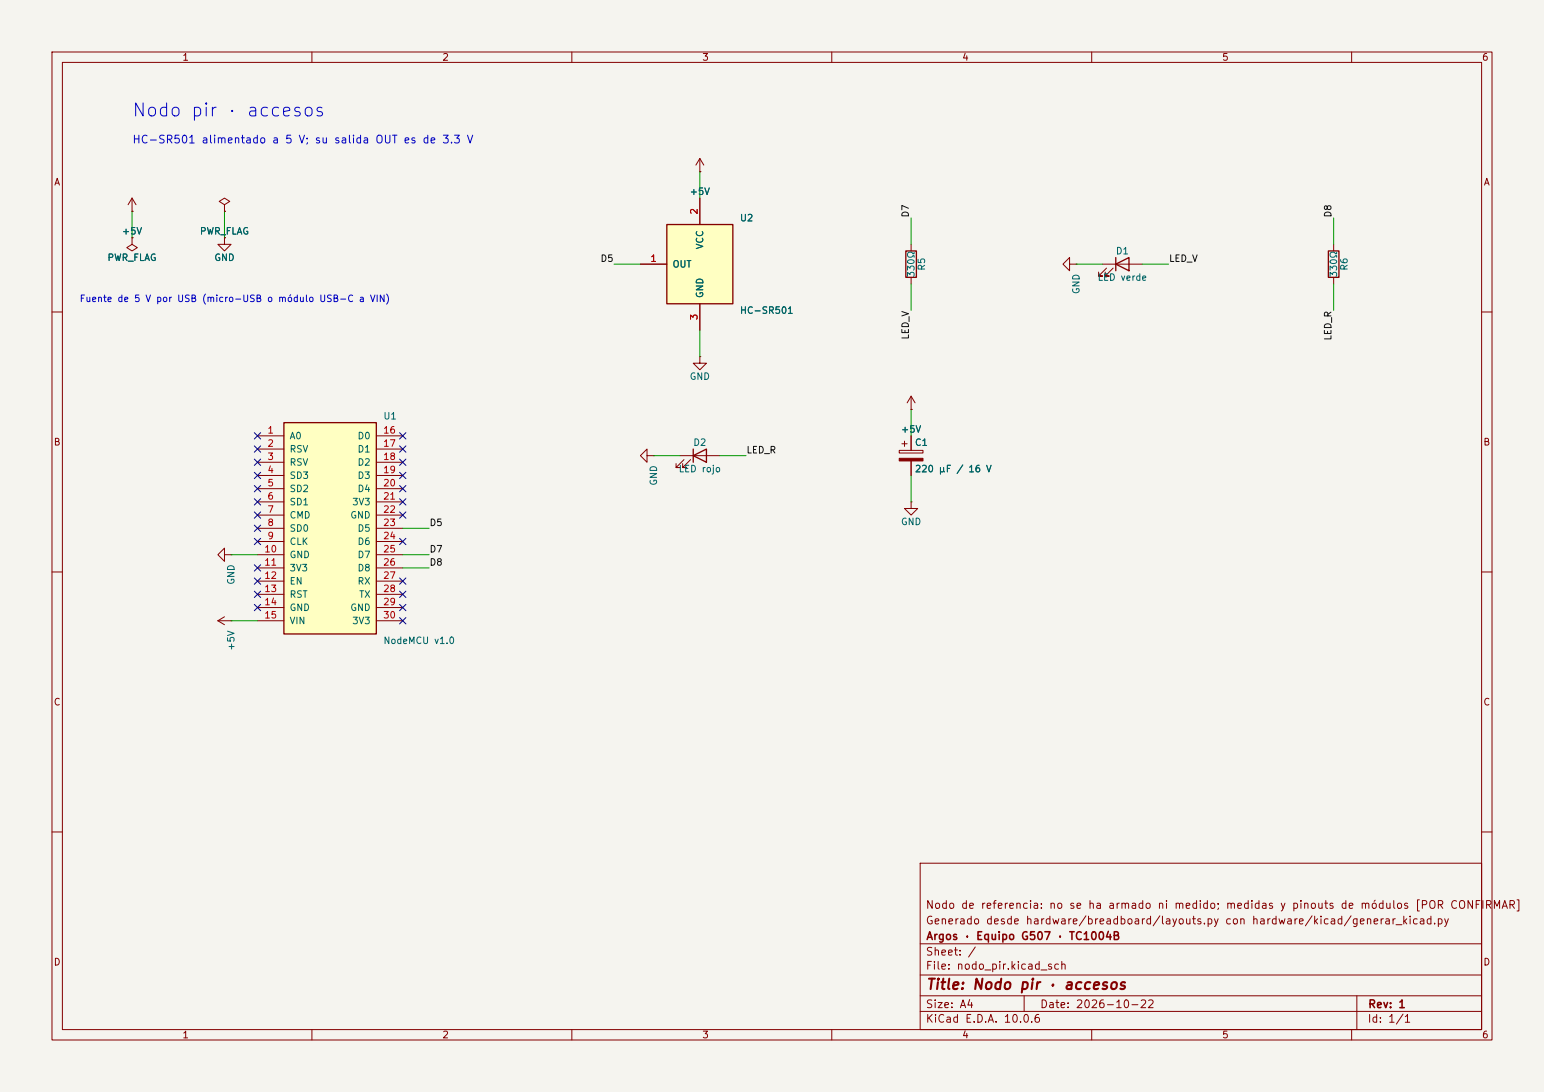
[picture p123: page 1]

HC-SR501 alimentado a 5 V; su salida OUT es de 3.3 V
PWR_FLAGGND

Fuente de 5 V por USB (micro-USB o módulo USB-C a VIN)

Generado desde hardware/breadboard/layouts.py con hardware/kicad/generar_kicad.py
Argos · Equipo G507 · TC1004B
Sheet: /
File: nodo_pir.kicad_sch
Title: Nodo pir · accesos

Size: A4 | Rev: 1
KiCad E.D.A. 10.0.6 | Id: 1/1
