cyuxSz/Argos-equipo/1_electronica/kicad/pdf_svg/nodo_puerta.pdf

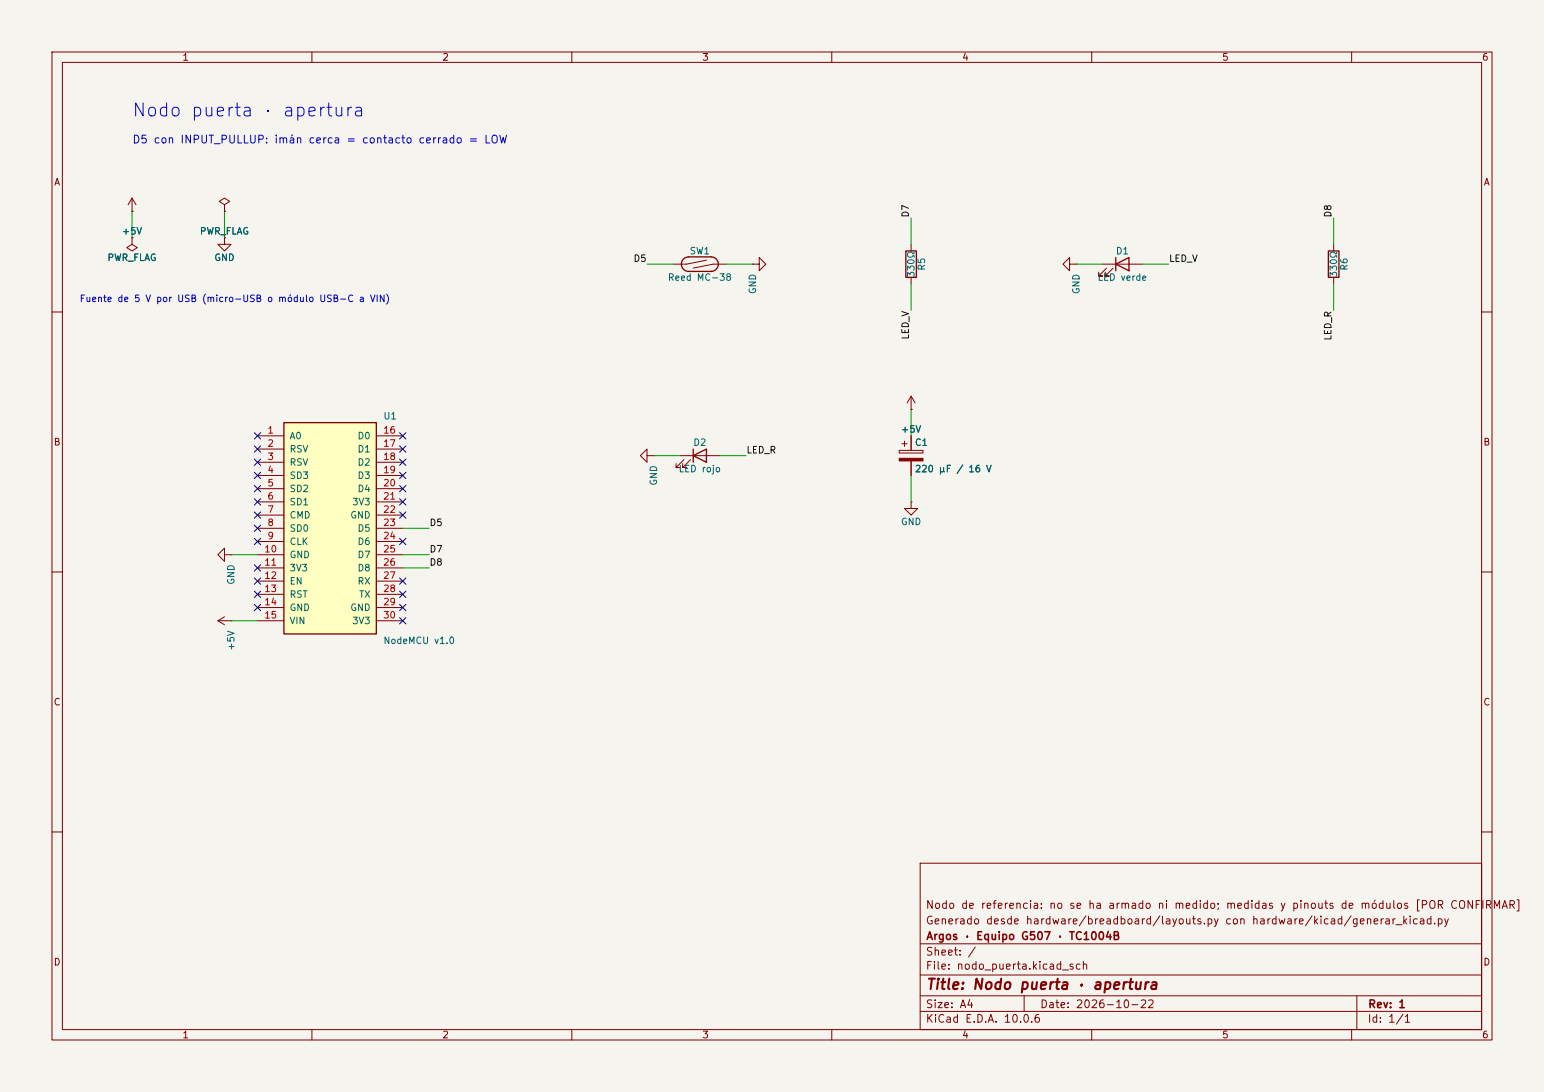
[picture p124: page 1]

D5 con INPUT_PULLUP: imán cerca = contacto cerrado = LOW

Nodo de referencia: no se ha armado ni medido; medidas y pinouts de módulos [POR CONFIRMAR]
Generado desde hardware/breadboard/layouts.py con hardware/kicad/generar_kicad.py
Argos · Equipo G507 · TC1004B
Sheet: /
File: nodo_puerta.kicad_sch
Title: Nodo puerta · apertura

Size: A4 | Rev: 1
KiCad E.D.A. 10.0.6 | Id: 1/1
