cyuxSz/Argos-equipo/(list of files, drawings)

Other design files:
1_electronica/fritzing/nodo_acel.fzz
1_electronica/fritzing/nodo_dht.fzz
1_electronica/fritzing/nodo_luz.fzz
1_electronica/fritzing/nodo_pir.fzz
1_electronica/fritzing/nodo_puerta.fzz
