cyuxSz/Argos-equipo/1_electronica/kicad/arbol_alimentacion.kicad_sch

## KiCad design 1_electronica/kicad/arbol_alimentacion.kicad_sch (2026-11-09)

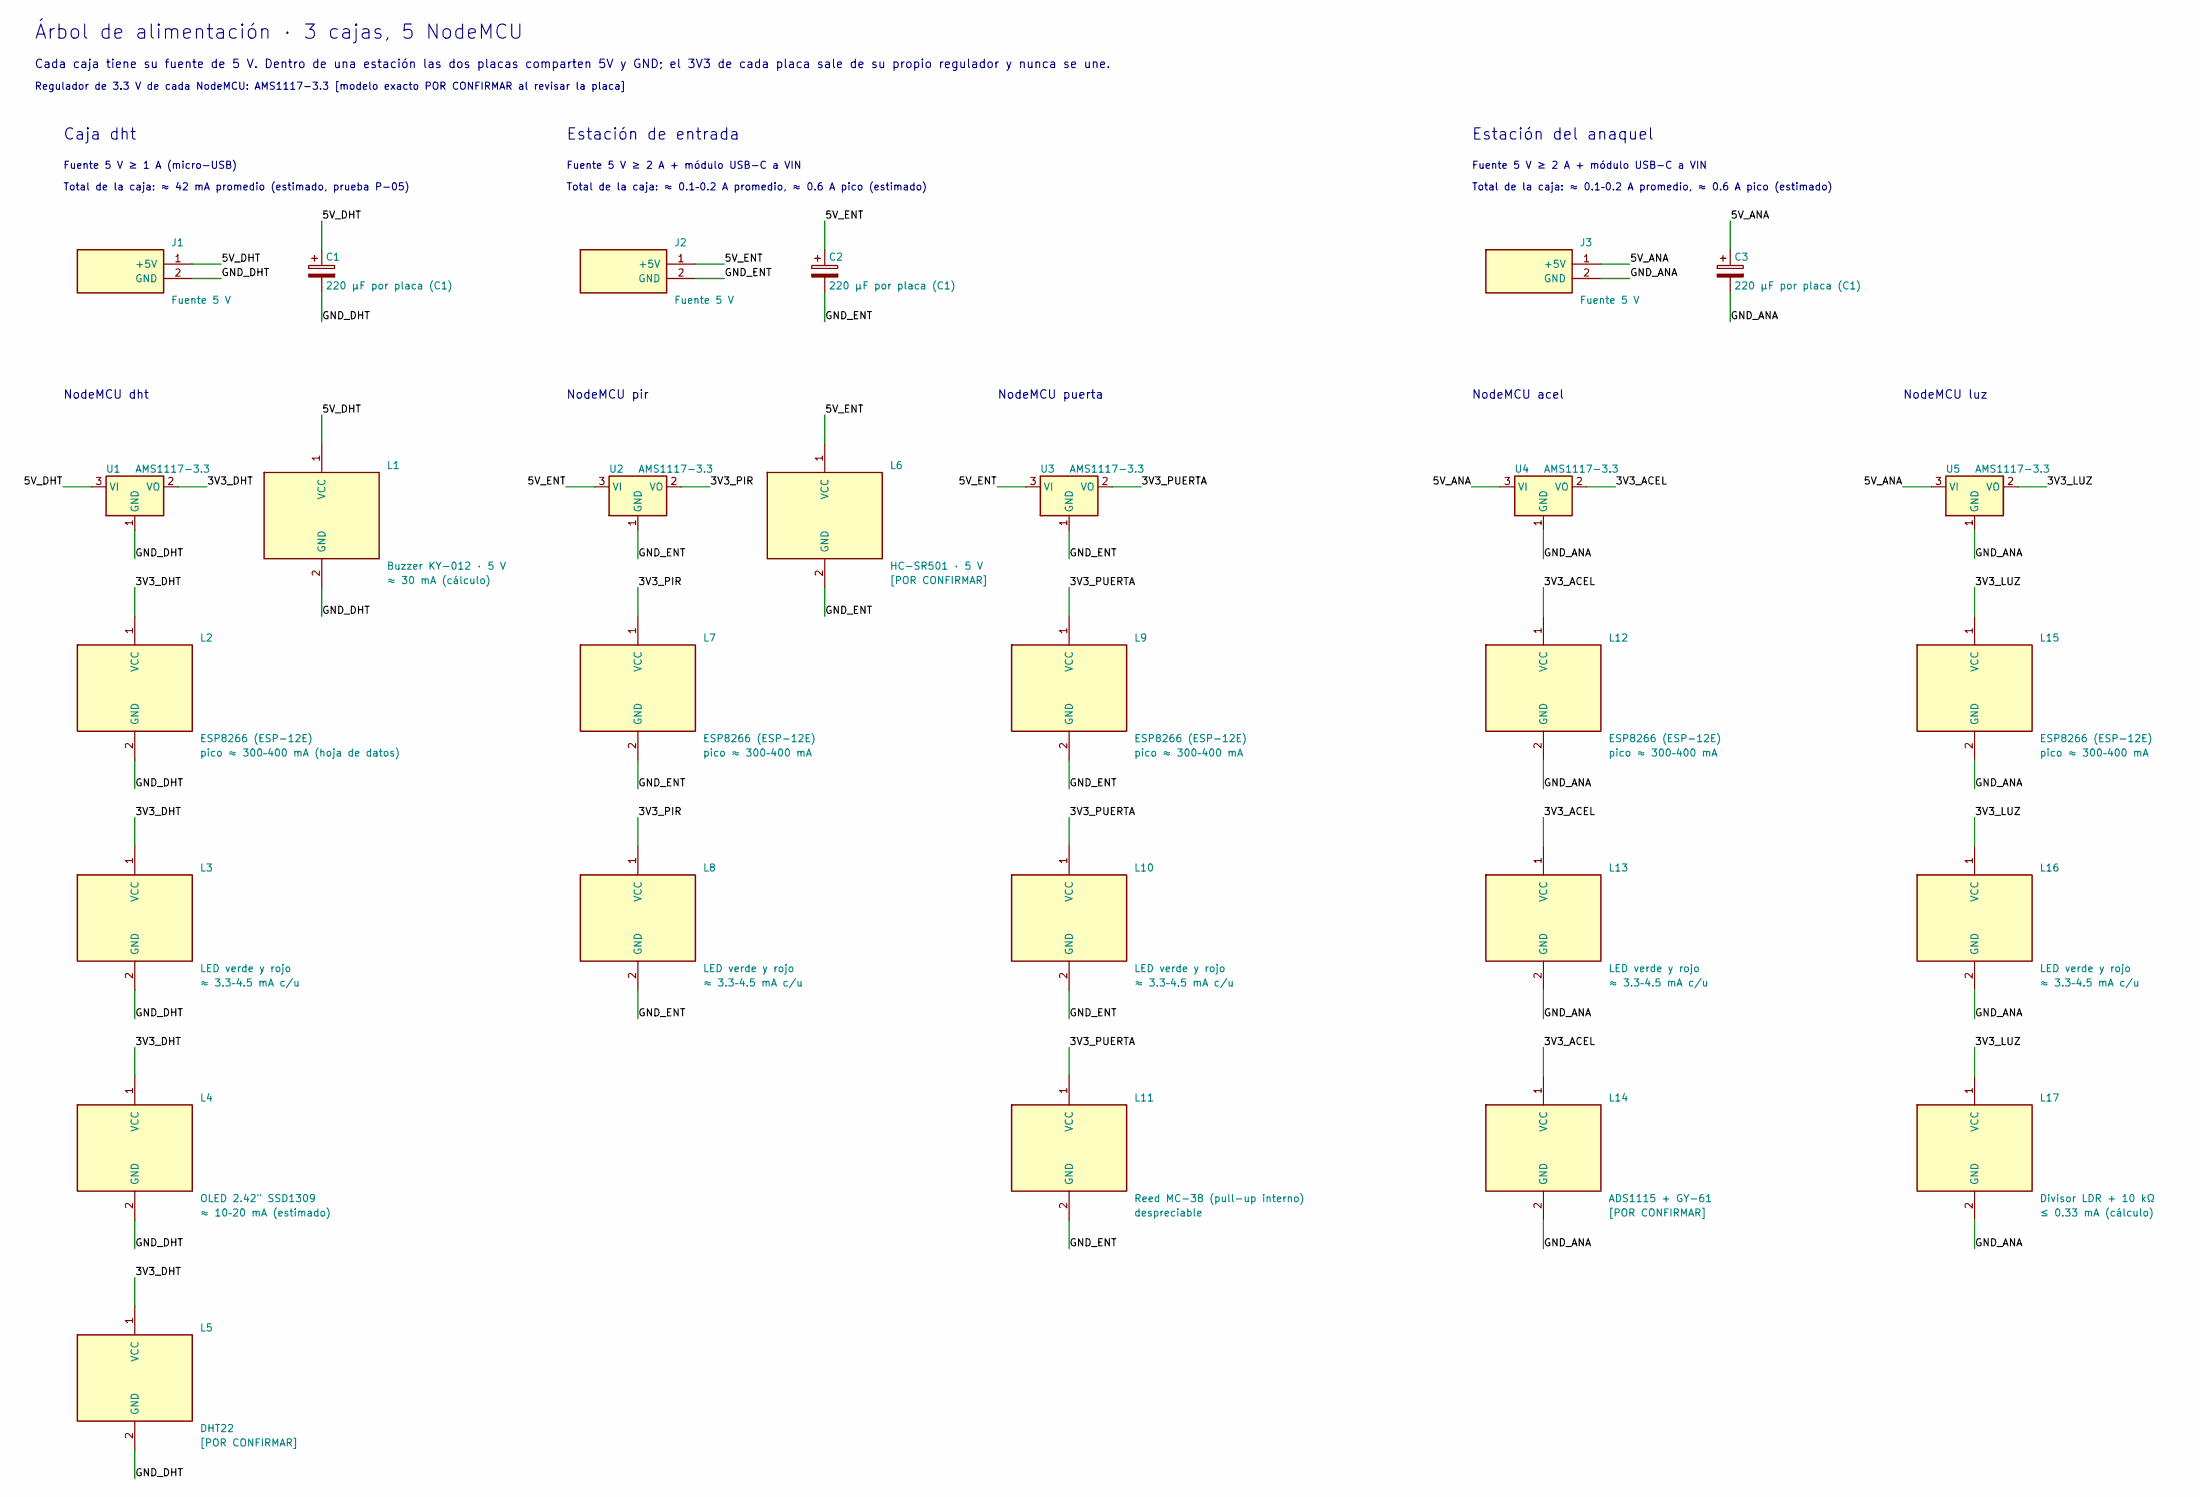
[picture p125: schematic arbol_alimentacion.kicad_sch]

Parts:
C1, C2, C3: 220 µF por placa (C1)
J1, J2, J3: Fuente 5 V
L1: Buzzer KY-012 · 5 V
L2, L7, L9, L12, L15: ESP8266 (ESP-12E)
L3, L8, L10, L13, L16: LED verde y rojo
L4: OLED 2.42" SSD1309
L5: DHT22
L6: HC-SR501 · 5 V
L11: Reed MC-38 (pull-up interno)
L14: ADS1115 + GY-61
L17: Divisor LDR + 10 kΩ
U1, U2, U3, U4, U5: AMS1117-3.3

Connections:
3V3_ACEL: L12.1 (VCC), L13.1 (VCC), L14.1 (VCC), U4.2 (VO)
3V3_DHT: L2.1 (VCC), L3.1 (VCC), L4.1 (VCC), L5.1 (VCC), U1.2 (VO)
3V3_LUZ: L15.1 (VCC), L16.1 (VCC), L17.1 (VCC), U5.2 (VO)
3V3_PIR: L7.1 (VCC), L8.1 (VCC), U2.2 (VO)
3V3_PUERTA: L9.1 (VCC), L10.1 (VCC), L11.1 (VCC), U3.2 (VO)
5V_ANA: C3.1, J3.1 (+5V), U4.3 (VI), U5.3 (VI)
5V_DHT: C1.1, J1.1 (+5V), L1.1 (VCC), U1.3 (VI)
5V_ENT: C2.1, J2.1 (+5V), L6.1 (VCC), U2.3 (VI), U3.3 (VI)
GND_ANA: C3.2, J3.2 (GND), L12.2 (GND), L13.2 (GND), L14.2 (GND), L15.2 (GND), L16.2 (GND), L17.2 (GND), U4.1 (GND), U5.1 (GND)
GND_DHT: C1.2, J1.2 (GND), L1.2 (GND), L2.2 (GND), L3.2 (GND), L4.2 (GND), L5.2 (GND), U1.1 (GND)
GND_ENT: C2.2, J2.2 (GND), L6.2 (GND), L7.2 (GND), L8.2 (GND), L9.2 (GND), L10.2 (GND), L11.2 (GND), U2.1 (GND), U3.1 (GND)

Notes on the sheet:
Árbol de alimentación · 3 cajas, 5 NodeMCU
Cada caja tiene su fuente de 5 V. Dentro de una estación las dos placas comparten 5V y GND; el 3V3 de cada placa sale de su propio regulador y nunca se une.
Regulador de 3.3 V de cada NodeMCU: AMS1117-3.3 [modelo exacto POR CONFIRMAR al revisar la placa]
Caja dht
Fuente 5 V ≥ 1 A (micro-USB)
Total de la caja: ≈ 42 mA promedio (estimado, prueba P-05)
NodeMCU dht
Estación de entrada
Fuente 5 V ≥ 2 A + módulo USB-C a VIN
Total de la caja: ≈ 0.1–0.2 A promedio, ≈ 0.6 A pico (estimado)
NodeMCU pir
NodeMCU puerta
Estación del anaquel
NodeMCU acel
NodeMCU luz
