cyuxSz/Argos-equipo/1_electronica/kicad/caja_potencia.kicad_sch

## KiCad design 1_electronica/kicad/caja_potencia.kicad_sch (2026-11-09)

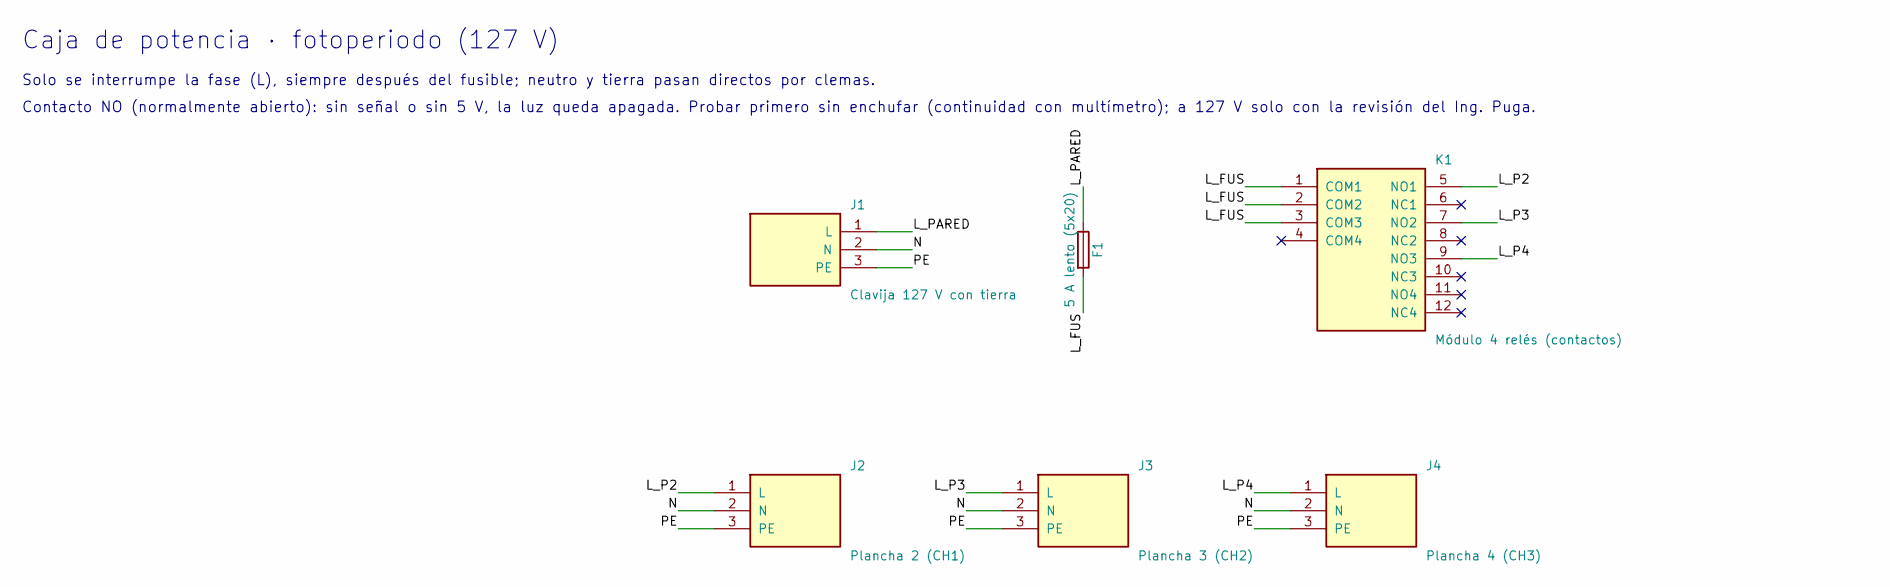
[picture p126: schematic caja_potencia.kicad_sch]

Parts:
F1: 5 A lento (5x20)
J1: Clavija 127 V con tierra
J2: Plancha 2 (CH1)
J3: Plancha 3 (CH2)
J4: Plancha 4 (CH3)
K1: Módulo 4 relés (contactos)

Connections:
L_FUS: F1.2, K1.1 (COM1), K1.2 (COM2), K1.3 (COM3)
L_P2: J2.1 (L), K1.5 (NO1)
L_P3: J3.1 (L), K1.7 (NO2)
L_P4: J4.1 (L), K1.9 (NO3)
L_PARED: F1.1, J1.1 (L)
N: J1.2 (N), J2.2 (N), J3.2 (N), J4.2 (N)
PE: J1.3 (PE), J2.3 (PE), J3.3 (PE), J4.3 (PE)

Notes on the sheet:
Caja de potencia · fotoperiodo (127 V)
Solo se interrumpe la fase (L), siempre después del fusible; neutro y tierra pasan directos por clemas.
Contacto NO (normalmente abierto): sin señal o sin 5 V, la luz queda apagada. Probar primero sin enchufar (continuidad con multímetro); a 127 V solo con la revisión del Ing. Puga.
