cyuxSz/Argos-equipo/1_electronica/kicad/nodo_acel.kicad_sch

## KiCad design 1_electronica/kicad/nodo_acel.kicad_sch (2026-11-09)

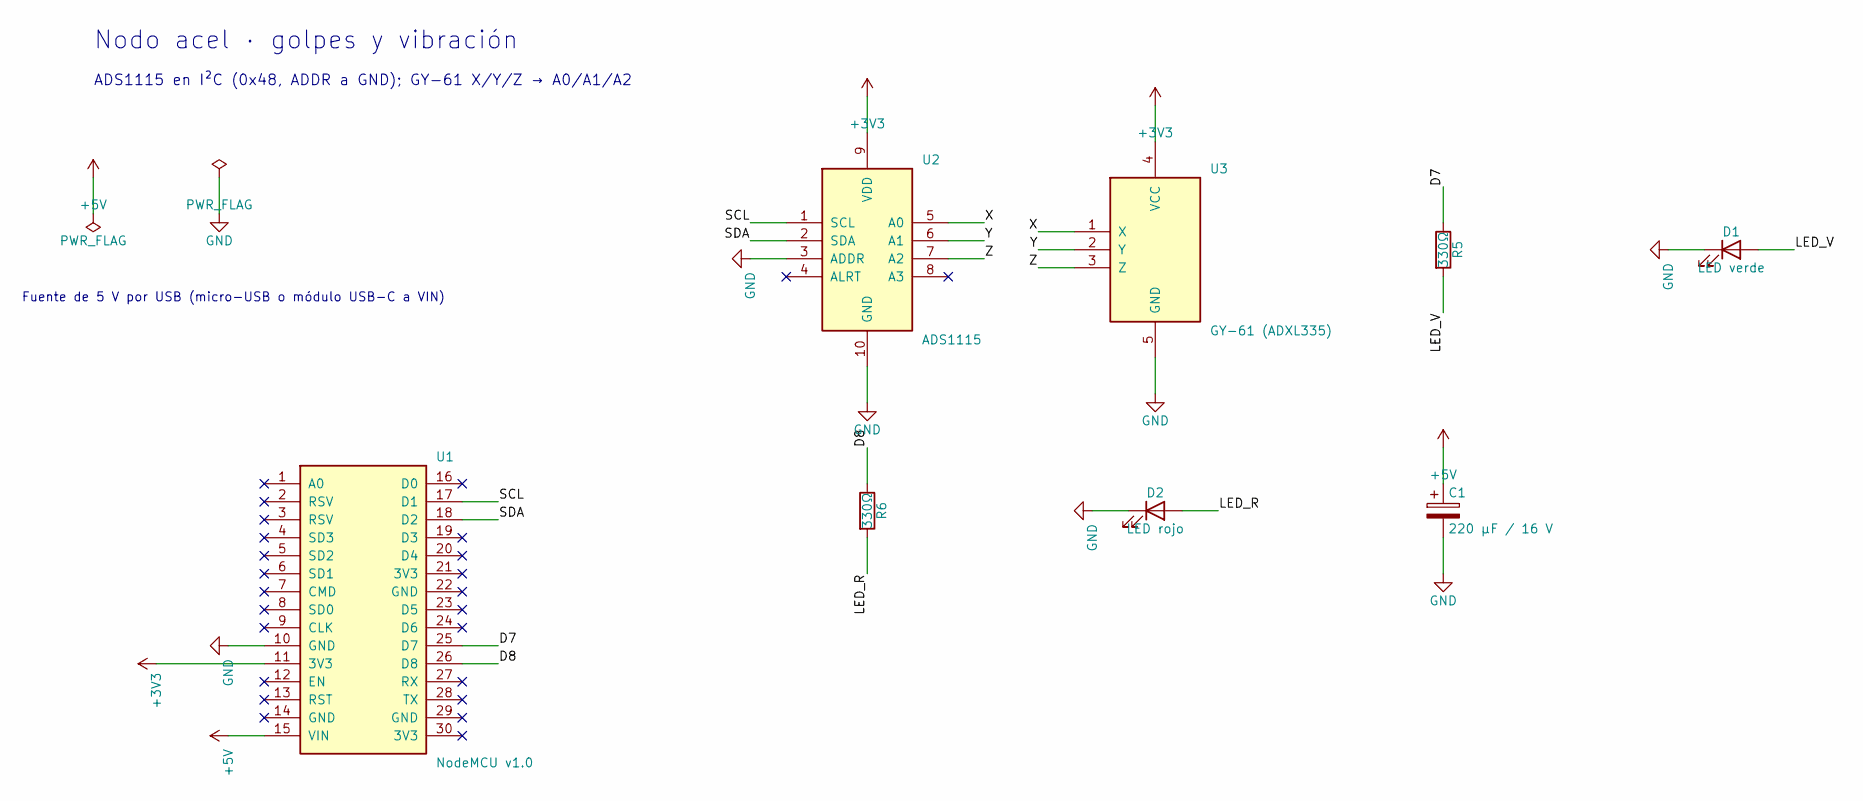
[picture p127: schematic nodo_acel.kicad_sch]

Parts:
C1: 220 µF / 16 V
D1: LED verde
D2: LED rojo
R5, R6: 330Ω
U1: NodeMCU v1.0
U2: ADS1115
U3: GY-61 (ADXL335)

Connections:
+3V3: U1.11 (3V3), U2.9 (VDD), U3.4 (VCC)
+5V: C1.1, U1.15 (VIN)
D7: R5.1, U1.25 (D7)
D8: R6.1, U1.26 (D8)
GND: C1.2, D1.1 (K), D2.1 (K), U1.10 (GND), U2.3 (ADDR), U2.10 (GND), U3.5 (GND)
LED_R: D2.2 (A), R6.2
LED_V: D1.2 (A), R5.2
SCL: U1.17 (D1), U2.1 (SCL)
SDA: U1.18 (D2), U2.2 (SDA)
X: U2.5 (A0), U3.1 (X)
Y: U2.6 (A1), U3.2 (Y)
Z: U2.7 (A2), U3.3 (Z)

Notes on the sheet:
Nodo acel · golpes y vibración
Fuente de 5 V por USB (micro-USB o módulo USB-C a VIN)
ADS1115 en I²C (0x48, ADDR a GND); GY-61 X/Y/Z → A0/A1/A2
