cyuxSz/Argos-equipo/1_electronica/kicad/nodo_dht.kicad_sch

## KiCad design 1_electronica/kicad/nodo_dht.kicad_sch (2026-11-09)

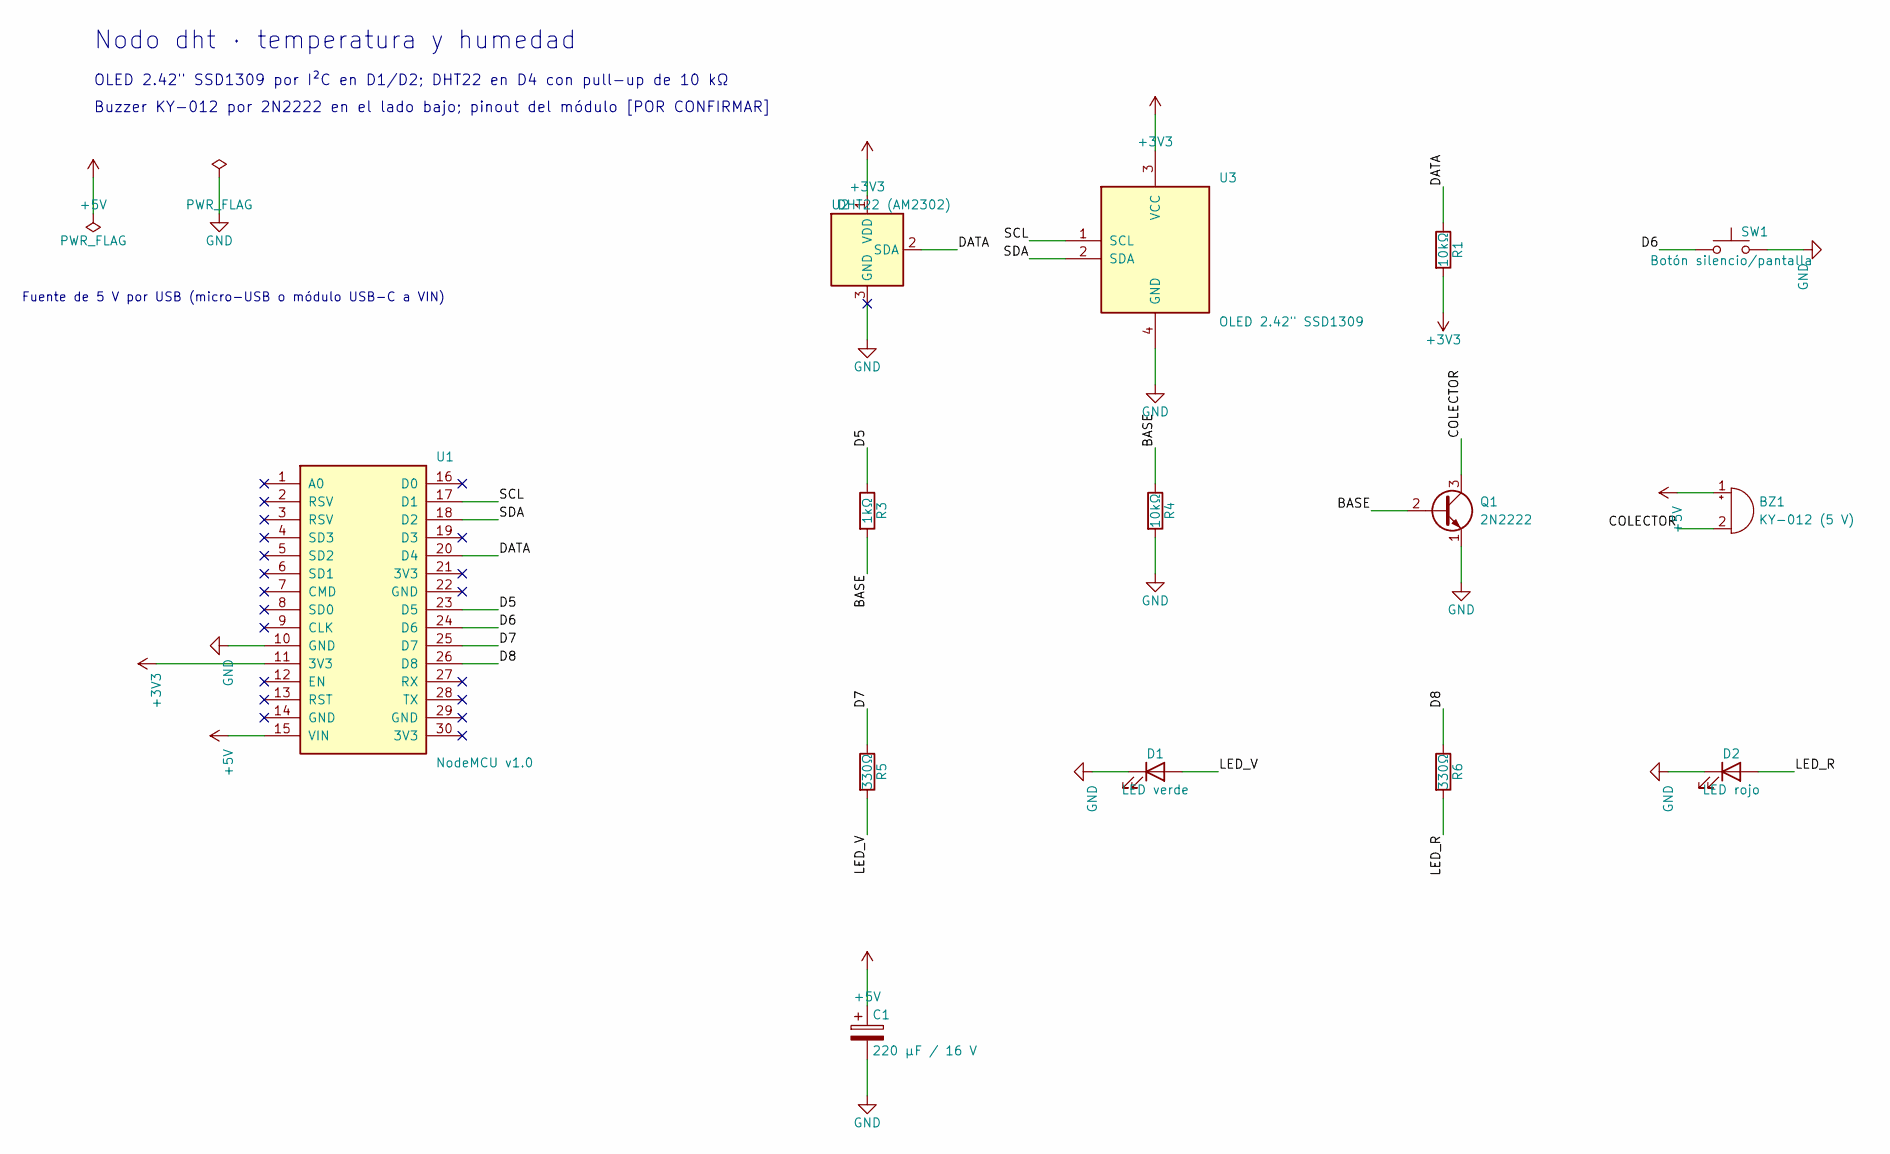
[picture p128: schematic nodo_dht.kicad_sch]

Parts:
BZ1: KY-012 (5 V)
C1: 220 µF / 16 V
D1: LED verde
D2: LED rojo
Q1: 2N2222
R1, R4: 10kΩ
R3: 1kΩ
R5, R6: 330Ω
SW1: Botón silencio/pantalla
U1: NodeMCU v1.0
U2: DHT22 (AM2302)
U3: OLED 2.42" SSD1309

Connections:
+3V3: R1.2, U1.11 (3V3), U2.1 (VDD), U3.3 (VCC)
+5V: BZ1.1 (+), C1.1, U1.15 (VIN)
BASE: Q1.2 (B), R3.2, R4.1
COLECTOR: BZ1.2 (-), Q1.3 (C)
D5: R3.1, U1.23 (D5)
D6: SW1.1, U1.24 (D6)
D7: R5.1, U1.25 (D7)
D8: R6.1, U1.26 (D8)
DATA: R1.1, U1.20 (D4), U2.2 (SDA)
GND: C1.2, D1.1 (K), D2.1 (K), Q1.1 (E), R4.2, SW1.2, U1.10 (GND), U2.3 (GND), U2.4 (GND), U3.4 (GND)
LED_R: D2.2 (A), R6.2
LED_V: D1.2 (A), R5.2
SCL: U1.17 (D1), U3.1 (SCL)
SDA: U1.18 (D2), U3.2 (SDA)

Notes on the sheet:
Nodo dht · temperatura y humedad
Fuente de 5 V por USB (micro-USB o módulo USB-C a VIN)
OLED 2.42" SSD1309 por I²C en D1/D2; DHT22 en D4 con pull-up de 10 kΩ
Buzzer KY-012 por 2N2222 en el lado bajo; pinout del módulo [POR CONFIRMAR]
