cyuxSz/Argos-equipo/1_electronica/kicad/nodo_luz.kicad_sch

## KiCad design 1_electronica/kicad/nodo_luz.kicad_sch (2026-11-09)

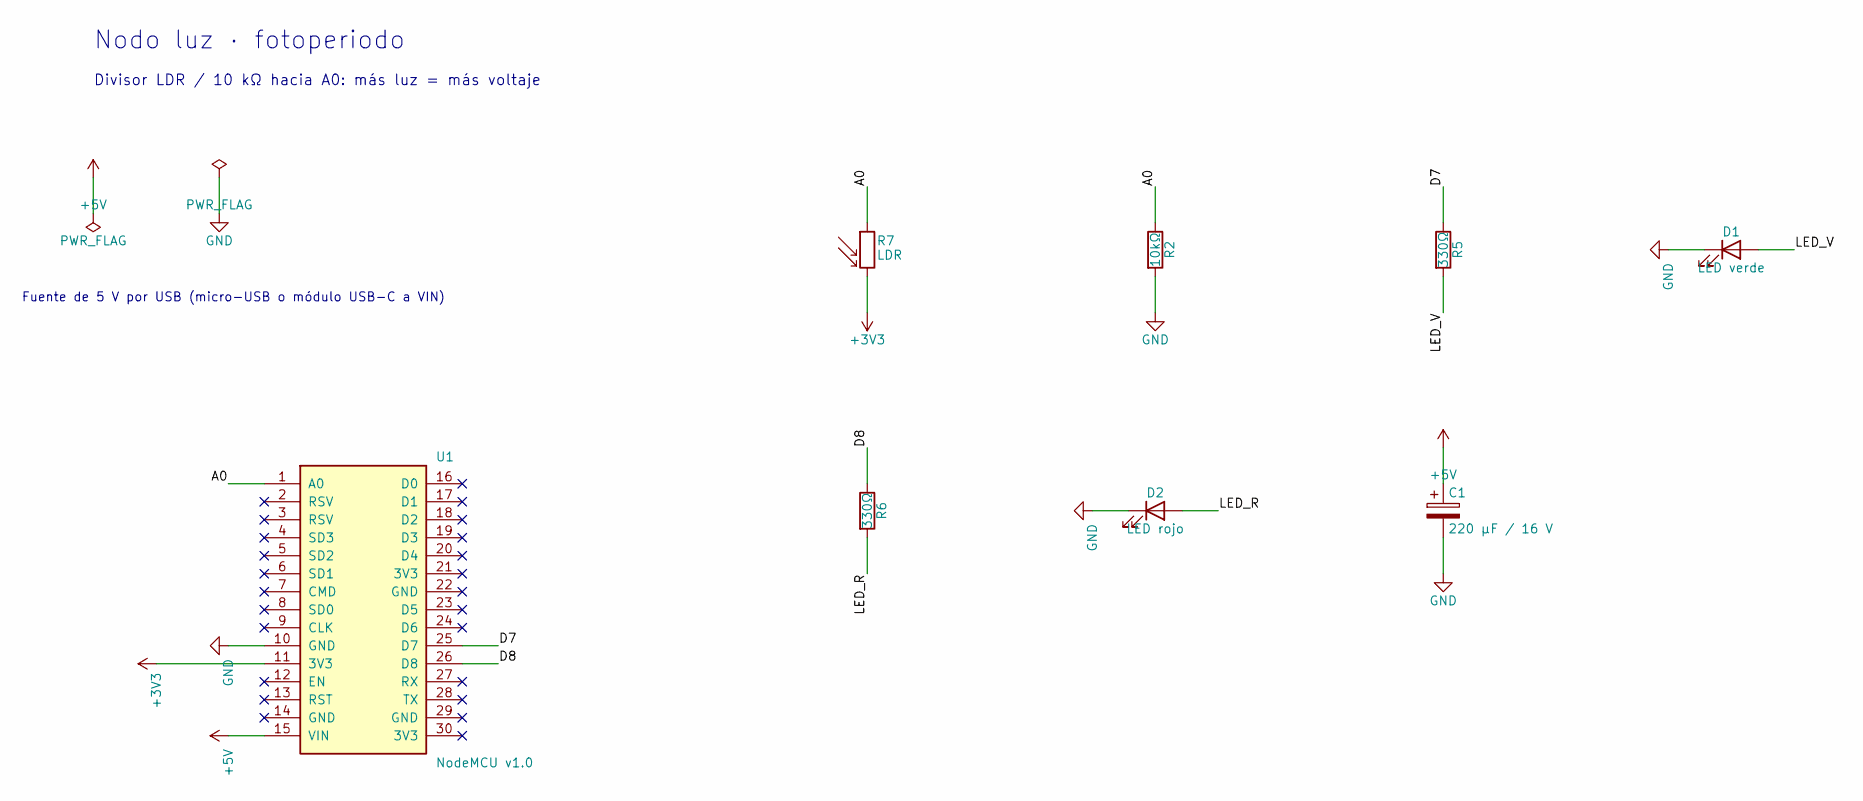
[picture p129: schematic nodo_luz.kicad_sch]

Parts:
C1: 220 µF / 16 V
D1: LED verde
D2: LED rojo
R2: 10kΩ
R5, R6: 330Ω
R7: LDR
U1: NodeMCU v1.0

Connections:
+3V3: R7.2, U1.11 (3V3)
+5V: C1.1, U1.15 (VIN)
A0: R2.1, R7.1, U1.1 (A0)
D7: R5.1, U1.25 (D7)
D8: R6.1, U1.26 (D8)
GND: C1.2, D1.1 (K), D2.1 (K), R2.2, U1.10 (GND)
LED_R: D2.2 (A), R6.2
LED_V: D1.2 (A), R5.2

Notes on the sheet:
Nodo luz · fotoperiodo
Fuente de 5 V por USB (micro-USB o módulo USB-C a VIN)
Divisor LDR / 10 kΩ hacia A0: más luz = más voltaje
