cyuxSz/Argos-equipo/1_electronica/kicad/nodo_pir.kicad_sch

## KiCad design 1_electronica/kicad/nodo_pir.kicad_sch (2026-11-09)

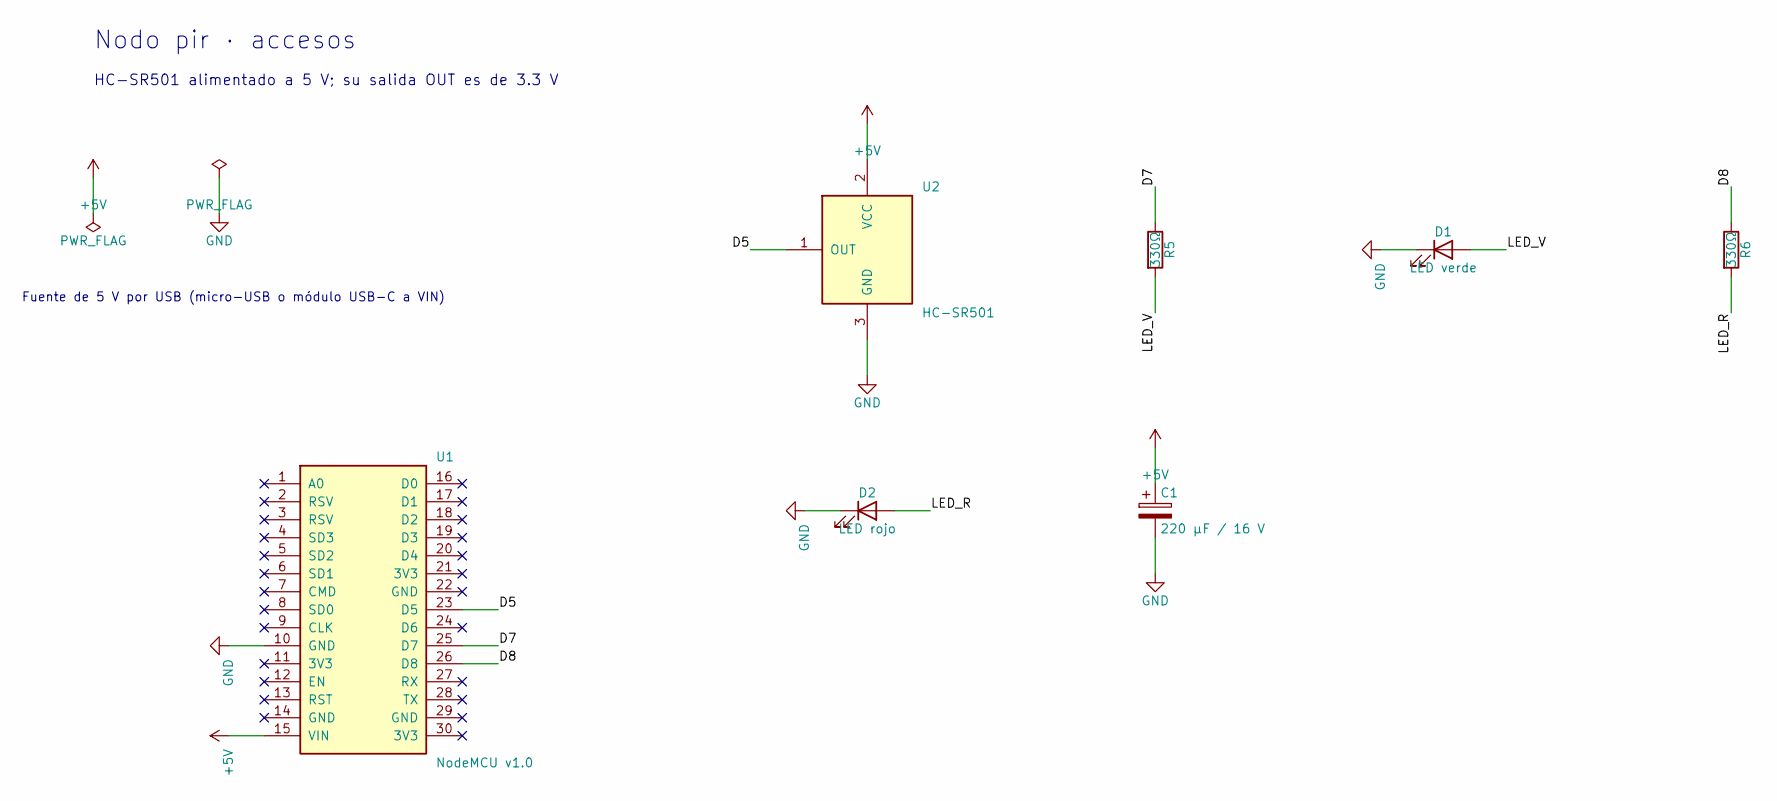
[picture p130: schematic nodo_pir.kicad_sch]

Parts:
C1: 220 µF / 16 V
D1: LED verde
D2: LED rojo
R5, R6: 330Ω
U1: NodeMCU v1.0
U2: HC-SR501

Connections:
+5V: C1.1, U1.15 (VIN), U2.2 (VCC)
D5: U1.23 (D5), U2.1 (OUT)
D7: R5.1, U1.25 (D7)
D8: R6.1, U1.26 (D8)
GND: C1.2, D1.1 (K), D2.1 (K), U1.10 (GND), U2.3 (GND)
LED_R: D2.2 (A), R6.2
LED_V: D1.2 (A), R5.2

Notes on the sheet:
Nodo pir · accesos
Fuente de 5 V por USB (micro-USB o módulo USB-C a VIN)
HC-SR501 alimentado a 5 V; su salida OUT es de 3.3 V
