cyuxSz/Argos-equipo/3_firmware/firmware/arduino_ide/argos_acel/secrets.example.h

// Plantilla sin valores. Copiar a secrets.h (no versionado) y llenar ahi.
#pragma once

#define WIFI_SSID ""
#define WIFI_PASSWORD ""
#define MQTT_HOST ""
#define MQTT_PORT 1883
#define MQTT_PASSWORD ""
// API REST (normalmente el mismo servidor que MQTT; nginx la sirve en el puerto 80 bajo /api/)
#define API_HOST ""
#define API_PORT 80
#define API_KEY ""
