cyuxSz/Argos-equipo/(commit log)

2026-11-09 Repositorio del equipo: plan y material por frente
    Repositorio de lectura para organizar al equipo de Argos: PLAN.md con la
    auditoría, el calendario y los 5 frentes, y una carpeta por frente con
    guías, diagramas, modelos, firmware y servidor. Sin claves.
    [acc_ldr_cable.stl, acc_ldr_capuchon.stl, acc_ldr_difusor.stl, acc_ldr_ldr.stl, acc_ldr_soporte.stl, acc_mc38_calza.stl, acc_mc38_cuerpo_iman.stl, acc_mc38_cuerpo_sensor.stl]
2026-11-09 Diagramas vigentes y calendario desde el 10 de noviembre
    Arquitectura y despliegue rehechos en Graphviz: servidor en la laptop con
    Windows 11 (Docker Desktop), API Node.js como única escritora en MySQL y
    motor de alertas, n8n solo avisos. Flujo del firmware con el envío HTTP.
    Calendario con arranque el martes 10 de noviembre.
2026-11-09 Muestra el flujo del firmware en el README de 3_firmware
2026-11-10 Carcasas: variante modular con clips y tareas de forma e identidad
    - Modelo base de las tres cajas con clips de protoboard, tapa a presión sin tornillos y grapa de la OLED.
    - Renders, STL y cupón de clips; guía con verificación e ideas de forma.
    - Frente 2: investigar uniones a presión y proponer la identidad de las cajas.
    [nodo_anaquel_base.stl, nodo_anaquel_capuchon_ldr.stl, nodo_anaquel_difusor_ldr.stl, nodo_anaquel_rele_base.stl, nodo_anaquel_rele_tapa.stl, nodo_anaquel_soporte_ldr.stl, nodo_anaquel_tapa.stl, nodo_dht_base.stl]
2026-11-10 Frente 2: guía de ideas de forma e identidad para investigar y decidir
